YTU-YODA-KYBER/2026_teknofest-mikrodenetleyici-tasarimi/FPGA/verification/vivado_reports/code_coverage/index.html

# Code Coverage Raporları

YTU YODA KYBER · TEKNOFEST 2026 Çip Tasarım Yarışması
Vivado XSim 2025.2 · xelab --cc_type sbct (statement + branch + condition + toggle)
Üretim: 2026-08-07 23:41 · I2C güncelleme: 2026-09-06 11:04

Blok | Modül | Statement | Branch | Condition | Toggle | Rapor
AI_Accelerator | conv_accelerator | 99.32 | 98.36 | 100.00 | 68.53 | aç →
| yz_csr_wrapper | 95.24 | 85.71 | 100.00 | 33.33
| conv_buf_ram | 100.00 | 100.00 | — | 19.05
| weights_rom_p8 | 100.00 | — | — | —
| fc_weights_rom_p4 | 100.00 | — | — | —
GPIO | GPIO_AXI4_Lite | 100.00 | 92.31 | 100.00 | 60.00 | aç →
I2C | I2C_Master_AXI4_Lite_default | 96.22 | 78.08 | 92.86 | 6.99 | aç →
QSPI | QSPI_Master_AXI4_Lite | 92.86 | 80.42 | 91.67 | 27.57 | aç →
Timer | Timer_AXI4_Lite | 91.30 | 78.12 | 87.50 | 11.11 | aç →
UART_GU | UART_GU_AXI4_Lite | 96.52 | 83.64 | 100.00 | 10.63 | aç →
UART_YZ | UART_YZ_AXI4_Lite | 95.04 | 82.14 | 100.00 | 10.63 | aç →

Yüzdeler tasarım modülünün kendi skorudur; testbench, AXI protokol kontrolcüsü ve glbl dahil değildir. xcrg'nin dashboard'unda görünen toplam skor onları da saydığı için tasarımın kapsamını temsil etmez.

— işareti “kapsanmadı” değil, “ölçülecek madde yok” demektir. Ağırlık ROM'larında tek bir if/case bulunmadığı için dal ve koşul maddesi sıfırdır; anlamlı gösterge statement skorudur. Toggle'da da payda ROM dizisinin tamamıdır (weights_rom_p8 80×64 = 5120 bit, fc_weights_rom_p4 4000×32 = 128.000 bit) — bu bitler $readmemh ile bir kez yüklenip simülasyon boyunca hiç değişmediği için toggle sayacı onları asla saymaz.

Çevre birimleri blok testbench'leri ile, YZ hızlandırıcı ise sistem testi (ai_accel_test.sv — CPU, UART ve DMA yolu dahil gerçek çıkarım akışı) ile ölçülmüştür; iki ölçüm doğrudan kıyaslanmamalıdır.

## Detaya nasıl inilir

Yukarıdaki aç → bağlantısı ilgili bloğun dashboard.html sayfasını açar. Oradan Modules ya da Files sekmesine geçip modül adına tıklarsanız kaynak kodu satır satır görürsünüz: yeşil satırlar test tarafından çalıştırılmış, kırmızı satırlar çalıştırılmamıştır. Bir klasörde çok sayıda HTML olmasının sebebi budur — her modül ve her kaynak dosya için ayrı bir detay sayfası üretilir; hepsi tek bir rapordur, bölünmemelidir.

## Metin özet

README.md — klasör yapısı, sonuç tabloları ve raporların nasıl okunacağı.
