YTU-YODA-KYBER/2026_teknofest-mikrodenetleyici-tasarimi/asic/reports/synthesis/deney_arsivi/ant28_m3a015_clean_success/README.md

# `ant28_m3a015_clean` — uc fazli temiz teslim kosumu

Zorunlu `make asic_run` hedefinin temiz, bastan sona kosumudur. Faz 1 taban
katman ayariyla adim 38'e, faz 2 met3=%15 ile adim 43'e, faz 3 met3=%15 ve
anten jumper overlay'iyle signoff sonuna gitmistir. Paket kapisi 79/79 gecti;
anten 926 net / 979 pin, setup +0.9975 ns, hold +0.0711 ns ve 16 zorunlu
metrik sifirdir. Buyuk akis dizini disk alani icin silinmis, teslim gorunumleri
`results/` altinda ve karar kanitlari burada korunmustur.
