YTU-YODA-KYBER/2026_teknofest-mikrodenetleyici-tasarimi/asic/reports/synthesis/deney_arsivi/gplprobe_die3000/README.md

# `gplprobe_die3000` — 4200x3000 die, phi 1.01

Gorev belgesinde hazir bekleyen ucuz die-kucultme probudur. GPL teknik olarak
11150. iterasyonda overflow 0.0999 ile bitti, fakat HPWL 30.967.840 um oldu;
5.912.343 um tabanin 5.238 katidir ve 10 milyon kabul sinirini gecmistir.
Sonuc RED; sonraki PnR/signoff adimlari kosulmadi.
