YTU-YODA-KYBER/2026_teknofest-mikrodenetleyici-tasarimi/asic/reports/signoff/full_disconnected_pins_table.txt

┏━━━━━━━━━━━━━━━━━━━━━━━━━━━━━━━━━━━┳━━━━━━━━━━━━━━━━━━━━━━━━━━━━━━━━━━━┳━━━━━━━━━━━━━━┳━━━━━━━━━━━━━━━━━━━━━━━━━━━━━━━━━━━┳━━━━━━━━━━━━━━━━━━━━━━━━━━━━━━━━━━━┓
┃ Macro/Instance                    ┃ Power Pins                        ┃ Disconnected ┃ Signal Pins                       ┃ Disconnected                      ┃
┡━━━━━━━━━━━━━━━━━━━━━━━━━━━━━━━━━━━╇━━━━━━━━━━━━━━━━━━━━━━━━━━━━━━━━━━━╇━━━━━━━━━━━━━━╇━━━━━━━━━━━━━━━━━━━━━━━━━━━━━━━━━━━╇━━━━━━━━━━━━━━━━━━━━━━━━━━━━━━━━━━━┩
│ conv_accelerator_inst.u_conv_buf… │ conv_accelerator_inst.u_conv_buf… │              │ conv_accelerator_inst.u_conv_buf… │ conv_accelerator_inst.u_conv_buf… │
│                                   │ conv_accelerator_inst.u_conv_buf… │              │ conv_accelerator_inst.u_conv_buf… │ conv_accelerator_inst.u_conv_buf… │
│                                   │                                   │              │ conv_accelerator_inst.u_conv_buf… │ conv_accelerator_inst.u_conv_buf… │
│                                   │                                   │              │ conv_accelerator_inst.u_conv_buf… │ conv_accelerator_inst.u_conv_buf… │
│                                   │                                   │              │ conv_accelerator_inst.u_conv_buf… │ conv_accelerator_inst.u_conv_buf… │
│                                   │                                   │              │ conv_accelerator_inst.u_conv_buf… │ conv_accelerator_inst.u_conv_buf… │
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
│                                   │                                   │              │ yz_bram_ctrl_inst.yz_ram.u_mem.u… │                                   │
└───────────────────────────────────┴───────────────────────────────────┴──────────────┴───────────────────────────────────┴───────────────────────────────────┘
