YTU-YODA-KYBER/2026_teknofest-mikrodenetleyici-tasarimi/asic/reports/general/metrics.csv

Metric | Value
design__lint_error__count | 0
design__lint_timing_construct__count | 0
design__lint_warning__count | 881
design__inferred_latch__count | 0
design__instance__count | 1342890
design__instance__area | 1.4281E+7
design__instance_unmapped__count | 0
synthesis__check_error__count | 0
design__max_slew_violation__count__corner:nom_tt_025C_1v80 | 342
design__max_fanout_violation__count__corner:nom_tt_025C_1v80 | 0
design__max_cap_violation__count__corner:nom_tt_025C_1v80 | 19
power__internal__total | 0.03819098696112633
power__switching__total | 0.006617870647460222
power__leakage__total | 0.0002607748901937157
power__total | 0.045069631189107895
clock__skew__worst_hold__corner:nom_tt_025C_1v80 | -1.8995163757345652
clock__skew__worst_setup__corner:nom_tt_025C_1v80 | 1.692084742437688
timing__hold__ws__corner:nom_tt_025C_1v80 | 0.729422320967928
timing__setup__ws__corner:nom_tt_025C_1v80 | 9.301931932446479
timing__hold__tns__corner:nom_tt_025C_1v80 | 0.0
timing__setup__tns__corner:nom_tt_025C_1v80 | 0.0
timing__hold__wns__corner:nom_tt_025C_1v80 | 0
timing__setup__wns__corner:nom_tt_025C_1v80 | 0.0
timing__hold_vio__count__corner:nom_tt_025C_1v80 | 0
timing__hold_r2r__ws__corner:nom_tt_025C_1v80 | 0.729422
timing__hold_r2r_vio__count__corner:nom_tt_025C_1v80 | 0
timing__setup_vio__count__corner:nom_tt_025C_1v80 | 0
timing__setup_r2r__ws__corner:nom_tt_025C_1v80 | 9.301932
timing__setup_r2r_vio__count__corner:nom_tt_025C_1v80 | 0
design__max_slew_violation__count__corner:nom_ss_100C_1v60 | 428
design__max_fanout_violation__count__corner:nom_ss_100C_1v60 | 0
design__max_cap_violation__count__corner:nom_ss_100C_1v60 | 19
clock__skew__worst_hold__corner:nom_ss_100C_1v60 | -3.0789092147292405
clock__skew__worst_setup__corner:nom_ss_100C_1v60 | 2.775513675228004
timing__hold__ws__corner:nom_ss_100C_1v60 | 1.6801174260721896
timing__setup__ws__corner:nom_ss_100C_1v60 | 2.072312158308038
timing__hold__tns__corner:nom_ss_100C_1v60 | 0.0
timing__setup__tns__corner:nom_ss_100C_1v60 | 0.0
timing__hold__wns__corner:nom_ss_100C_1v60 | 0
timing__setup__wns__corner:nom_ss_100C_1v60 | 0.0
timing__hold_vio__count__corner:nom_ss_100C_1v60 | 0
timing__hold_r2r__ws__corner:nom_ss_100C_1v60 | 1.680117
timing__hold_r2r_vio__count__corner:nom_ss_100C_1v60 | 0
timing__setup_vio__count__corner:nom_ss_100C_1v60 | 0
timing__setup_r2r__ws__corner:nom_ss_100C_1v60 | 2.072312
timing__setup_r2r_vio__count__corner:nom_ss_100C_1v60 | 0
design__max_slew_violation__count__corner:nom_ff_n40C_1v95 | 333
design__max_fanout_violation__count__corner:nom_ff_n40C_1v95 | 0
design__max_cap_violation__count__corner:nom_ff_n40C_1v95 | 19
clock__skew__worst_hold__corner:nom_ff_n40C_1v95 | -1.3695270860563866
clock__skew__worst_setup__corner:nom_ff_n40C_1v95 | 1.2340994131471947
timing__hold__ws__corner:nom_ff_n40C_1v95 | 0.40188831178260853
timing__setup__ws__corner:nom_ff_n40C_1v95 | 11.985513365475772
timing__hold__tns__corner:nom_ff_n40C_1v95 | 0.0
timing__setup__tns__corner:nom_ff_n40C_1v95 | 0.0
timing__hold__wns__corner:nom_ff_n40C_1v95 | 0
timing__setup__wns__corner:nom_ff_n40C_1v95 | 0.0
timing__hold_vio__count__corner:nom_ff_n40C_1v95 | 0
timing__hold_r2r__ws__corner:nom_ff_n40C_1v95 | 0.401888
timing__hold_r2r_vio__count__corner:nom_ff_n40C_1v95 | 0
timing__setup_vio__count__corner:nom_ff_n40C_1v95 | 0
timing__setup_r2r__ws__corner:nom_ff_n40C_1v95 | 11.985514
timing__setup_r2r_vio__count__corner:nom_ff_n40C_1v95 | 0
design__max_slew_violation__count | 845
design__max_fanout_violation__count | 0
design__max_cap_violation__count | 22
clock__skew__worst_hold | -1.277792352539341
clock__skew__worst_setup | 1.1657856121531234
timing__hold__ws | 0.3899192190602206
timing__setup__ws | 1.9959714446189099
timing__hold__tns | 0.0
timing__setup__tns | 0.0
timing__hold__wns | 0
timing__setup__wns | 0.0
timing__hold_vio__count | 0
timing__hold_r2r__ws | 0.389919
timing__hold_r2r_vio__count | 0
timing__setup_vio__count | 0
timing__setup_r2r__ws | 1.995971
timing__setup_r2r_vio__count | 0
design__die__bbox | 0.0 0.0 4200.0 3600.0
design__core__bbox | 5.52 10.88 4194.28 3587.68
design__io | 96
design__die__area | 1.512E+7
design__core__area | 1.49824E+7
design__instance__count__stdcell | 282317
design__instance__area__stdcell | 1.66979E+6
design__instance__count__macros | 15
design__instance__area__macros | 4.17425E+6
design__instance__count__padcells | 0
design__instance__area__padcells | 0
design__instance__count__cover | 0
design__instance__area__cover | 0
design__instance__utilization | 0.390061
design__instance__utilization__stdcell | 0.154494
design__rows | 3838
design__rows:unithd | 3838
design__sites | 8077653
design__sites:unithd | 8077653
design__instance__count__class:macro | 15
design__instance__area__class:macro | 4.17425E+6
design__instance__count__class:buffer | 2
design__instance__area__class:buffer | 7.5072
design__instance__count__class:inverter | 1113
design__instance__area__class:inverter | 4395.47
design__instance__count__class:sequential_cell | 9470
design__instance__area__class:sequential_cell | 226855
design__instance__count__class:multi_input_combinational_cell | 59416
design__instance__area__class:multi_input_combinational_cell | 583506
flow__warnings__count | 1
flow__errors__count | 0
flow__warnings__count:ODB-0220 | 2
flow__warnings__type_count | 1
flow__warnings__count:ORD-0039 | 1
design__instance__count__class:fill_cell | 1060558
design__instance__area__class:fill_cell | 8.43697E+6
design__instance__count__class:tap_cell | 145253
design__instance__area__class:tap_cell | 181741
flow__warnings__count:PDN-0110 | 17
design__power_grid_violation__count__net:VPWR | 0
design__power_grid_violation__count__net:VGND | 0
design__power_grid_violation__count | 0
floorplan__design__io | 94
design__io__hpwl | 127418756
flow__warnings__count:GRT-0281 | 2
timing__drv__floating__nets | 2
timing__drv__floating__pins | 0
design__instance__displacement__total | 63245.7
design__instance__displacement__mean | 0.218
design__instance__displacement__max | 16.32
route__wirelength__estimated | 9943680
design__violations | 0
design__instance__count__class:timing_repair_buffer | 65850
design__instance__area__class:timing_repair_buffer | 657220
flow__warnings__count:RSZ-0020 | 1
flow__warnings__count:STA-1140 | 4
design__instance__count__class:clock_buffer | 930
design__instance__area__class:clock_buffer | 12426.9
design__instance__count__class:clock_inverter | 283
design__instance__area__class:clock_inverter | 3635.99
flow__warnings__count:RSZ-0065 | 1
design__instance__count__setup_buffer | 178
design__instance__count__hold_buffer | 350
global_route__vias | 981169
global_route__wirelength | 12510824
antenna__violating__nets | 979
antenna__violating__pins | 1034
route__antenna_violation__count | 979
flow__warnings__count:EST-0026 | 1001
flow__warnings__count:RSZ-0062 | 1
flow__warnings__count:RSZ-0064 | 1
antenna_diodes_count | 0
route__net | 137149
route__net__special | 2
route__drc_errors__iter:0 | 60614
route__wirelength__iter:0 | 10283866
route__drc_errors__iter:1 | 29445
route__wirelength__iter:1 | 10263769
route__drc_errors__iter:2 | 26521
route__wirelength__iter:2 | 10260211
route__drc_errors__iter:3 | 2894
route__wirelength__iter:3 | 10265166
route__drc_errors__iter:4 | 226
route__wirelength__iter:4 | 10265436
route__drc_errors__iter:5 | 55
route__wirelength__iter:5 | 10265468
route__drc_errors__iter:6 | 16
route__wirelength__iter:6 | 10265441
route__drc_errors__iter:7 | 16
route__wirelength__iter:7 | 10265442
route__drc_errors__iter:8 | 0
route__wirelength__iter:8 | 10265434
route__drc_errors | 0
route__wirelength | 10265434
route__vias | 988254
route__vias__singlecut | 988254
route__vias__multicut | 0
flow__warnings__count:DRT-0349 | 10
design__disconnected_pin__count | 480
design__critical_disconnected_pin__count | 0
route__wirelength__max | 1742.26
timing__unannotated_net__count__corner:nom_tt_025C_1v80 | 945
timing__unannotated_net_filtered__count__corner:nom_tt_025C_1v80 | 0
timing__unannotated_net__count__corner:nom_ss_100C_1v60 | 945
timing__unannotated_net_filtered__count__corner:nom_ss_100C_1v60 | 0
timing__unannotated_net__count__corner:nom_ff_n40C_1v95 | 945
timing__unannotated_net_filtered__count__corner:nom_ff_n40C_1v95 | 0
design__max_slew_violation__count__corner:min_tt_025C_1v80 | 339
design__max_fanout_violation__count__corner:min_tt_025C_1v80 | 0
design__max_cap_violation__count__corner:min_tt_025C_1v80 | 17
clock__skew__worst_hold__corner:min_tt_025C_1v80 | -1.7587988230303337
clock__skew__worst_setup__corner:min_tt_025C_1v80 | 1.5895979427122682
timing__hold__ws__corner:min_tt_025C_1v80 | 0.7546248284289044
timing__setup__ws__corner:min_tt_025C_1v80 | 9.463615936541427
timing__hold__tns__corner:min_tt_025C_1v80 | 0.0
timing__setup__tns__corner:min_tt_025C_1v80 | 0.0
timing__hold__wns__corner:min_tt_025C_1v80 | 0
timing__setup__wns__corner:min_tt_025C_1v80 | 0.0
timing__hold_vio__count__corner:min_tt_025C_1v80 | 0
timing__hold_r2r__ws__corner:min_tt_025C_1v80 | 0.754625
timing__hold_r2r_vio__count__corner:min_tt_025C_1v80 | 0
timing__setup_vio__count__corner:min_tt_025C_1v80 | 0
timing__setup_r2r__ws__corner:min_tt_025C_1v80 | 9.463616
timing__setup_r2r_vio__count__corner:min_tt_025C_1v80 | 0
timing__unannotated_net__count__corner:min_tt_025C_1v80 | 945
timing__unannotated_net_filtered__count__corner:min_tt_025C_1v80 | 0
design__max_slew_violation__count__corner:min_ss_100C_1v60 | 361
design__max_fanout_violation__count__corner:min_ss_100C_1v60 | 0
design__max_cap_violation__count__corner:min_ss_100C_1v60 | 17
clock__skew__worst_hold__corner:min_ss_100C_1v60 | -2.839491389054466
clock__skew__worst_setup__corner:min_ss_100C_1v60 | 2.5822589242227245
timing__hold__ws__corner:min_ss_100C_1v60 | 1.6857054007577716
timing__setup__ws__corner:min_ss_100C_1v60 | 2.3722748881200473
timing__hold__tns__corner:min_ss_100C_1v60 | 0.0
timing__setup__tns__corner:min_ss_100C_1v60 | 0.0
timing__hold__wns__corner:min_ss_100C_1v60 | 0
timing__setup__wns__corner:min_ss_100C_1v60 | 0.0
timing__hold_vio__count__corner:min_ss_100C_1v60 | 0
timing__hold_r2r__ws__corner:min_ss_100C_1v60 | 1.685705
timing__hold_r2r_vio__count__corner:min_ss_100C_1v60 | 0
timing__setup_vio__count__corner:min_ss_100C_1v60 | 0
timing__setup_r2r__ws__corner:min_ss_100C_1v60 | 2.372275
timing__setup_r2r_vio__count__corner:min_ss_100C_1v60 | 0
timing__unannotated_net__count__corner:min_ss_100C_1v60 | 945
timing__unannotated_net_filtered__count__corner:min_ss_100C_1v60 | 0
design__max_slew_violation__count__corner:min_ff_n40C_1v95 | 332
design__max_fanout_violation__count__corner:min_ff_n40C_1v95 | 0
design__max_cap_violation__count__corner:min_ff_n40C_1v95 | 17
clock__skew__worst_hold__corner:min_ff_n40C_1v95 | -1.277792352539341
clock__skew__worst_setup__corner:min_ff_n40C_1v95 | 1.1657856121531234
timing__hold__ws__corner:min_ff_n40C_1v95 | 0.4031228798209077
timing__setup__ws__corner:min_ff_n40C_1v95 | 12.1206088596466
timing__hold__tns__corner:min_ff_n40C_1v95 | 0.0
timing__setup__tns__corner:min_ff_n40C_1v95 | 0.0
timing__hold__wns__corner:min_ff_n40C_1v95 | 0
timing__setup__wns__corner:min_ff_n40C_1v95 | 0.0
timing__hold_vio__count__corner:min_ff_n40C_1v95 | 0
timing__hold_r2r__ws__corner:min_ff_n40C_1v95 | 0.403123
timing__hold_r2r_vio__count__corner:min_ff_n40C_1v95 | 0
timing__setup_vio__count__corner:min_ff_n40C_1v95 | 0
timing__setup_r2r__ws__corner:min_ff_n40C_1v95 | 12.120609
timing__setup_r2r_vio__count__corner:min_ff_n40C_1v95 | 0
timing__unannotated_net__count__corner:min_ff_n40C_1v95 | 945
timing__unannotated_net_filtered__count__corner:min_ff_n40C_1v95 | 0
design__max_slew_violation__count__corner:max_tt_025C_1v80 | 344
design__max_fanout_violation__count__corner:max_tt_025C_1v80 | 0
design__max_cap_violation__count__corner:max_tt_025C_1v80 | 22
clock__skew__worst_hold__corner:max_tt_025C_1v80 | -2.053867800633693
clock__skew__worst_setup__corner:max_tt_025C_1v80 | 1.822692603993761
timing__hold__ws__corner:max_tt_025C_1v80 | 0.714448964655938
timing__setup__ws__corner:max_tt_025C_1v80 | 9.232181502817912
timing__hold__tns__corner:max_tt_025C_1v80 | 0.0
timing__setup__tns__corner:max_tt_025C_1v80 | 0.0
timing__hold__wns__corner:max_tt_025C_1v80 | 0
timing__setup__wns__corner:max_tt_025C_1v80 | 0.0
timing__hold_vio__count__corner:max_tt_025C_1v80 | 0
timing__hold_r2r__ws__corner:max_tt_025C_1v80 | 0.714449
timing__hold_r2r_vio__count__corner:max_tt_025C_1v80 | 0
timing__setup_vio__count__corner:max_tt_025C_1v80 | 0
timing__setup_r2r__ws__corner:max_tt_025C_1v80 | 9.232182
timing__setup_r2r_vio__count__corner:max_tt_025C_1v80 | 0
timing__unannotated_net__count__corner:max_tt_025C_1v80 | 945
timing__unannotated_net_filtered__count__corner:max_tt_025C_1v80 | 0
design__max_slew_violation__count__corner:max_ss_100C_1v60 | 845
design__max_fanout_violation__count__corner:max_ss_100C_1v60 | 0
design__max_cap_violation__count__corner:max_ss_100C_1v60 | 22
clock__skew__worst_hold__corner:max_ss_100C_1v60 | -3.348767136154092
clock__skew__worst_setup__corner:max_ss_100C_1v60 | 3.0098528965552998
timing__hold__ws__corner:max_ss_100C_1v60 | 1.682658060513596
timing__setup__ws__corner:max_ss_100C_1v60 | 1.9959714446189099
timing__hold__tns__corner:max_ss_100C_1v60 | 0.0
timing__setup__tns__corner:max_ss_100C_1v60 | 0.0
timing__hold__wns__corner:max_ss_100C_1v60 | 0
timing__setup__wns__corner:max_ss_100C_1v60 | 0.0
timing__hold_vio__count__corner:max_ss_100C_1v60 | 0
timing__hold_r2r__ws__corner:max_ss_100C_1v60 | 1.682658
timing__hold_r2r_vio__count__corner:max_ss_100C_1v60 | 0
timing__setup_vio__count__corner:max_ss_100C_1v60 | 0
timing__setup_r2r__ws__corner:max_ss_100C_1v60 | 1.995971
timing__setup_r2r_vio__count__corner:max_ss_100C_1v60 | 0
timing__unannotated_net__count__corner:max_ss_100C_1v60 | 945
timing__unannotated_net_filtered__count__corner:max_ss_100C_1v60 | 0
design__max_slew_violation__count__corner:max_ff_n40C_1v95 | 333
design__max_fanout_violation__count__corner:max_ff_n40C_1v95 | 0
design__max_cap_violation__count__corner:max_ff_n40C_1v95 | 22
clock__skew__worst_hold__corner:max_ff_n40C_1v95 | -1.4651071881502784
clock__skew__worst_setup__corner:max_ff_n40C_1v95 | 1.3202757039119486
timing__hold__ws__corner:max_ff_n40C_1v95 | 0.3899192190602206
timing__setup__ws__corner:max_ff_n40C_1v95 | 11.903948386174214
timing__hold__tns__corner:max_ff_n40C_1v95 | 0.0
timing__setup__tns__corner:max_ff_n40C_1v95 | 0.0
timing__hold__wns__corner:max_ff_n40C_1v95 | 0
timing__setup__wns__corner:max_ff_n40C_1v95 | 0.0
timing__hold_vio__count__corner:max_ff_n40C_1v95 | 0
timing__hold_r2r__ws__corner:max_ff_n40C_1v95 | 0.389919
timing__hold_r2r_vio__count__corner:max_ff_n40C_1v95 | 0
timing__setup_vio__count__corner:max_ff_n40C_1v95 | 0
timing__setup_r2r__ws__corner:max_ff_n40C_1v95 | 11.903949
timing__setup_r2r_vio__count__corner:max_ff_n40C_1v95 | 0
timing__unannotated_net__count__corner:max_ff_n40C_1v95 | 945
timing__unannotated_net_filtered__count__corner:max_ff_n40C_1v95 | 0
timing__unannotated_net__count | 945
timing__unannotated_net_filtered__count | 0
design_powergrid__voltage__worst__net:VPWR__corner:nom_tt_025C_1v80 | 1.79947
design_powergrid__drop__average__net:VPWR__corner:nom_tt_025C_1v80 | 1.8
design_powergrid__drop__worst__net:VPWR__corner:nom_tt_025C_1v80 | 0.000530634
design_powergrid__voltage__worst__net:VGND__corner:nom_tt_025C_1v80 | 0.000532258
design_powergrid__drop__average__net:VGND__corner:nom_tt_025C_1v80 | 0.00000419697
design_powergrid__drop__worst__net:VGND__corner:nom_tt_025C_1v80 | 0.000532258
design_powergrid__voltage__worst | 0.000532258
design_powergrid__voltage__worst__net:VPWR | 1.79947
design_powergrid__drop__worst | 0.000532258
design_powergrid__drop__worst__net:VPWR | 0.000530634
design_powergrid__voltage__worst__net:VGND | 0.000532258
design_powergrid__drop__worst__net:VGND | 0.000532258
ir__voltage__worst | 1.8000000000000000444089209850062616169452667236328125
ir__drop__avg | 0.000004210000000000000349473054661597615222490276210010051727294921875
ir__drop__worst | 0.00053100000000000000498212582300538997515104711055755615234375
design__xor_difference__count | 0
magic__drc_error__count | 0
klayout__drc_error__count | 0
magic__illegal_overlap__count | 0
design__lvs_device_difference__count | 0
design__lvs_net_difference__count | 0
design__lvs_property_fail__count | 0
design__lvs_error__count | 0
design__lvs_unmatched_device__count | 0
design__lvs_unmatched_net__count | 0
design__lvs_unmatched_pin__count | 0
