YTU-YODA-KYBER/2026_teknofest-mikrodenetleyici-tasarimi/asic/reports/routing/wire_lengths.csv

net | length_um
clknet_6_16_0_clk_i_regs | 1.74226mm
I2C_SDA | 1.42175mm
clknet_leaf_1_clk_i | 1.30358mm
clknet_6_13_0_clk_i_regs | 1.26215mm
clknet_6_15_0_clk_i_regs | 1.16936mm
net30918 | 1.13246mm
clknet_leaf_8_clk_i | 1.10154mm
clknet_6_36_0_clk_i_regs | 1.06873mm
net30932 | 1.05702mm
net30916 | 1.04366mm
QSPI_IO0 | 1.0343mm
clknet_6_46_0_clk_i_regs | 1.02663mm
clknet_leaf_3_clk_i | 1.02578mm
QSPI_IO2 | 1.01334mm
QSPI_IO3 | 994.17µm
QSPI_IO1 | 975.14µm
clknet_6_3_0_clk_i_regs | 952µm
clknet_6_0_0_clk_i_regs | 916.23µm
clknet_6_1_0_clk_i_regs | 887.75µm
clknet_6_19_0_clk_i_regs | 885.49µm
clknet_4_9_0_clk_i_regs | 882.39µm
clknet_6_9_0_clk_i_regs | 875.56µm
clknet_6_12_0_clk_i_regs | 843.21µm
net34302 | 836.29µm
clknet_6_2_0_clk_i_regs | 835.1µm
clknet_4_1_0_clk_i_regs | 820.26µm
clknet_4_0_0_clk_i_regs | 816.27µm
clknet_4_10_0_clk_i_regs | 808.38µm
clknet_4_4_0_clk_i_regs | 803.25µm
clknet_6_5_0_clk_i_regs | 800.26µm
clknet_4_3_0_clk_i_regs | 790.93µm
clknet_3_1_0_clk_i_regs | 788.41µm
clknet_6_14_0_clk_i_regs | 769.35µm
net30942 | 762.37µm
clknet_6_18_0_clk_i_regs | 760.78µm
clknet_4_5_0_clk_i_regs | 759.97µm
clknet_4_8_0_clk_i_regs | 757.73µm
clknet_4_11_0_clk_i_regs | 749.23µm
clknet_3_2_0_clk_i_regs | 728.47µm
clknet_3_5_0_clk_i_regs | 725.02µm
clknet_4_2_0_clk_i_regs | 722.82µm
clknet_6_58_0_clk_i_regs | 712.42µm
clknet_0_clk_i_regs | 709.49µm
clknet_2_0_1_clk_i_regs | 706.4µm
clknet_6_30_0_clk_i_regs | 705.54µm
clknet_0_clk_i | 705µm
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
net34000 | 260.05µm
net46982 | 260.05µm
net41487 | 260.04µm
net41531 | 260.04µm
net47788 | 260.04µm
net37298 | 260.035µm
net39500 | 260.02µm
net46314 | 260.02µm
uart_gu_inst.UART_CPB\[2\] | 260.005µm
net45072 | 260µm
net45095 | 260µm
net46174 | 260µm
net48469 | 260µm
net37043 | 259.98µm
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
