YTU-YODA-KYBER/2026_teknofest-mikrodenetleyici-tasarimi/FPGA/verification/ai_accel_reports/images/accuracy_board.png

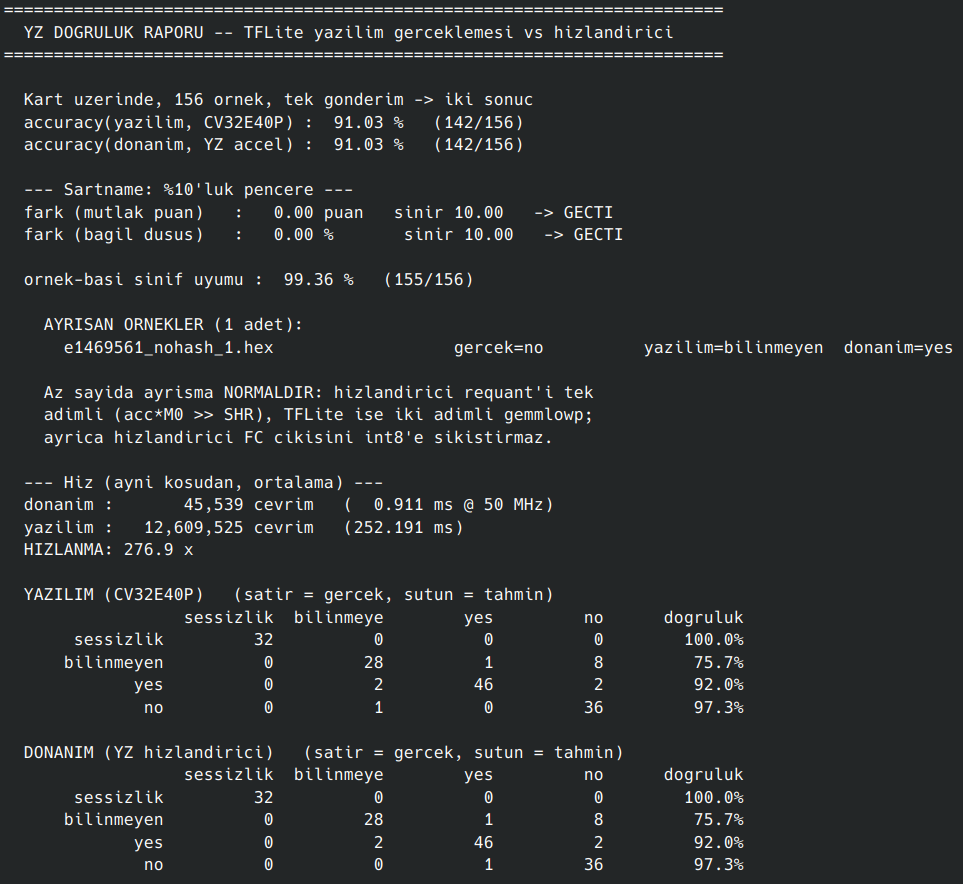
FPGA/verification/ai_accel_reports/images/accuracy_board.png
