YTU-YODA-KYBER/2026_teknofest-mikrodenetleyici-tasarimi/FPGA/verification/uvm/coverage/index-sort-f.html

LCOV - code coverage report



Current view: | top level | | | Coverage | Total | Hit
Test: | YODA KYBER -- UVM satir kapsami | | Lines: | 96.4 % | 1350 | 1301
Test Date: | 2026-09-07 22:07:37 | | Functions: | - | 0 | 0
Legend: | Rating: low: < 75 % medium: >= 75 % high: >= 90 %





Directory Sort by file name | Line Coverage Sort by line coverage
| Rate | | Total | Hit
AI_Accelerator/

100.0%
100.0 % | 53 | 53
Peripherals/GPIO/

93.2% 93.2%
93.2 % | 207 | 193
Peripherals/I2C/

97.6% 97.6%
97.6 % | 249 | 243
Peripherals/QSPI/

95.0% 95.0%
95.0 % | 399 | 379
Peripherals/Timer/

97.1% 97.1%
97.1 % | 105 | 102
Peripherals/UART_GU/

98.2% 98.2%
98.2 % | 164 | 161
Peripherals/UART_YZ/

98.3% 98.3%
98.3 % | 173 | 170
Note: 'Function Coverage' columns elided as function owner is not identified.



Generated by: LCOV version 2.0-1 (https://github.com//linux-test-project/lcov)
