YTU-YODA-KYBER/2026_teknofest-mikrodenetleyici-tasarimi/FPGA/verification/vivado_reports/testbench_&_protocol_check/index.html

# Directed Test ve AXI Protokol Kontrolü

YTU YODA KYBER · TEKNOFEST 2026 Çip Tasarım Yarışması
Vivado XSim 2025.2 · xc7a100tcsg324-1 · 50 MHz · şartname madde 5.2-2 / 5.2-3 / 5.2-4
Ölçüm: 2026-08-23

8 koşum · 0 başarısız kontrol · 0 AXI protokol ihlali

## Blok seviyesi testler

Birim | Modül | Test | Kontrol | Geçen | Kalan | İzlenen arayüz | AXI ihlali | Uyarı | Sim süresi | Rapor
Timer | Timer_AXI4_Lite | 6 | 8 | 8 | 0 | 1 | 0 | 0 | 50,14 µs | aç →
GPIO | GPIO_AXI4_Lite | 15 | 50 | 50 | 0 | 1 | 0 | 0 | 31,07 µs | aç →
I2C Master | I2C_Master_AXI4_Lite | 10 | 10 | 10 | 0 | 1 | 0 | 0 | 1,080 ms | aç →
QSPI Master | QSPI_Master_AXI4_Lite | 2 | 12 | 12 | 0 | 1 | 0 | 0 | 6,339 ms | aç →
UART_GU | UART_GU_AXI4_Lite | 4 | 10 | 10 | 0 | 1 | 0 | 0 | 1,068 ms | aç →
UART_YZ | UART_YZ_AXI4_Lite | 4 | 10 | 10 | 0 | 1 | 0 | 0 | 1,068 ms | aç →
Toplam | — | 41 | 100 | 100 | 0 | — | 0 | 0 | — | —

## Sistem seviyesi testler

Test | Ne sürüyor | Senaryo | Kontrol | Geçen | İzlenen arayüz | AXI ihlali | Uyarı | Sim süresi | Rapor
Boot zinciri | flasher → QSPI flash → boot → DMA → INSTRRAM → atlama | 2 faz | 5 | 5 | 15 | 0 | 0 | 10,908 ms | aç →
YZ hızlandırıcı | UART → DMA → YZ RAM → çıkarım → kesme → 7-segment | 3 | 12 | 12 | 15 | 0 | 0 | 513,111 ms | aç →

## YZ hızlandırıcı — üç senaryo

Senaryo | Girdi (1960 bayt) | Sınıf | GPIO_ODR | FC skorları (bit-exact) | Çevrim | Sonuç
EVET | input_data_yes.hex | 2 | 7 | -58032 · 21583 · 48674 · -4777 | 45.517 | GEÇTİ
HAYIR | input_data_no.hex | 3 | 8 | -30588 · 7509 · 7419 · 18543 | 45.517 | GEÇTİ
SESSİZLİK | input_data_sessizlik.hex | 0 | 9 | 427 · -518 · -94 · 186 | 45.517 | GEÇTİ

50 MHz'de 910,3 µs → 1098,5 çıkarım/s (şartname Tablo 3-1 "Sistem performansı"). Üç senaryoda çevrim sayısının aynı olması beklenen sonuçtur: hızlandırıcı veriye bağlı dallanma içermez.

## AXI protokol kontrolü

Protokol kontrolü ayrı bir koşum değildir. axi4lite_protocol_checker (10 kategori, 40 kural — 33 assert property + 7 prosedürel kontrol) her testbench'e bind ile bağlıdır ve testin kendi ürettiği gerçek trafiği canlı denetler. İki sistem testinde axi4lite_bind.svh ile tasarımdaki 15 AXI4-Lite arayüzünün tamamı izlenir.

======================================================================
            AXI4-LITE PROTOKOL KONTROL OZETI
======================================================================
  Izlenen AXI arayuzu sayisi : 15
  Protokol ihlali            : 0
  Uyari (stall/watchdog)     : 0
  SONUC                      : GECTI  (0 ihlal)
======================================================================

Kontrolcü trafik görmeyen arayüzü sessizce geçmez. O arayüz için *** TRAFIK YOK -- bu arayuz HIC test edilmedi *** satırını basar; böylece “0 ihlal” ile “hiç sürülmedi” karıştırılamaz. İki sistem senaryosu birleştiğinde 15 arayüzün 14'ü gerçek trafik altında denetlenir; kapsam dışında kalan tek arayüz Boot ROM'un interconnect tarafındaki ikinci okuma portudur (BOOTROM_ICN).

En yoğun koşum AI_Accelerator/'dır: CPU_INSTR_M arayüzünde 8.551.805 okuma el sıkışması denetlendi. CV32E40P'nin komut önbelleği yoktur, bu yüzden her komut getirme ayrı bir AXI okumasıdır.

## Metin özet

README.md — klasör yapısı, izlenen 15 arayüzün listesi, 40 kuralın kategorileri, koşumların nasıl tekrar üretileceği ve okuma notları. Her birim klasöründe o koşumun kendi README.md'si (hangi test neyi doğruluyor) ve xsim_console.log (ham konsol çıktısının tamamı) vardır.
