YTU-YODA-KYBER/2026_teknofest-mikrodenetleyici-tasarimi/FPGA/verification/uvm/coverage/Peripherals/I2C/I2C_Master_AXI4_Lite.sv.gcov.html

LCOV - code coverage report



Current view: | top level - Peripherals/I2C - I2C_Master_AXI4_Lite.sv | | | Coverage | Total | Hit
Test: | YODA KYBER -- UVM satir kapsami | | Lines: | 97.6 % | 249 | 243
Test Date: | 2026-09-07 22:07:37 | | Functions: | - | 0 | 0
Legend: | Lines: hit not hit





Line data Source code

1 : // =========================================================
2 : // I2C_Master_AXI4_Lite
3 : // ---------------------------------------------------------
4 :
5 : module I2C_Master_AXI4_Lite#(
6 :
7 : parameter CLK_FREQ_HZ = 50_000_000,
8 : parameter I2C_FREQ_HZ = 400_000
9 : )
10 : (
11 : // clock ve reset sinyalleri
12 147615 : input logic clk_i,
13 42 : input logic rst_n,
14 :
15 1137 : output logic I2C_SCL,
16 417 : inout logic I2C_SDA,
17 :
18 : // AW Portları
19 108 : input logic [31:0] awaddr,
20 545 : input logic awvalid,
21 590 : output logic awready,
22 :
23 : // WD Portları
24 125 : input logic [31:0] wdata,
25 545 : input logic wvalid,
26 590 : output logic wready,
27 :
28 : // B Portları
29 0 : output logic [ 1:0] bresp,
30 554 : output logic bvalid,
31 545 : input logic bready,
32 :
33 : // AR Portları
34 103 : input logic [31:0] araddr,
35 2021 : input logic arvalid,
36 2066 : output logic arready,
37 :
38 : // R Portları
39 2021 : input logic rready,
40 76 : output logic [31:0] rdata,
41 0 : output logic [ 1:0] rresp,
42 2030 : output logic rvalid
43 : );
44 :
45 0 : wire I2C_SDA_out; // I2C_SDA'ya sürülecek değer (her zaman 0; open-drain)
46 330 : wire I2C_SDA_oe; // 1 = sür (low), 0 = serbest bırak (high-Z)
47 417 : wire I2C_SDA_in; // pinden okunan değer
48 :
49 : // =====================================================
50 : // Bidirectional I/O Buffer (Xilinx primitive)
51 : // =====================================================
52 : IOBUF iobuf_i2c_sda (
53 : .I (I2C_SDA_out), // sürülecek değer
54 : .T (~I2C_SDA_oe), // tristate enable (active LOW: 0=sür, 1=bırak)
55 : .O (I2C_SDA_in), // okunan değer
56 : .IO(I2C_SDA) // fiziksel pin
57 : );
58 :
59 24 : logic [31: 0] I2C_NBY;
60 27 : logic [31: 0] I2C_ADR;
61 6 : logic [31: 0] I2C_RDR;
62 28 : logic [31: 0] I2C_TDR;
63 24 : logic [31: 0] I2C_CFG;
64 :
65 68964 : logic [ 6: 0] freq_div_cnt;
66 39 : logic freq_div_en;
67 : // CLK_FREQ_HZ / (2*I2C_FREQ_HZ) tam sayi degilse taban ve taban+1
68 : // sistem-cevrimli yari-periyotlari kalan akumulatoru ile dagitilir.
69 : // Boylece uzun donem SCL ortalamasi parametrede istenen frekansta kalir.
70 : localparam integer HALF_DEN = 2 * I2C_FREQ_HZ;
71 : localparam integer HALF_BASE = CLK_FREQ_HZ / HALF_DEN;
72 : localparam integer HALF_REM = CLK_FREQ_HZ % HALF_DEN;
73 : localparam integer HALF_FRAC_INIT =
74 : (HALF_REM == 0) ? 0 : (HALF_DEN - HALF_REM);
75 1137 : logic [31:0] half_frac_acc;
76 1104 : logic [ 6:0] half_cycles_q;
77 198 : logic [ 3: 0] current_state;
78 231 : logic [ 7: 0] shift_byte; // gönderilen/alınan bayt
79 480 : logic [ 2: 0] shift_cnt; // 8 bit sayacı
80 12 : logic [ 2: 0] data_cnt; // yazmada kaçıncı veri baytında olduğumuz (0..NBY-1)
81 12 : logic [ 2: 0] rx_idx; // okumada kaçıncı baytı aldığımız (0..NBY-1)
82 21 : logic [ 1: 0] phase; // gönderilen bayt türü (aşağıda)
83 12 : logic r_w; // 0 = iletiyoruz (TX), 1 = alıyoruz (RX)
84 6 : logic is_read_op; // transfer tipi: 1 = okuma, 0 = yazma
85 327 : logic sda_out_val; // SDA hedef değeri (0=low sür, 1=serbest bırak)
86 :
87 : // ---- gönderilen bayt türü (phase) ----
88 : localparam logic [1:0] PH_ADDRW = 2'd0; // adres + WRITE biti (her transferin başı)
89 : localparam logic [1:0] PH_WDATA = 2'd1; // yazma veri baytı
90 : localparam logic [1:0] PH_ADDRR = 2'd2; // adres + READ biti (okumada repeated-start sonrası)
91 :
92 : // ---- FSM state'leri ----
93 : localparam logic [3:0]
94 : S_IDLE = 4'd0,
95 : S_TXBYTE = 4'd1, // shift_byte'ı 8 bit dışarı kaydır (adres ya da yazma verisi)
96 : S_TXREL = 4'd2, // ACK için SDA'yı serbest bırak (ara durum, off-by-one'ı önler)
97 : S_TXACK = 4'd3, // gönderilen bayttan sonra ACK örnekle ve yönlendir
98 : S_REPSTA1 = 4'd4, // repeated-start: SCL low iken SDA'yı bırak
99 : S_REPSTA2 = 4'd5, // repeated-start: SCL high iken SDA'yı düşür (START koşulu)
100 : S_RXBYTE = 4'd6, // 8 bit içeri kaydır (slave'den veri al)
101 : S_RXACK = 4'd7, // alınan bayttan sonra ACK/NACK sür
102 : S_STOP1 = 4'd8, // STOP: SCL low iken SDA low
103 : S_STOP2 = 4'd9, // STOP: SCL high iken SDA high (STOP koşulu) + bitir
104 : S_ABORT = 4'd10; // NACK: transferi temiz iptal et (DONE set etme)
105 :
106 : // SDA sürme: open-drain -> sadece 0 sürülür, 1 için bırakılır
107 : assign I2C_SDA_out = 1'b0;
108 : assign I2C_SDA_oe = ~sda_out_val; // sda_out_val=0 -> oe=1 (low sür); =1 -> oe=0 (bırak)
109 :
110 : // ---------------------------------------------------------
111 : // SCL DIVIDER (400 kHz)
112 : // ---------------------------------------------------------
113 147621 : always @(posedge clk_i or negedge rst_n) begin
114 147399 : if(!rst_n)begin
115 222 : I2C_SCL <= 1;
116 222 : freq_div_cnt <= 0;
117 222 : half_frac_acc <= HALF_FRAC_INIT;
118 222 : half_cycles_q <= HALF_BASE;
119 : end
120 147399 : else begin
121 138990 : if (freq_div_en) begin
122 136785 : if (freq_div_cnt == (half_cycles_q - 1)) begin
123 2205 : freq_div_cnt <= 0;
124 2205 : I2C_SCL <= ~I2C_SCL;
125 1104 : if ((half_frac_acc + HALF_REM) >= HALF_DEN) begin
126 1104 : half_frac_acc <= half_frac_acc + HALF_REM - HALF_DEN;
127 1104 : half_cycles_q <= HALF_BASE + 1;
128 1101 : end else begin
129 1101 : half_frac_acc <= half_frac_acc + HALF_REM;
130 1101 : half_cycles_q <= HALF_BASE;
131 : end
132 : end
133 136785 : else freq_div_cnt <= freq_div_cnt + 1;
134 : end
135 8409 : else begin
136 8409 : freq_div_cnt <= 0;
137 8409 : I2C_SCL <= 1;
138 8409 : half_frac_acc <= HALF_FRAC_INIT;
139 8409 : half_cycles_q <= HALF_BASE;
140 : end
141 : end
142 : end
143 :
144 : // ---------------------------------------------------------
145 : // ANA KONTROL (AXI + I2C çekirdek)
146 : // ---------------------------------------------------------
147 147621 : always @(posedge clk_i or negedge rst_n) begin
148 :
149 147399 : if(!rst_n)begin
150 222 : I2C_NBY <= 0;
151 222 : I2C_ADR <= 0;
152 222 : I2C_RDR <= 0;
153 222 : I2C_TDR <= 0;
154 222 : I2C_CFG <= 0;
155 :
156 222 : shift_byte <= 0;
157 222 : shift_cnt <= 0;
158 222 : data_cnt <= 0;
159 222 : rx_idx <= 0;
160 222 : phase <= PH_ADDRW;
161 222 : r_w <= 0;
162 222 : is_read_op <= 0;
163 222 : freq_div_en <= 0;
164 222 : bresp <= 0;
165 222 : bvalid <= 0;
166 222 : rdata <= 0;
167 222 : rresp <= 0;
168 222 : rvalid <= 0;
169 222 : awready <= 1;
170 222 : wready <= 1;
171 222 : arready <= 1;
172 222 : sda_out_val <= 1;
173 222 : current_state <= S_IDLE;
174 : end
175 147399 : else begin
176 :
177 : // ---------------------------------------------------------
178 : // AXI YAZMA
179 : // ---------------------------------------------------------
180 554 : if (awvalid && wvalid && awready && wready) begin
181 554 : awready <= 1'b0;
182 554 : wready <= 1'b0;
183 554 : bvalid <= 1'b1;
184 554 : bresp <= 2'b00;
185 :
186 554 : case (awaddr[7:0])
187 91 : 8'h00:if (wdata > 4) I2C_NBY <= 4;
188 48 : else if (!wdata) I2C_NBY <= 1;
189 48 : else I2C_NBY <= wdata;
190 168 : 8'h04: I2C_ADR <= wdata;
191 158 : 8'h0C: I2C_TDR <= wdata;
192 36 : 8'h10: I2C_CFG <= wdata;
193 86 : 8'h14: begin
194 72 : if (wdata[0]) I2C_CFG[1] <= 1'b0; // WR_DONE temizle
195 68 : if (wdata[1]) I2C_CFG[3] <= 1'b0; // RD_DONE temizle
196 : end
197 : endcase
198 : end
199 146291 : else if (bvalid && bready) begin
200 554 : bvalid <= 1'b0;
201 554 : awready <= 1'b1;
202 554 : wready <= 1'b1;
203 : end
204 :
205 : // ---------------------------------------------------------
206 : // AXI OKUMA
207 : // ---------------------------------------------------------
208 2030 : if (arvalid && arready) begin
209 2030 : arready <= 0;
210 2030 : rvalid <= 1;
211 2030 : rresp <= 2'b00;
212 :
213 2030 : case (araddr[7:0])
214 78 : 8'h00: rdata <= I2C_NBY;
215 161 : 8'h04: rdata <= I2C_ADR;
216 85 : 8'h08: rdata <= I2C_RDR;
217 159 : 8'h0C: rdata <= I2C_TDR;
218 1473 : 8'h10: rdata <= I2C_CFG;
219 74 : default: rdata <= 32'h0;
220 : endcase
221 : end
222 143339 : else if (rvalid && rready) begin
223 2030 : rvalid <= 0;
224 2030 : arready <= 1;
225 : end
226 :
227 : // ---------------------------------------------------------
228 : // I2C ÇEKİRDEĞİ
229 : // ---------------------------------------------------------
230 139029 : if (I2C_CFG[0] || I2C_CFG[2]) begin
231 :
232 : // ---- TRANSFER BAŞLATMA + START koşulu ----
233 39 : if (!freq_div_en) begin
234 39 : freq_div_en <= 1'b1;
235 39 : sda_out_val <= 1'b0; // SCL idle high iken SDA low -> START
236 39 : shift_byte <= {I2C_ADR[6:0], 1'b0}; // her transfer adres+W ile başlar
237 39 : shift_cnt <= 3'd7;
238 39 : phase <= PH_ADDRW;
239 39 : is_read_op <= (I2C_CFG[2] && !I2C_CFG[0]); // hem yazma hem okuma set ise: yazma önceliği
240 39 : r_w <= 1'b0;
241 39 : data_cnt <= 0;
242 39 : rx_idx <= 0;
243 39 : awready <= 1'b0;
244 39 : wready <= 1'b0;
245 39 : current_state <= S_TXBYTE;
246 : end
247 :
248 136749 : else if (freq_div_cnt == ((half_cycles_q - 1) / 2)) begin
249 2241 : case (current_state)
250 :
251 : // ---------- BAYT GÖNDER (adres ya da yazma verisi) ----------
252 1344 : S_TXBYTE: begin
253 696 : if (!I2C_SCL) begin
254 696 : sda_out_val <= shift_byte[7];
255 696 : shift_byte <= {shift_byte[6:0], 1'b0};
256 609 : if (shift_cnt == 0) begin
257 87 : shift_cnt <= 3'd7;
258 87 : current_state <= S_TXREL; // 8 bit bitti -> ACK fazına geç
259 : end
260 609 : else shift_cnt <= shift_cnt - 1;
261 : end
262 : end
263 :
264 : // ---------- ACK için SDA'yı bırak (ara durum) ----------
265 : // Son veri bitinin sunulduğu SCL-high'ı atlatır, sonra low'da bırakır.
266 174 : S_TXREL: begin
267 87 : if (!I2C_SCL) begin
268 87 : sda_out_val <= 1'b1; // (2) ACK öncesi SDA serbest
269 87 : current_state <= S_TXACK;
270 : end
271 : end
272 :
273 : // ---------- GÖNDERİLEN BAYTIN ACK'INI ÖRNEKLE ----------
274 87 : S_TXACK: begin
275 87 : if (I2C_SCL) begin
276 81 : if (!I2C_SDA_in) begin // ACK alındı
277 81 : case (phase)
278 : // -- adres+W ACK'landı --
279 33 : PH_ADDRW: begin
280 21 : if (is_read_op) begin
281 12 : current_state <= S_REPSTA1; // okuma: repeated-start'a git
282 : end
283 21 : else begin // yazma: ilk veri baytını yükle
284 21 : shift_byte <= I2C_TDR[7:0];
285 21 : shift_cnt <= 3'd7;
286 21 : data_cnt <= 0;
287 21 : phase <= PH_WDATA;
288 21 : current_state <= S_TXBYTE;
289 : end
290 : end
291 : // -- yazma veri baytı ACK'landı --
292 36 : PH_WDATA: begin
293 18 : if (data_cnt == I2C_NBY[2:0] - 1) begin
294 18 : current_state <= S_STOP1; // son bayt -> STOP
295 : end
296 18 : else begin
297 18 : data_cnt <= data_cnt + 1;
298 18 : shift_cnt <= 3'd7;
299 18 : case (data_cnt + 1) // bir sonraki TDR baytı
300 9 : 1: shift_byte <= I2C_TDR[15: 8];
301 6 : 2: shift_byte <= I2C_TDR[23:16];
302 3 : 3: shift_byte <= I2C_TDR[31:24];
303 0 : default: shift_byte <= I2C_TDR[7:0];
304 : endcase
305 18 : current_state <= S_TXBYTE;
306 : end
307 : end
308 : // -- adres+R ACK'landı -> alıma geç --
309 12 : PH_ADDRR: begin
310 12 : r_w <= 1'b1;
311 12 : shift_cnt <= 3'd7;
312 12 : rx_idx <= 0;
313 12 : current_state <= S_RXBYTE;
314 : end
315 0 : default: current_state <= S_ABORT;
316 : endcase
317 : end
318 6 : else begin // NACK -> iptal
319 6 : current_state <= S_ABORT;
320 : end
321 : end
322 : end
323 :
324 : // ---------- REPEATED-START (faz 1: SCL low'da SDA bırak) ----------
325 12 : S_REPSTA1: begin
326 12 : if (!I2C_SCL) begin
327 12 : sda_out_val <= 1'b1; // SDA high
328 12 : current_state <= S_REPSTA2;
329 : end
330 : end
331 :
332 : // ---------- REPEATED-START (faz 2: SCL high'da SDA düşür) ----------
333 12 : S_REPSTA2: begin
334 12 : if (I2C_SCL) begin
335 12 : sda_out_val <= 1'b0; // SCL high iken SDA düşer = (re)START
336 12 : shift_byte <= {I2C_ADR[6:0], 1'b1}; // adres + READ biti
337 12 : shift_cnt <= 3'd7;
338 12 : phase <= PH_ADDRR;
339 12 : current_state <= S_TXBYTE;
340 : end
341 : end
342 :
343 : // ---------- SLAVE'DEN BAYT AL ----------
344 480 : S_RXBYTE: begin
345 240 : if (!I2C_SCL) begin
346 240 : sda_out_val <= 1'b1;
347 : end
348 240 : else begin
349 240 : shift_byte <= {shift_byte[6:0], I2C_SDA_in};
350 210 : if (shift_cnt == 0) begin
351 30 : shift_cnt <= 3'd7;
352 : // tamamlanan baytı doğru konuma yaz (ilk bayt -> RDR[7:0])
353 30 : case (rx_idx)
354 12 : 0: I2C_RDR[ 7: 0] <= {shift_byte[6:0], I2C_SDA_in};
355 9 : 1: I2C_RDR[15: 8] <= {shift_byte[6:0], I2C_SDA_in};
356 6 : 2: I2C_RDR[23:16] <= {shift_byte[6:0], I2C_SDA_in};
357 3 : 3: I2C_RDR[31:24] <= {shift_byte[6:0], I2C_SDA_in};
358 : endcase
359 30 : current_state <= S_RXACK;
360 : end
361 210 : else shift_cnt <= shift_cnt - 1;
362 : end
363 : end
364 :
365 : // ---------- ALINAN BAYT İÇİN ACK/NACK SÜR ----------
366 60 : S_RXACK: begin
367 30 : if (!I2C_SCL) begin
368 : // son bayt -> NACK (SDA high/bırak), değilse ACK (SDA low)
369 18 : if (rx_idx == I2C_NBY[2:0] - 1) sda_out_val <= 1'b1;
370 18 : else sda_out_val <= 1'b0;
371 : end
372 30 : else begin // ACK/NACK biti sunuldu -> yönlendir
373 18 : if (rx_idx == I2C_NBY[2:0] - 1) begin
374 12 : current_state <= S_STOP1; // son bayt -> STOP
375 : end
376 18 : else begin
377 18 : rx_idx <= rx_idx + 1;
378 18 : shift_cnt <= 3'd7;
379 18 : current_state <= S_RXBYTE;
380 : end
381 : end
382 : end
383 :
384 : // ---------- STOP (faz 1: SCL low'da SDA low) ----------
385 30 : S_STOP1: begin
386 30 : if (!I2C_SCL) begin
387 30 : sda_out_val <= 1'b0;
388 30 : current_state <= S_STOP2;
389 : end
390 : end
391 :
392 : // ---------- STOP (faz 2: SCL high'da SDA high) + bitir ----------
393 30 : S_STOP2: begin
394 30 : if (I2C_SCL) begin
395 30 : sda_out_val <= 1'b1;
396 30 : freq_div_en <= 1'b0;
397 30 : awready <= 1'b1;
398 30 : wready <= 1'b1;
399 30 : current_state <= S_IDLE;
400 18 : if (is_read_op) begin
401 12 : I2C_CFG[2] <= 1'b0; // RD_START temizle
402 12 : I2C_CFG[3] <= 1'b1; // RD_DONE set
403 : end
404 18 : else begin
405 18 : I2C_CFG[0] <= 1'b0; // WR_START temizle
406 18 : I2C_CFG[1] <= 1'b1; // WR_DONE set
407 : end
408 : end
409 : end
410 :
411 : // ---------- NACK / İPTAL ----------
412 12 : S_ABORT: begin
413 6 : if (!I2C_SCL) begin
414 6 : sda_out_val <= 1'b0;
415 : end
416 6 : else begin
417 6 : sda_out_val <= 1'b1; // temiz STOP
418 6 : freq_div_en <= 1'b0;
419 6 : awready <= 1'b1;
420 6 : wready <= 1'b1;
421 6 : I2C_CFG[0] <= 1'b0;
422 6 : I2C_CFG[2] <= 1'b0;
423 6 : current_state <= S_IDLE;
424 : end
425 : end
426 :
427 0 : default: current_state <= S_IDLE;
428 : endcase
429 : end
430 : end
431 : end
432 : end
433 : endmodule



Generated by: LCOV version 2.0-1 (https://github.com//linux-test-project/lcov)
