YTU-YODA-KYBER/2026_teknofest-mikrodenetleyici-tasarimi/FPGA/verification/uvm/coverage/Peripherals/UART_GU/UART_GU_AXI4-Lite.sv.gcov.html

LCOV - code coverage report



Current view: | top level - Peripherals/UART_GU - UART_GU_AXI4-Lite.sv | | | Coverage | Total | Hit
Test: | YODA KYBER -- UVM satir kapsami | | Lines: | 98.2 % | 164 | 161
Test Date: | 2026-09-07 22:07:37 | | Functions: | - | 0 | 0
Legend: | Lines: hit not hit





Line data Source code

1 : module UART_GU_AXI4_Lite (
2 : // clock ve reset sinyalleri
3 71262 : input logic clk,
4 42 : input logic rst_n,
5 :
6 : // AW Portları
7 89 : input logic [31:0] awaddr,
8 644 : input logic awvalid,
9 689 : output logic awready,
10 :
11 : // WD Portları
12 119 : input logic [31:0] wdata,
13 644 : input logic wvalid,
14 689 : output logic wready,
15 :
16 : // B Portları
17 0 : output logic [ 1:0] bresp,
18 653 : output logic bvalid,
19 644 : input logic bready,
20 :
21 : // AR Portları
22 107 : input logic [31:0] araddr,
23 824 : input logic arvalid,
24 869 : output logic arready,
25 :
26 : // R Portları
27 824 : input logic rready,
28 95 : output logic [31:0] rdata,
29 0 : output logic [ 1:0] rresp,
30 833 : output logic rvalid,
31 :
32 84 : input logic rx,
33 180 : output logic tx
34 : );
35 :
36 : localparam [1:0] IDLE = 0;
37 : localparam [1:0] WAIT = 1;
38 : localparam [1:0] DATA = 2;
39 : localparam [1:0] STOP = 3;
40 : localparam [1:0] REPORT = 3;
41 :
42 54 : logic [ 2:0] UART_CFG;
43 40 : logic [ 7:0] UART_TDR;
44 9 : logic [ 7:0] UART_RDR;
45 42 : logic [31:0] UART_CPB;
46 25 : logic [ 1:0] UART_STP;
47 :
48 :
49 51 : logic [1:0] tx_state; // TX FSM'sinin durumu
50 36 : logic [1:0] rx_state; // RX FSM'sinin durumu
51 :
52 204 : logic [ 3:0] tx_shift_cnt; // Gönderilen bit sayısını saymak için kullanılır
53 60 : logic [ 3:0] rx_shift_cnt; // Alınan bit sayısını saymak için kullanılır
54 :
55 35517 : logic [15:0] tx_tick_cnt; // Baud rate'i belirlemek için kullanılan sayaç
56 3834 : logic [31:0] rx_tick_cnt; // Baud rate'i belirlemek için kullanılan sayaç
57 0 : logic [15:0] tx_tick_cnt_limit; // Baud rate'i belirlemek için kullanılan sayaç limiti
58 :
59 9 : logic [ 1:0] stop_bit; // Stop bit sayısını takip etmek için kullanılır
60 :
61 774 : logic tx_middle_alert; // TX işlemi sırasında orta noktaya gelindiğinde uyarı vermek için kullanılır
62 144 : logic rx_middle_alert; // RX işlemi sırasında orta noktaya gelindiğinde uyarı vermek için kullanılır
63 729 : logic tx_zero_alert; // TX işlemi sırasında bit sayısı sıfırlandığında uyarı vermek için kullanılır
64 84 : logic rx_meta, rx_sync;
65 :
66 : // ---------------------------------------------------------
67 : // TX BAUDRATE GENERATOR
68 : // ---------------------------------------------------------
69 71268 : always @(posedge clk or negedge rst_n) begin
70 71046 : if(!rst_n) begin
71 222 : tx_tick_cnt <= 0;
72 222 : tx_zero_alert <= 0;
73 222 : tx_middle_alert <= 0;
74 : end
75 71046 : else begin
76 70296 : if (tx_tick_cnt >= UART_CPB - 1) begin
77 750 : tx_tick_cnt <= 0;
78 750 : tx_zero_alert <= 1'b1; // bit sınırı: her TAM UART_CPB clock'ta bir (1 cycle pulse)
79 750 : tx_middle_alert <= 1'b0;
80 : end
81 70296 : else begin
82 70296 : tx_tick_cnt <= tx_tick_cnt + 1;
83 70296 : tx_zero_alert <= 1'b0;
84 70296 : tx_middle_alert <= (tx_tick_cnt == (UART_CPB >> 1)); // bit ortası (sadece STP>0 için lazım)
85 : end
86 : end
87 : end
88 :
89 : // ---------------------------------------------------------
90 : // RX BAUDRATE GENERATOR
91 : // ---------------------------------------------------------
92 71268 : always @(posedge clk or negedge rst_n) begin
93 71046 : if(!rst_n) begin
94 222 : rx_tick_cnt <= 0;
95 222 : rx_middle_alert <= 0;
96 : end
97 71046 : else begin
98 71046 : rx_middle_alert <= 0;
99 71046 : case (rx_state)
100 63153 : IDLE: rx_tick_cnt <= 0;
101 1368 : WAIT: begin
102 1350 : if (UART_CPB != 0 && rx_tick_cnt >= UART_CPB + (UART_CPB >> 1) - 1) begin
103 18 : rx_tick_cnt <= 0;
104 18 : rx_middle_alert <= 1;
105 1350 : end else begin
106 1350 : rx_tick_cnt <= rx_tick_cnt + 1;
107 : end
108 : end
109 6300 : DATA: begin
110 6174 : if (UART_CPB != 0 && rx_tick_cnt >= UART_CPB - 1) begin
111 126 : rx_tick_cnt <= 0;
112 126 : rx_middle_alert <= 1;
113 6174 : end else begin
114 6174 : rx_tick_cnt <= rx_tick_cnt + 1;
115 : end
116 : end
117 225 : default: rx_tick_cnt <= 0;
118 : endcase
119 : end
120 : end
121 :
122 71268 : always @(posedge clk or negedge rst_n) begin
123 71046 : if(!rst_n) begin
124 222 : rx_meta <= 1'b1; // idle-high ile başla
125 222 : rx_sync <= 1'b1;
126 71046 : end else begin
127 71046 : rx_meta <= rx; // 1. kademe (metastable olabilir)
128 71046 : rx_sync <= rx_meta; // 2. kademe (kararlı)
129 : end
130 : end
131 :
132 : // ---------------------------------------------------------
133 : // AXI YAZMA/OKUMA IŞLEMLERİ
134 : // ---------------------------------------------------------
135 71268 : always @(posedge clk or negedge rst_n) begin
136 71046 : if(!rst_n) begin
137 222 : UART_CFG <= 0;
138 222 : UART_TDR <= 0;
139 222 : UART_RDR <= 0;
140 222 : UART_CPB <= 0;
141 222 : UART_STP <= 0;
142 :
143 222 : stop_bit <= 0;
144 :
145 222 : tx_shift_cnt <= 0;
146 222 : rx_shift_cnt <= 0;
147 :
148 222 : tx_state <= IDLE;
149 222 : rx_state <= IDLE;
150 :
151 222 : bresp <= 0;
152 222 : bvalid <= 0;
153 222 : rresp <= 0;
154 222 : rvalid <= 0;
155 222 : rdata <= 0;
156 :
157 222 : awready <= 1;
158 222 : wready <= 1;
159 222 : arready <= 1;
160 :
161 222 : tx <= 1;
162 :
163 71046 : end else begin
164 :
165 : // --- AXI YAZMA İŞLEMİ ---
166 653 : if (awvalid && wvalid && awready && wready) begin
167 653 : bvalid <= 1'b1;
168 653 : awready <= 1'b0;
169 653 : wready <= 1'b0;
170 :
171 653 : case (awaddr[7:0])
172 177 : 8'h00: UART_CPB <= wdata;
173 152 : 8'h04: UART_STP <= wdata[1:0];
174 198 : 8'h0C: UART_TDR <= wdata;
175 120 : 8'h10: UART_CFG <= wdata;
176 : endcase
177 : end
178 69740 : else if (bvalid && bready) begin
179 653 : bvalid <= 1'b0;
180 653 : awready <= 1'b1;
181 653 : wready <= 1'b1;
182 : end
183 :
184 :
185 : // --- AXI OKUMA İŞLEMİ ---
186 833 : if (arvalid && arready) begin
187 833 : rvalid <= 1'b1;
188 833 : arready <= 1'b0;
189 :
190 833 : case (araddr[7:0])
191 190 : 8'h00: rdata <= UART_CPB;
192 168 : 8'h04: rdata <= {29'h0, UART_STP};
193 108 : 8'h08: rdata <= UART_RDR;
194 178 : 8'h0C: rdata <= UART_TDR;
195 186 : 8'h10: rdata <= UART_CFG;
196 :
197 : endcase
198 : end
199 69380 : else if (rvalid && rready) begin
200 833 : rvalid <= 1'b0;
201 833 : arready <= 1'b1;
202 : end
203 :
204 :
205 :
206 : // ---------------------------------------------------------
207 : // TX BLOĞU
208 : // ---------------------------------------------------------
209 70692 : if(!stop_bit) begin
210 69945 : if(tx_zero_alert)begin
211 747 : case (tx_state)
212 288 : IDLE: begin
213 237 : if (UART_CFG[0]) begin
214 51 : tx <= 0;
215 51 : tx_state <= DATA;
216 51 : tx_shift_cnt <= 0;
217 : end
218 : end
219 408 : DATA: begin
220 357 : if (tx_shift_cnt == 7) tx_state <= STOP;
221 :
222 408 : tx <= UART_TDR[tx_shift_cnt];
223 408 : tx_shift_cnt <= tx_shift_cnt + 1;
224 : end
225 51 : STOP: begin
226 51 : tx <= 1;
227 51 : UART_CFG[2] <= 1;
228 51 : UART_CFG[0] <= 0;
229 51 : tx_state <= IDLE;
230 48 : if(UART_STP == 3) stop_bit <= 2;
231 48 : else stop_bit <= UART_STP;
232 : end
233 : endcase
234 : end
235 : end
236 354 : else begin
237 342 : if(tx_middle_alert || tx_zero_alert) stop_bit <= stop_bit - 1;
238 : end
239 :
240 :
241 : // ---------------------------------------------------------
242 : // RX BLOĞU
243 : // ---------------------------------------------------------
244 71046 : case (rx_state)
245 63153 : IDLE : begin
246 63135 : if(rx_sync == 0) rx_state <= WAIT;
247 : end
248 :
249 1368 : WAIT : begin
250 1350 : if(rx_middle_alert) begin
251 18 : UART_RDR[0] <= rx_sync;
252 18 : rx_state <= DATA;
253 18 : rx_shift_cnt <= 1;
254 : end
255 : end
256 :
257 6300 : DATA: begin
258 6174 : if(rx_middle_alert) begin
259 126 : UART_RDR[rx_shift_cnt] <= rx_sync;
260 108 : if(rx_shift_cnt == 7) rx_state <= REPORT;
261 108 : else rx_shift_cnt <= rx_shift_cnt + 1;
262 : end
263 : end
264 :
265 225 : REPORT: begin
266 207 : if(rx_sync)begin
267 18 : rx_state <= IDLE;
268 18 : UART_CFG[1] <= 1;
269 : end
270 : end
271 : endcase
272 :
273 : end
274 : end
275 : endmodule



Generated by: LCOV version 2.0-1 (https://github.com//linux-test-project/lcov)
