YTU-YODA-KYBER/2026_teknofest-mikrodenetleyici-tasarimi/FPGA/verification/uvm/coverage/Peripherals/UART_YZ/UART_YZ_AXI4-Lite.sv.gcov.html

LCOV - code coverage report



Current view: | top level - Peripherals/UART_YZ - UART_YZ_AXI4-Lite.sv | | | Coverage | Total | Hit
Test: | YODA KYBER -- UVM satir kapsami | | Lines: | 98.3 % | 173 | 170
Test Date: | 2026-09-07 22:07:37 | | Functions: | - | 0 | 0
Legend: | Lines: hit not hit





Line data Source code

1 : module UART_YZ_AXI4_Lite (
2 : // clock ve reset sinyalleri
3 80910 : input logic clk,
4 45 : input logic rst_n,
5 :
6 : // AW Portları
7 89 : input logic [31:0] awaddr,
8 659 : input logic awvalid,
9 707 : output logic awready,
10 :
11 : // WD Portları
12 119 : input logic [31:0] wdata,
13 659 : input logic wvalid,
14 707 : output logic wready,
15 :
16 : // B Portları
17 0 : output logic [ 1:0] bresp,
18 668 : output logic bvalid,
19 659 : input logic bready,
20 :
21 : // AR Portları
22 113 : input logic [31:0] araddr,
23 842 : input logic arvalid,
24 890 : output logic arready,
25 :
26 : // R Portları
27 842 : input logic rready,
28 104 : output logic [31:0] rdata,
29 0 : output logic [ 1:0] rresp,
30 851 : output logic rvalid,
31 :
32 138 : input logic rx,
33 183 : output logic tx,
34 :
35 3 : input logic dma_enable_i,
36 6 : output logic [ 7:0] dma_data_o,
37 12 : output logic dma_valid_o
38 : );
39 :
40 : localparam [1:0] IDLE = 0;
41 : localparam [1:0] WAIT = 1;
42 : localparam [1:0] DATA = 2;
43 : localparam [1:0] STOP = 3;
44 : localparam [1:0] REPORT = 3;
45 :
46 54 : logic [ 2:0] UART_CFG;
47 40 : logic [ 7:0] UART_TDR;
48 15 : logic [ 7:0] UART_RDR;
49 45 : logic [31:0] UART_CPB;
50 25 : logic [ 1:0] UART_STP;
51 :
52 :
53 51 : logic [1:0] tx_state; // TX FSM'sinin durumu
54 66 : logic [1:0] rx_state; // RX FSM'sinin durumu
55 :
56 204 : logic [ 3:0] tx_shift_cnt; // Gönderilen bit sayısını saymak için kullanılır
57 108 : logic [ 3:0] rx_shift_cnt; // Alınan bit sayısını saymak için kullanılır
58 :
59 40335 : logic [15:0] tx_tick_cnt; // Baud rate'i belirlemek için kullanılan sayaç
60 7029 : logic [31:0] rx_tick_cnt; // Baud rate'i belirlemek için kullanılan sayaç
61 0 : logic [15:0] tx_tick_cnt_limit; // Baud rate'i belirlemek için kullanılan sayaç limiti
62 :
63 9 : logic [ 1:0] stop_bit; // Stop bit sayısını takip etmek için kullanılır
64 :
65 969 : logic tx_middle_alert; // TX işlemi sırasında orta noktaya gelindiğinde uyarı vermek için kullanılır
66 264 : logic rx_middle_alert; // RX işlemi sırasında orta noktaya gelindiğinde uyarı vermek için kullanılır
67 921 : logic tx_zero_alert; // TX işlemi sırasında bit sayısı sıfırlandığında uyarı vermek için kullanılır
68 138 : logic rx_meta, rx_sync;
69 :
70 : // ---------------------------------------------------------
71 : // TX BAUDRATE GENERATOR
72 : // ---------------------------------------------------------
73 80916 : always @(posedge clk or negedge rst_n) begin
74 80679 : if(!rst_n) begin
75 237 : tx_tick_cnt <= 0;
76 237 : tx_zero_alert <= 0;
77 237 : tx_middle_alert <= 0;
78 : end
79 80679 : else begin
80 79737 : if (tx_tick_cnt >= UART_CPB - 1) begin
81 942 : tx_tick_cnt <= 0;
82 942 : tx_zero_alert <= 1'b1; // bit sınırı: her TAM UART_CPB clock'ta bir (1 cycle pulse)
83 942 : tx_middle_alert <= 1'b0;
84 : end
85 79737 : else begin
86 79737 : tx_tick_cnt <= tx_tick_cnt + 1;
87 79737 : tx_zero_alert <= 1'b0;
88 79737 : tx_middle_alert <= (tx_tick_cnt == (UART_CPB >> 1)); // bit ortası (sadece STP>0 için lazım)
89 : end
90 : end
91 : end
92 :
93 : // ---------------------------------------------------------
94 : // RX BAUDRATE GENERATOR
95 : // ---------------------------------------------------------
96 80916 : always @(posedge clk or negedge rst_n) begin
97 80679 : if(!rst_n) begin
98 237 : rx_tick_cnt <= 0;
99 237 : rx_middle_alert <= 0;
100 : end
101 80679 : else begin
102 80679 : rx_middle_alert <= 0;
103 80679 : case (rx_state)
104 66174 : IDLE: rx_tick_cnt <= 0;
105 2508 : WAIT: begin
106 2475 : if (UART_CPB != 0 && rx_tick_cnt >= UART_CPB + (UART_CPB >> 1) - 1) begin
107 33 : rx_tick_cnt <= 0;
108 33 : rx_middle_alert <= 1;
109 2475 : end else begin
110 2475 : rx_tick_cnt <= rx_tick_cnt + 1;
111 : end
112 : end
113 11550 : DATA: begin
114 11319 : if (UART_CPB != 0 && rx_tick_cnt >= UART_CPB - 1) begin
115 231 : rx_tick_cnt <= 0;
116 231 : rx_middle_alert <= 1;
117 11319 : end else begin
118 11319 : rx_tick_cnt <= rx_tick_cnt + 1;
119 : end
120 : end
121 447 : default: rx_tick_cnt <= 0;
122 : endcase
123 : end
124 : end
125 :
126 :
127 80916 : always @(posedge clk or negedge rst_n) begin
128 80679 : if(!rst_n) begin
129 237 : rx_meta <= 1'b1; // idle-high ile başla
130 237 : rx_sync <= 1'b1;
131 80679 : end else begin
132 80679 : rx_meta <= rx; // 1. kademe (metastable olabilir)
133 80679 : rx_sync <= rx_meta; // 2. kademe (kararlı)
134 : end
135 : end
136 :
137 : // ---------------------------------------------------------
138 : // AXI YAZMA/OKUMA IŞLEMLERİ
139 : // ---------------------------------------------------------
140 80916 : always @(posedge clk or negedge rst_n) begin
141 80679 : if(!rst_n) begin
142 237 : UART_CFG <= 0;
143 237 : UART_TDR <= 0;
144 237 : UART_RDR <= 0;
145 237 : UART_CPB <= 0;
146 237 : UART_STP <= 0;
147 :
148 237 : stop_bit <= 0;
149 :
150 237 : tx_shift_cnt <= 0;
151 237 : rx_shift_cnt <= 0;
152 :
153 237 : tx_state <= IDLE;
154 237 : rx_state <= IDLE;
155 :
156 237 : bresp <= 0;
157 237 : bvalid <= 0;
158 237 : rresp <= 0;
159 237 : rvalid <= 0;
160 237 : rdata <= 0;
161 :
162 237 : awready <= 1;
163 237 : wready <= 1;
164 237 : arready <= 1;
165 :
166 237 : tx <= 1;
167 237 : dma_data_o <= 0;
168 237 : dma_valid_o <= 0;
169 :
170 80679 : end else begin
171 :
172 : // --- AXI YAZMA İŞLEMİ ---
173 668 : if (awvalid && wvalid && awready && wready) begin
174 668 : bvalid <= 1'b1;
175 668 : awready <= 1'b0;
176 668 : wready <= 1'b0;
177 :
178 668 : case (awaddr[7:0])
179 180 : 8'h00: UART_CPB <= wdata;
180 152 : 8'h04: UART_STP <= wdata[1:0];
181 198 : 8'h0C: UART_TDR <= wdata;
182 132 : 8'h10: UART_CFG <= wdata;
183 : endcase
184 : end
185 79343 : else if (bvalid && bready) begin
186 668 : bvalid <= 1'b0;
187 668 : awready <= 1'b1;
188 668 : wready <= 1'b1;
189 : end
190 :
191 :
192 : // --- AXI OKUMA İŞLEMİ ---
193 851 : if (arvalid && arready) begin
194 851 : rvalid <= 1'b1;
195 851 : arready <= 1'b0;
196 :
197 851 : case (araddr[7:0])
198 190 : 8'h00: rdata <= UART_CPB;
199 168 : 8'h04: rdata <= {29'h0, UART_STP};
200 123 : 8'h08: rdata <= UART_RDR;
201 178 : 8'h0C: rdata <= UART_TDR;
202 189 : 8'h10: rdata <= UART_CFG;
203 :
204 : endcase
205 : end
206 78977 : else if (rvalid && rready) begin
207 851 : rvalid <= 1'b0;
208 851 : arready <= 1'b1;
209 : end
210 :
211 :
212 :
213 : // ---------------------------------------------------------
214 : // TX BLOĞU
215 : // ---------------------------------------------------------
216 80325 : if(!stop_bit) begin
217 79386 : if(tx_zero_alert)begin
218 939 : case (tx_state)
219 480 : IDLE: begin
220 429 : if (UART_CFG[0]) begin
221 51 : tx <= 0;
222 51 : tx_state <= DATA;
223 51 : tx_shift_cnt <= 0;
224 : end
225 : end
226 408 : DATA: begin
227 357 : if (tx_shift_cnt == 7) tx_state <= STOP;
228 :
229 408 : tx <= UART_TDR[tx_shift_cnt];
230 408 : tx_shift_cnt <= tx_shift_cnt + 1;
231 : end
232 51 : STOP: begin
233 51 : tx <= 1;
234 51 : UART_CFG[2] <= 1;
235 51 : UART_CFG[0] <= 0;
236 51 : tx_state <= IDLE;
237 48 : if(UART_STP == 3) stop_bit <= 2;
238 48 : else stop_bit <= UART_STP;
239 : end
240 : endcase
241 : end
242 : end
243 354 : else begin
244 342 : if(tx_middle_alert || tx_zero_alert) stop_bit <= stop_bit - 1;
245 : end
246 :
247 :
248 : // ---------------------------------------------------------
249 : // RX BLOĞU
250 : // ---------------------------------------------------------
251 80679 : case (rx_state)
252 66174 : IDLE : begin
253 66141 : if(rx_sync == 0) rx_state <= WAIT;
254 66174 : dma_valid_o <= 0;
255 : end
256 :
257 2508 : WAIT : begin
258 2475 : if(rx_middle_alert) begin
259 33 : UART_RDR[0] <= rx_sync;
260 33 : rx_state <= DATA;
261 33 : rx_shift_cnt <= 1;
262 : end
263 : end
264 :
265 11550 : DATA: begin
266 11319 : if(rx_middle_alert) begin
267 231 : UART_RDR[rx_shift_cnt] <= rx_sync;
268 198 : if(rx_shift_cnt == 7) rx_state <= REPORT;
269 198 : else rx_shift_cnt <= rx_shift_cnt + 1;
270 : end
271 : end
272 :
273 447 : REPORT: begin
274 414 : if(rx_sync)begin
275 33 : rx_state <= IDLE;
276 33 : UART_CFG[1] <= 1;
277 21 : if(dma_enable_i) begin
278 12 : dma_data_o <= UART_RDR;
279 12 : dma_valid_o <= 1;
280 : end
281 : end
282 : end
283 : endcase
284 :
285 : end
286 : end
287 : endmodule



Generated by: LCOV version 2.0-1 (https://github.com//linux-test-project/lcov)
