YTU-YODA-KYBER/2026_teknofest-mikrodenetleyici-tasarimi/FPGA/verification/uvm/regression_results.csv

blok | test | tohum | sonuc | gecti | beklenen_basarisiz | ihlal | uyari | hata | yazma | okuma | kontrol | uyusmazlik | sure
gpio | gpio_bitwalk_test | 1 | GECTI | True | False | 0 | 0 | 0 | 34 | 33 | 33 | 0 | 0.6
gpio | gpio_bitwalk_test | 2 | GECTI | True | False | 0 | 0 | 0 | 34 | 33 | 33 | 0 | 0.6
gpio | gpio_bitwalk_test | 3 | GECTI | True | False | 0 | 0 | 0 | 34 | 33 | 33 | 0 | 0.6
gpio | gpio_display_test | 1 | GECTI | True | False | 0 | 0 | 0 | 13 | 0 | 0 | 0 | 2.9
gpio | gpio_display_test | 2 | GECTI | True | False | 0 | 0 | 0 | 13 | 0 | 0 | 0 | 2.9
gpio | gpio_display_test | 3 | GECTI | True | False | 0 | 0 | 0 | 13 | 0 | 0 | 0 | 2.9
gpio | gpio_pad_test | 1 | GECTI | True | False | 0 | 0 | 0 | 3 | 5 | 5 | 0 | 0.6
gpio | gpio_pad_test | 2 | GECTI | True | False | 0 | 0 | 0 | 3 | 5 | 5 | 0 | 0.6
gpio | gpio_pad_test | 3 | GECTI | True | False | 0 | 0 | 0 | 3 | 5 | 5 | 0 | 0.6
gpio | gpio_random_test | 1 | GECTI | True | False | 0 | 0 | 0 | 37 | 101 | 101 | 0 | 3.0
gpio | gpio_random_test | 2 | GECTI | True | False | 0 | 0 | 0 | 18 | 78 | 78 | 0 | 2.3
gpio | gpio_random_test | 3 | GECTI | True | False | 0 | 0 | 0 | 32 | 90 | 90 | 0 | 2.8
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
