YTU-YODA-KYBER/2026_teknofest-mikrodenetleyici-tasarimi/FPGA/verification/uvm/coverage/AI_Accelerator/yz_csr_wrapper.sv.gcov.html

LCOV - code coverage report



Current view: | top level - AI_Accelerator - yz_csr_wrapper.sv | | | Coverage | Total | Hit
Test: | YODA KYBER -- UVM satir kapsami | | Lines: | 100.0 % | 53 | 53
Test Date: | 2026-09-07 22:07:37 | | Functions: | - | 0 | 0
Legend: | Lines: hit not hit





Line data Source code

1 : module yz_csr_wrapper (
2 4113 : input logic clk, rst_n,
3 :
4 : // --- AXI4-Lite slave (senin interconnect portuna) ---
5 194 : input logic [31:0] YZ_awaddr, input logic YZ_awvalid, output logic YZ_awready,
6 194 : input logic [31:0] YZ_wdata, input logic YZ_wvalid, output logic YZ_wready,
7 173 : output logic [1:0] YZ_bresp, output logic YZ_bvalid, input logic YZ_bready,
8 485 : input logic [31:0] YZ_araddr, input logic YZ_arvalid, output logic YZ_arready,
9 464 : output logic [31:0] YZ_rdata, output logic [1:0] YZ_rresp, output logic YZ_rvalid, input logic YZ_rready,
10 :
11 : // --- hızlandırıcıya/bellek kontrolcüsüne giden basit sinyaller ---
12 58 : output logic acc_start, // Hızlandırıcının çıkarımı başlat pulse sinyali
13 3 : input logic acc_busy, // Çıkarım işleminin devam ettiğini gösterir
14 6 : input logic acc_done, // Çıkarım bittiğinde pulse olur
15 27 : input logic acc_out_wen, // "Çıkarım sonucu geçerli" mesajı için pulse olur. Bu 1 olduğu zaman satır 40 yapılır
16 9 : input logic [7:0] acc_out_wdata, // Güncel çıkarım sonucunu tutar
17 9 : input logic [127:0] acc_fc_scores, // FC katmanının 4 ham 32-bit akümülatörü
18 3 : input logic load_done_irq, // YZ bellleğine yazma işleminin bittiğini CPU'ya bildirmek için kullanılan interrupt sinyali
19 54 : output logic load_clear, // "cpu_clear_i"ye bağlı, işlemci "load_done_irq" sinyalini gördükten sonra bu sinyal aracılığı ile irq sinyalini temizler
20 6 : output logic infer_irq // -> irq_i[17]
21 : );
22 9 : logic [1:0] result_reg; // "acc_out_wen" olduğu zaman "acc_out_wdata"daki çıkarım sonucunuu tutar.
23 9 : logic [127:0] score_reg; // Aynı anda yakalanan 4 ham FC skoru (0x10..0x1C'den okunur)
24 6 : logic infer_pending; // infer_irq sinyalinin 1 olması için ve CPU tarafından gördükten sonra 0'a çekilmesi olayı için kullanılır
25 :
26 : assign YZ_bresp = 2'b00;
27 : assign YZ_rresp = 2'b00;
28 : assign infer_irq = infer_pending;
29 :
30 4119 : always_ff @(posedge clk or negedge rst_n) begin
31 3972 : if (!rst_n) begin
32 147 : YZ_awready <= 1; YZ_wready <= 1; YZ_bvalid <= 0;
33 147 : YZ_arready <= 1; YZ_rvalid <= 0; YZ_rdata <= 0;
34 147 : acc_start <= 0; load_clear <= 0;
35 147 : result_reg <= 0; score_reg <= 0; infer_pending <= 0;
36 3972 : end else begin
37 : // (1) start ve clear'lar HER cycle 0'a düşer -> otomatik 1-cycle pulse
38 3972 : acc_start <= 0;
39 3972 : load_clear <= 0;
40 :
41 : // (2) sonucu yakala: hızlandırıcı yazdığı an. Sınıf ile ham skorlar
42 : // aynı cycle'da alınır, böylece ikisi hep aynı çıkarıma aittir.
43 3945 : if (acc_out_wen) begin
44 27 : result_reg <= acc_out_wdata[1:0];
45 27 : score_reg <= acc_fc_scores;
46 : end
47 :
48 : // (3) done pulse'unu latch'le -> seviye interrupt
49 3966 : if (acc_done) infer_pending <= 1;
50 :
51 : // --- AXI YAZMA (senin şablonun) ---
52 173 : if (YZ_awvalid && YZ_wvalid && YZ_awready && YZ_wready) begin
53 173 : YZ_bvalid <= 1;
54 173 : YZ_awready <= 0; YZ_wready <= 0;
55 173 : case (YZ_awaddr[7:0])
56 116 : 8'h00: begin
57 : // CTRL: her bit bir OLAY -> pulse üret, saklama
58 58 : if (YZ_wdata[0]) acc_start <= 1;
59 62 : if (YZ_wdata[1]) load_clear <= 1;
60 58 : if (YZ_wdata[2]) infer_pending <= 0; // INFER_CLEAR
61 : end
62 : // 0x04 STATUS, 0x08 RESULT read-only -> yazma yok
63 : endcase
64 3626 : end else if (YZ_bvalid && YZ_bready) begin
65 173 : YZ_bvalid <= 0; YZ_awready <= 1; YZ_wready <= 1;
66 : end
67 :
68 : // --- AXI OKUMA (senin şablonun) ---
69 465 : if (YZ_arvalid && YZ_arready) begin
70 465 : YZ_rvalid <= 1; YZ_arready <= 0;
71 465 : case (YZ_araddr[7:0])
72 86 : 8'h04: YZ_rdata <= {29'h0, infer_pending, load_done_irq, acc_busy};
73 81 : 8'h08: YZ_rdata <= {30'h0, result_reg};
74 : // SCORE0..SCORE3: sınıf sırasına göre ham FC akümülatörleri
75 60 : 8'h10: YZ_rdata <= score_reg[ 31: 0];
76 60 : 8'h14: YZ_rdata <= score_reg[ 63: 32];
77 61 : 8'h18: YZ_rdata <= score_reg[ 95: 64];
78 57 : 8'h1C: YZ_rdata <= score_reg[127: 96];
79 60 : default: YZ_rdata <= 32'h0;
80 : endcase
81 3043 : end else if (YZ_rvalid && YZ_rready) begin
82 464 : YZ_rvalid <= 0; YZ_arready <= 1;
83 : end
84 : end
85 : end
86 : endmodule



Generated by: LCOV version 2.0-1 (https://github.com//linux-test-project/lcov)
