YTU-YODA-KYBER/2026_teknofest-mikrodenetleyici-tasarimi/FPGA/verification/uvm/coverage/Peripherals/GPIO/GPIO_AXI4_Lite.sv.gcov.html

LCOV - code coverage report



Current view: | top level - Peripherals/GPIO - GPIO_AXI4_Lite.sv | | | Coverage | Total | Hit
Test: | YODA KYBER -- UVM satir kapsami | | Lines: | 93.2 % | 207 | 193
Test Date: | 2026-09-07 22:07:37 | | Functions: | - | 0 | 0
Legend: | Lines: hit not hit





Line data Source code

1 : module GPIO_AXI4_Lite(
2 :
3 : // clock ve reset sinyalleri
4 654195 : input logic clk_i,
5 33 : input logic rst_n,
6 :
7 : // GPIO I/O portları
8 12 : input logic [31:0] GPIO_IDR,
9 63 : output logic [31:0] GPIO_ODR,
10 :
11 : // AW Portları
12 27 : input logic [31:0] awaddr,
13 274 : input logic awvalid,
14 307 : output logic awready,
15 :
16 : // WD Portları
17 75 : input logic [31:0] wdata,
18 274 : input logic wvalid,
19 307 : output logic wready,
20 :
21 : // B Portları
22 0 : output logic [ 1:0] bresp,
23 280 : output logic bvalid,
24 274 : input logic bready,
25 :
26 : // AR Portları
27 102 : input logic [31:0] araddr,
28 457 : input logic arvalid,
29 490 : output logic arready,
30 :
31 : // R Portları
32 457 : input logic rready,
33 68 : output logic [31:0] rdata,
34 0 : output logic [ 1:0] rresp,
35 463 : output logic rvalid,
36 :
37 105 : output logic [ 7:0] catode,
38 76 : output logic [ 7:0] anode
39 : );
40 :
41 192 : logic [ 2:0] anode_select;
42 327005 : logic [31:0] clk_div;
43 33 : logic [ 3:0] anim_select;
44 192 : logic mode_select;
45 :
46 :
47 654201 : always @(posedge clk_i or negedge rst_n) begin
48 :
49 : // ---------------------------------------------------------
50 : // RESET İŞLEMLERİ
51 : // ---------------------------------------------------------
52 654024 : if(!rst_n)begin
53 177 : GPIO_ODR <= 0;
54 :
55 177 : bresp <= 0;
56 177 : bvalid <= 0;
57 177 : rdata <= 0;
58 177 : rresp <= 0;
59 177 : rvalid <= 0;
60 177 : awready <= 1;
61 177 : wready <= 1;
62 177 : arready <= 1;
63 : end
64 654024 : else begin
65 :
66 : // ---------------------------------------------------------
67 : // AXI YAZMA İŞLEMİ
68 : // ---------------------------------------------------------
69 :
70 280 : if (awvalid && wvalid && awready && wready) begin
71 280 : awready <= 0;
72 280 : wready <= 0;
73 280 : bvalid <= 1;
74 :
75 259 : if (awaddr[3:0] == 4'h4)begin
76 259 : GPIO_ODR <= {16'h0000,wdata[15:0]};
77 : end
78 : end
79 653464 : else if (bvalid && bready) begin
80 280 : awready <= 1;
81 280 : wready <= 1;
82 280 : bvalid <= 0;
83 : end
84 :
85 :
86 : // ---------------------------------------------------------
87 : // AXI OKUMA İŞLEMİ
88 : // ---------------------------------------------------------
89 463 : if (arvalid && arready) begin
90 463 : arready <= 0;
91 463 : rvalid <= 1;
92 :
93 463 : case (araddr[3:0])
94 174 : 4'h0: rdata[31:0] <= GPIO_IDR;
95 286 : 4'h4: rdata[31:0] <= GPIO_ODR;
96 : endcase
97 : end
98 653098 : else if (rvalid && rready) begin
99 463 : arready <= 1;
100 463 : rvalid <= 0;
101 : end
102 :
103 : end
104 : end
105 :
106 :
107 27 : always@(*) begin
108 27 : anode = 8'b1111_1111;
109 27 : anode[anode_select] = 1'b0;
110 : end
111 :
112 654201 : always @(posedge clk_i or negedge rst_n) begin
113 :
114 654024 : if(!rst_n) begin
115 177 : clk_div <= 0;
116 177 : catode <= 8'b1111_1111;
117 177 : anode_select <= 0;
118 177 : anim_select <= 0;
119 177 : mode_select <= 0;
120 : end
121 654024 : else begin
122 :
123 653672 : if(clk_div[10:0] == 0) begin
124 352 : mode_select <= ~mode_select;
125 :
126 313 : if(anode_select == 7) anode_select <= 0;
127 313 : else anode_select <= anode_select +1;
128 : end
129 :
130 653991 : if (clk_div == 0) begin
131 33 : clk_div <= 32'd5_000_000;
132 33 : if(anim_select == 7) anim_select <= 0;
133 33 : else anim_select <= anim_select +1;
134 : end
135 653991 : else clk_div <= clk_div -1;
136 :
137 599628 : if((GPIO_IDR == 1 && GPIO_ODR[2:0]) || GPIO_IDR == 2)begin
138 599628 : case(anode_select)
139 73728 : 0: begin
140 73728 : case(anim_select)
141 0 : 0: catode <= 8'b0111_0001;
142 73728 : 1: catode <= 8'b0111_0011;
143 0 : 2: catode <= 8'b0111_0111;
144 0 : 5: catode <= 8'b1111_1110;
145 0 : 6: catode <= 8'b1111_1100;
146 0 : 7: catode <= 8'b1111_1000;
147 0 : default: catode <= 8'b1111_1111;
148 : endcase
149 : end
150 :
151 76509 : 1: begin
152 76509 : case(anim_select)
153 76509 : 1: catode <= 8'b0111_0111;
154 0 : 2: catode <= 8'b0110_0111;
155 0 : 3: catode <= 8'b0100_0111;
156 0 : 4: catode <= 8'b1100_1110;
157 0 : 5: catode <= 8'b1101_1110;
158 0 : 6: catode <= 8'b1111_1110;
159 0 : default: catode <= 8'b1111_1111;
160 : endcase
161 : end
162 : endcase
163 :
164 599628 : case(GPIO_IDR[1:0])
165 249990 : 1: begin
166 249990 : case(GPIO_ODR)
167 50178 : 1: begin
168 50178 : case(anode_select) //ERASE
169 6144 : 2: catode <= 8'b1111_1111;
170 6144 : 3: catode <= 8'b1000_0110;
171 6144 : 4: catode <= 8'b1001_0010;
172 6144 : 5: catode <= 8'b1000_1000;
173 6144 : 6: catode <= 8'b1100_1110;
174 6144 : 7: catode <= 8'b1000_0110;
175 : endcase
176 : end
177 :
178 49944 : 2: begin
179 49944 : case(anode_select) //SNDING
180 6144 : 2: catode <= 8'b1001_0000;
181 6144 : 3: catode <= 8'b1100_1000;
182 6144 : 4: catode <= 8'b1111_1001;
183 6144 : 5: catode <= 8'b1010_0001;
184 6144 : 6: catode <= 8'b1100_1000;
185 6144 : 7: catode <= 8'b1001_0010;
186 : endcase
187 : end
188 :
189 49944 : 3: begin
190 49944 : case(anode_select) //FINISH
191 6144 : 2: catode <= 8'b1000_1001;
192 6144 : 3: catode <= 8'b1001_0010;
193 6144 : 4: catode <= 8'b1111_1001;
194 6144 : 5: catode <= 8'b1100_1000;
195 6144 : 6: catode <= 8'b1111_1001;
196 6144 : 7: catode <= 8'b1000_1110;
197 : endcase
198 : end
199 :
200 49944 : 4: begin
201 49944 : case(anode_select) //ERROR
202 6825 : 2: catode <= 8'b1111_1111;
203 6144 : 3: catode <= 8'b1100_1110;
204 6144 : 4: catode <= 8'b1100_0000;
205 6144 : 5: catode <= 8'b1100_1110;
206 6144 : 6: catode <= 8'b1100_1110;
207 6144 : 7: catode <= 8'b1000_0110;
208 : endcase
209 : end
210 49980 : default: begin
211 49980 : case(anode_select) //BOOT
212 6942 : 2: catode <= 8'b1111_1111;
213 6144 : 3: catode <= 8'b1111_1111;
214 6144 : 4: catode <= 8'b1000_0111;
215 6144 : 5: catode <= 8'b1100_0000;
216 6144 : 6: catode <= 8'b1100_0000;
217 6144 : 7: catode <= 8'b1000_0011;
218 : endcase
219 : end
220 : endcase
221 : end
222 349638 : 2: begin
223 :
224 349638 : case(GPIO_ODR)
225 49938 : 5: begin
226 49938 : case(anode_select) //SNDING
227 6930 : 2: catode <= 8'b1001_0000;
228 6144 : 3: catode <= 8'b1100_1000;
229 6144 : 4: catode <= 8'b1111_1001;
230 6144 : 5: catode <= 8'b1010_0001;
231 6144 : 6: catode <= 8'b1100_1000;
232 6144 : 7: catode <= 8'b1001_0010;
233 : endcase
234 : end
235 :
236 49944 : 6: begin
237 49944 : case(anode_select) //INFRNC
238 6936 : 2: catode <= 8'b1100_0110;
239 6144 : 3: catode <= 8'b1100_1000;
240 6144 : 4: catode <= 8'b1100_1110;
241 6144 : 5: catode <= 8'b1000_1110;
242 6144 : 6: catode <= 8'b1100_1000;
243 6144 : 7: catode <= 8'b1111_1001;
244 : endcase
245 : end
246 :
247 49944 : 7: begin
248 49944 : case(anode_select) //EVET
249 6144 : 0: catode <= 8'b1111_1111;
250 6144 : 1: catode <= 8'b1111_1111;
251 6936 : 2: catode <= 8'b1111_1111;
252 6144 : 3: catode <= 8'b1111_1111;
253 6144 : 4: catode <= 8'b1000_0111;
254 6144 : 5: catode <= 8'b1000_0110;
255 6144 : 6: catode <= 8'b1100_0001;
256 6144 : 7: catode <= 8'b1000_0110;
257 : endcase
258 : end
259 :
260 49944 : 8: begin
261 49944 : case(anode_select) //HAYIR
262 6144 : 0: catode <= 8'b1111_1111;
263 6144 : 1: catode <= 8'b1111_1111;
264 6936 : 2: catode <= 8'b1111_1111;
265 6144 : 3: catode <= 8'b1100_1110;
266 6144 : 4: catode <= 8'b1111_1001;
267 6144 : 5: catode <= 8'b1001_0001;
268 6144 : 6: catode <= 8'b1000_1000;
269 6144 : 7: catode <= 8'b1000_1001;
270 : endcase
271 : end
272 49944 : 9: begin
273 49944 : case(anode_select) //SESSIZLK
274 6144 : 0: catode <= 8'b1000_1010;
275 6144 : 1: catode <= 8'b1100_0111;
276 6936 : 2: catode <= 8'b1010_0100;
277 6144 : 3: catode <= 8'b1111_1001;
278 6144 : 4: catode <= 8'b1001_0010;
279 6144 : 5: catode <= 8'b1001_0010;
280 6144 : 6: catode <= 8'b1000_0110;
281 6144 : 7: catode <= 8'b1001_0010;
282 : endcase
283 : end
284 49944 : 10: begin
285 49944 : case(anode_select) //BILINMYN
286 6144 : 0: catode <= 8'b1100_1000;
287 6144 : 1: catode <= 8'b1001_0001;
288 6855 : 2: catode <= 8'b1110_1010;
289 6225 : 3: catode <= 8'b1100_1000;
290 6144 : 4: catode <= 8'b1111_1001;
291 6144 : 5: catode <= 8'b1100_0111;
292 6144 : 6: catode <= 8'b1111_1001;
293 6144 : 7: catode <= 8'b1000_0011;
294 : endcase
295 : end
296 49980 : default: begin
297 49980 : case(anode_select) //YZUART
298 6144 : 2: catode <= 8'b1000_0111;
299 6942 : 3: catode <= 8'b1100_1110;
300 6144 : 4: catode <= 8'b1000_1000;
301 6144 : 5: catode <= 8'b1100_0001;
302 6144 : 6: catode <= 8'b1010_0100;
303 6144 : 7: catode <= 8'b1001_0001;
304 : endcase
305 : end
306 : endcase
307 :
308 : end
309 : endcase
310 54396 : end else catode <= 8'b1111_1111;
311 : end
312 : end
313 :
314 : endmodule



Generated by: LCOV version 2.0-1 (https://github.com//linux-test-project/lcov)
