YTU-YODA-KYBER/2026_teknofest-mikrodenetleyici-tasarimi/FPGA/verification/uvm/coverage/Peripherals/QSPI/index.html

LCOV - code coverage report



Current view: | top level - Peripherals/QSPI | | | Coverage | Total | Hit
Test: | YODA KYBER -- UVM satir kapsami | | Lines: | 95.0 % | 399 | 379
Test Date: | 2026-09-07 22:07:37 | | Functions: | - | 0 | 0
Legend: | Rating: low: < 75 % medium: >= 75 % high: >= 90 %





File Sort by file name | Line Coverage Sort by line coverage
| Rate | | Total | Hit
QSPI_Master_AXI4_Lite.sv

95.0% 95.0%
95.0 % | 399 | 379
Note: 'Function Coverage' columns elided as function owner is not identified.



Generated by: LCOV version 2.0-1 (https://github.com//linux-test-project/lcov)
