YTU-YODA-KYBER/2026_teknofest-mikrodenetleyici-tasarimi/FPGA/verification/uvm/coverage/Peripherals/QSPI/QSPI_Master_AXI4_Lite.sv.gcov.html

LCOV - code coverage report



Current view: | top level - Peripherals/QSPI - QSPI_Master_AXI4_Lite.sv | | | Coverage | Total | Hit
Test: | YODA KYBER -- UVM satir kapsami | | Lines: | 95.0 % | 399 | 379
Test Date: | 2026-09-07 22:07:37 | | Functions: | - | 0 | 0
Legend: | Lines: hit not hit





Line data Source code

1 :
2 : //==========================================================================
3 : // AXI4-Lite arayüzü üzerinden kontrol edilebilen QSPI Master modülü.
4 : //==========================================================================
5 : //
6 : // Bu QSPI modülünün desteklediği bazı komutlar ve açıklamaları:
7 : // -------------|------------------|-----------------------------------------------
8 : // Komut Adı | Komut Kodu (Hex) | Komut Açıklaması
9 : // -------------|------------------|-----------------------------------------------
10 : // WREN = 0x06 = 00000110 // Yazma İzni Ver (Write Enable)
11 : // WRDI = 0x04 = 00000100 // Yazma İznini Kaldır (Write Disable)
12 : // READ = 0x03 = 00000011 // Standart Okuma (x1 Modu)
13 : // DOR = 0x3B = 00111011 // Dual Output Fast Read (x2 Modu)
14 : // QOR = 0x6B = 01101011 // Quad Output Fast Read (x4 Modu)
15 : // PP = 0x02 = 00000010 // Sayfa Programlama (Page Program - x1)
16 : // QPP = 0x32 = 00110010 // Dörtlü Sayfa Programlama (Quad Page Program - x4)
17 : // SE(4KB) = 0x20 = 00100000 // Subsektör Silme (Sector Erase - 4KB)
18 : // SE(64KB) = 0xD8 = 11011000 // Sektör silme (Subsector Erase - 64KB)
19 : // RDID = 0x9F = 10011111 // JEDEC Tanımlama Bilgisini Oku
20 : // READ_ID = 0x9E = 10011110 // Cihaz Kimliğini Oku (Read ID)
21 : // RES = 0xAB = 10101011 // Elektronik İmzayı Oku (Read Electronic Signature)
22 : // RDSR1 = 0x05 = 00000101 // Durum Yazmacı-1'i Oku (Read Status logicister)
23 : // RDSR2 = 0x70 = 01110000 // Flag Durum Yazmacını Oku (Read Flag Status logicister)
24 : // RDCR = 0xB5 = 10110101 // Konfigürasyon Yazmacını Oku (Read Nonvolatile Configuration)
25 : // WRR = 0x01 = 00000001 // Yazmaçları Güncelle (Write Status logicister)
26 : // CLSR = 0x50 = 01010000 // Flag Durum Yazmacını Temizle (Clear Flag Status logicister)
27 : // RESET_en = 0x66 = 01100110 // Reset Enable
28 : // RESET_mem = 0x99 = 10011001 // Reset Memory
29 :
30 : module QSPI_Master_AXI4_Lite(
31 :
32 : // clock ve reset sinyalleri
33 22038 : input logic clk_i,
34 39 : input logic rst_n,
35 :
36 : // WRITE ADDRESS kanalları
37 74 : input logic [31:0] awaddr,
38 572 : input logic awvalid,
39 614 : output logic awready,
40 :
41 : // WRITE DATA kanalları
42 212 : input logic [31:0] wdata,
43 572 : input logic wvalid,
44 614 : output logic wready,
45 :
46 : // WRITE RESPONSE kanalları
47 0 : output logic [ 1:0] bresp,
48 581 : output logic bvalid,
49 572 : input logic bready,
50 :
51 : // READ ADDRESS kanalları
52 107 : input logic [31:0] araddr,
53 788 : input logic arvalid,
54 830 : output logic arready,
55 :
56 : // READ DATA kanalları
57 788 : input logic rready,
58 110 : output logic [31:0] rdata,
59 0 : output logic [ 1:0] rresp,
60 797 : output logic rvalid,
61 :
62 :
63 1728 : output logic QSPI_SCLK,
64 63 : output logic QSPI_CS,
65 :
66 171 : inout logic QSPI_IO0,
67 159 : inout logic QSPI_IO1,
68 39 : inout logic QSPI_IO2,
69 48 : inout logic QSPI_IO3,
70 :
71 3 : output logic [31:0] dma_data,
72 9 : output logic dma_valid
73 :
74 : );
75 :
76 : // I/O Portları
77 108 : wire QSPI_IO0_out;
78 30 : wire QSPI_IO0_oe;
79 171 : wire QSPI_IO0_in;
80 :
81 3 : wire QSPI_IO1_out;
82 3 : wire QSPI_IO1_oe;
83 159 : wire QSPI_IO1_in;
84 :
85 3 : wire QSPI_IO2_out;
86 3 : wire QSPI_IO2_oe;
87 39 : wire QSPI_IO2_in;
88 :
89 3 : wire QSPI_IO3_out;
90 3 : wire QSPI_IO3_oe;
91 48 : wire QSPI_IO3_in;
92 :
93 : IOBUF IOBUF_QSPI_IO0 (.I(QSPI_IO0_out), .T(~QSPI_IO0_oe), .O(QSPI_IO0_in), .IO(QSPI_IO0));
94 : IOBUF IOBUF_QSPI_IO1 (.I(QSPI_IO1_out), .T(~QSPI_IO1_oe), .O(QSPI_IO1_in), .IO(QSPI_IO1));
95 : IOBUF IOBUF_QSPI_IO2 (.I(QSPI_IO2_out), .T(~QSPI_IO2_oe), .O(QSPI_IO2_in), .IO(QSPI_IO2));
96 : IOBUF IOBUF_QSPI_IO3 (.I(QSPI_IO3_out), .T(~QSPI_IO3_oe), .O(QSPI_IO3_in), .IO(QSPI_IO3));
97 :
98 :
99 39 : logic [31:0] QSPI_CCR;
100 35 : logic [31:0] QSPI_ADR;
101 102 : logic [31:0] QSPI_DR;
102 104 : logic [31:0] QSPI_STA;
103 57 : logic [31:0] QSPI_FCR;
104 :
105 : // LUTRAM kullanıyoruz
106 : (* ram_style = "distributed" *) logic [31:0] FIFO_TX [0:63];
107 : (* ram_style = "distributed" *) logic [31:0] FIFO_RX [0:63];
108 :
109 12 : logic [31:0] fifo_tx_rdata; // TX FIFO'dan okunan veriyi tutar.
110 102 : logic [ 6:0] fifo_tx_cnt; // TX FIFO'nun güncel doluluk sayısını tutar.
111 102 : logic [ 5:0] tx_wr_ptr; // TX FIFO'ya yazacağı yeri gösterir.
112 6 : logic [ 5:0] tx_rd_ptr; // TX FIFO'ya yazılacak yeri gösterir.
113 :
114 21 : logic [31:0] fifo_rx_rdata; // RX FIFO'dan okunan veriyi tutar.
115 12 : logic [31:0] fifo_rx_wdata; // RX FIFO'ya yazılacak veriyi tutar.
116 352 : logic [ 6:0] fifo_rx_cnt; // RX FIFO'nun güncel doluluk sayısını tutar.
117 24 : logic [ 5:0] rx_wr_ptr; // RX FIFO'ya yazacağı yeri gösterir.
118 343 : logic [ 5:0] rx_rd_ptr; // RX FIFO'ya yazılacak yeri gösterir.
119 :
120 :
121 : localparam IDLE = 1;
122 : localparam SEND = 2;
123 : localparam LOAD = 3;
124 :
125 : localparam x1 = 1;
126 : localparam x2 = 2;
127 : localparam x4 = 4;
128 :
129 : localparam read = 0;
130 : localparam write = 1;
131 :
132 30 : logic start; // QSPI_CCR'ye yazma yapıldığını ve çekirdeğin ayağa kalkması gerektiğini gösterir.
133 30 : logic finish; // Yazma veya okuma işleminin bittiğini gösterir ve QSPI_STA[0] bitini 1 yapmaya yarar.
134 6 : logic set_finish; // finish sinyalini qspi_falling_edge'den 1 clk önce 1 yapar, böylece finish sinyali tam olarak qspi_falling_edge'de 1 olur.
135 123 : logic [ 2:0] fifo_status; // QSPI ile FIFO I/O işleminin hangi FSM'de olduğunu gösterir.
136 6888 : logic [ 5:0] prscl_cnt; // Clk divider için kullanılan sayacın verisini tutar.
137 30 : logic busy; // Modül flaş bellek ile ilgilenirken değeri 1 olur.
138 30 : logic [ 3:0] to_do_list; // 0. instruction, 1. adres, 2. dummy, 3. bit ise FIFO ile ilgili bir işlemin varlığını gösterir.
139 18 : logic fifo_rx_load_data; // Değeri 1 olduğunda RX FIFO'su yeni verisini "fifo_rx_rdata"ya yükler.
140 6 : logic fifo_tx_load_data;
141 45 : logic [ 2:0] data_mode; // Verinin hangi modda (x1, x2 ya da x4) modunda işleme alınacağının bilgisini tutar.
142 759 : logic [ 5:0] shift_cnt; // FIFO'da veri kaydırma işlemlerinde veri uzunluğu hesaplanırken kullanılır.
143 171 : logic [31:0] shift_byte; // FIFO'da veri kaydırma işlemlerinde kaydırılan veriyi tutar.
144 63 : logic r_w; // Yapılan işlemin yazma mı yoksa okuma mı olduğu bilgisini tutar.
145 27 : logic [ 8:0] data_byte_size; // Flaşa yazılacak/okunacak kaç bayt verinin kaldığının bilgisini tutar.
146 36 : logic [ 4:0] dummy_cycle; // Güncel yapılacak dummy cycle sayısını tutar
147 198 : logic fifo_tx_push_data; // AXI TX FIFO'ya yazma isteği gönderdiği zaman gelen veriyi yazmak için FIFO'ya istek gönderir.
148 27 : logic fifo_rx_push_data;
149 1704 : logic qspi_falling_edge; // QSPI modülünün çalışması için ayarlanan frekanstaki falling edge durumundan 1 clk önce 1 olur.
150 1728 : logic qspi_rising_edge; // QSPI modülünün çalışması için ayarlanan frekanstaki rising edge durumundan 1 clk önce 1 olur.
151 3 : logic [ 3:0] fifo_error; // QSPI_STA register'ının değerini güncellemek için kullanılır.
152 :
153 108 : logic io0_val;
154 3 : logic io1_val;
155 3 : logic io2_val;
156 3 : logic io3_val;
157 30 : logic io0_oe;
158 3 : logic io1_oe;
159 3 : logic io2_oe;
160 3 : logic io3_oe;
161 :
162 16 : logic dma_start;
163 9 : logic dma_rd_data;
164 :
165 : // ---------------------------------------------------------
166 : // CLK DIVIDER
167 : // ---------------------------------------------------------
168 22044 : always @(posedge clk_i or negedge rst_n) begin
169 :
170 207 : if(!rst_n)begin
171 207 : prscl_cnt <= 0;
172 207 : QSPI_SCLK <= 0;
173 207 : qspi_falling_edge <= 0;
174 207 : qspi_rising_edge <= 0;
175 : end
176 13752 : else if(!QSPI_CS)begin
177 0 : if(QSPI_CCR[30:25] == 1 && !QSPI_SCLK) qspi_falling_edge <= 1;
178 12048 : else if(prscl_cnt + 2 == QSPI_CCR[30:25] && QSPI_SCLK) qspi_falling_edge <= 1;
179 12048 : else qspi_falling_edge <= 0;
180 :
181 0 : if(QSPI_CCR[30:25] == 1 && QSPI_SCLK) qspi_rising_edge <= 1;
182 12024 : else if(prscl_cnt + 2 == QSPI_CCR[30:25] && !QSPI_SCLK) qspi_rising_edge <= 1;
183 12024 : else qspi_rising_edge <= 0;
184 :
185 10320 : if(prscl_cnt == QSPI_CCR[30:25]-1)begin
186 3432 : prscl_cnt <= 0;
187 3432 : QSPI_SCLK <= ~QSPI_SCLK;
188 : end
189 10320 : else prscl_cnt <= prscl_cnt +1;
190 : end
191 8085 : else begin
192 8085 : prscl_cnt <= 0;
193 8085 : QSPI_SCLK <= 0;
194 8085 : qspi_falling_edge <= 0;
195 8085 : qspi_rising_edge <= 0;
196 : end
197 : end
198 :
199 : // ---------------------------------------------------------
200 : // FIFO'LAR
201 : // ---------------------------------------------------------
202 22038 : always @(posedge clk_i) begin
203 :
204 : // TX FIFO'ya data yazma isteği
205 21840 : if(fifo_tx_push_data && !QSPI_STA[6]) begin
206 198 : FIFO_TX[tx_wr_ptr] <= QSPI_DR;
207 : end
208 : end
209 : // TX READ
210 : assign fifo_tx_rdata = FIFO_TX[tx_rd_ptr];
211 :
212 :
213 :
214 22038 : always @(posedge clk_i) begin
215 : // RX FIFO'ya data yazma isteği
216 22011 : if(fifo_rx_push_data && !QSPI_STA[4]) begin
217 27 : FIFO_RX[rx_wr_ptr] <= fifo_rx_wdata;
218 : end
219 : end
220 : // RX READ
221 : assign fifo_rx_rdata = FIFO_RX[rx_rd_ptr];
222 :
223 :
224 :
225 :
226 :
227 : assign QSPI_IO0_out = io0_val;
228 : assign QSPI_IO1_out = io1_val;
229 : assign QSPI_IO2_out = io2_val;
230 : assign QSPI_IO3_out = io3_val;
231 : assign QSPI_IO0_oe = io0_oe;
232 : assign QSPI_IO1_oe = io1_oe;
233 : assign QSPI_IO2_oe = io2_oe;
234 : assign QSPI_IO3_oe = io3_oe;
235 :
236 :
237 22044 : always@(posedge clk_i or negedge rst_n)begin
238 207 : if(!rst_n)begin
239 207 : QSPI_STA <= 0;
240 : end
241 21798 : else if(QSPI_CCR[31]) QSPI_STA <= 0;
242 21798 : else begin
243 21798 : QSPI_STA[0] <= finish;
244 21798 : QSPI_STA[1] <= busy;
245 21798 : QSPI_STA[4] <= fifo_rx_cnt == 64; // RX FIFO full.
246 21798 : QSPI_STA[5] <= fifo_rx_cnt ? 0 : 1; // RX FIFO empty. ////////////////////////
247 21798 : QSPI_STA[6] <= fifo_tx_cnt == 64; // TX FIFO full.
248 21798 : QSPI_STA[7] <= fifo_tx_cnt ? 0 : 1; // TX FIFO empty.
249 21798 : QSPI_STA[11:8] <= fifo_error; // '0000' Hata yok.
250 : // '0001' RX FIFO boşken okunmaya çalışıldı.
251 : // '0010' TX FIFO doluyken yazılmaya çalışıldı.
252 : end
253 : end
254 :
255 :
256 : // ---------------------------------------------------------
257 : // QSPI ÇEKİRDEĞİ
258 : // ---------------------------------------------------------
259 22044 : always @(posedge clk_i or negedge rst_n) begin
260 :
261 21837 : if(!rst_n)begin
262 207 : fifo_tx_load_data <= 0;
263 207 : fifo_rx_push_data <= 0;
264 207 : fifo_rx_cnt <= 0;
265 207 : fifo_tx_cnt <= 0;
266 207 : rx_wr_ptr <= 0;
267 207 : rx_rd_ptr <= 0;
268 207 : tx_wr_ptr <= 0;
269 207 : tx_rd_ptr <= 0;
270 :
271 207 : finish <= 0;
272 207 : set_finish <= 0;
273 207 : busy <= 0;
274 207 : r_w <= 0;
275 207 : dummy_cycle <= 0;
276 207 : data_byte_size <= 0;
277 207 : shift_byte <= 0;
278 207 : shift_cnt <= 0;
279 207 : to_do_list <= 0;
280 207 : data_mode <= 1;
281 207 : QSPI_CS <= 1;
282 207 : fifo_status <= IDLE;
283 :
284 207 : io0_val <= 0;
285 207 : io1_val <= 0;
286 207 : io2_val <= 0;
287 207 : io3_val <= 0;
288 207 : io0_oe <= 0;
289 207 : io1_oe <= 0;
290 207 : io2_oe <= 0;
291 207 : io3_oe <= 0;
292 :
293 207 : dma_data <= 32'b0;
294 207 : dma_rd_data <= 1'b0;
295 207 : dma_valid <= 1'b0;
296 : end
297 21837 : else begin
298 :
299 21821 : if(dma_start) dma_rd_data <= 1;
300 21184 : if(!dma_rd_data) dma_valid <= 0;
301 :
302 21831 : if(fifo_tx_load_data) fifo_tx_load_data <= 0;
303 :
304 21831 : if((qspi_falling_edge && set_finish))begin
305 6 : finish <= 1;
306 6 : set_finish <= 0;
307 : end
308 :
309 21798 : if(QSPI_CCR[31]) begin
310 39 : finish <= 0;
311 : end
312 :
313 :
314 21780 : if(QSPI_FCR[0])begin
315 57 : fifo_rx_cnt <= 0;
316 57 : rx_wr_ptr <= 0;
317 57 : rx_rd_ptr <= 0;
318 : end
319 21784 : if(QSPI_FCR[1])begin
320 53 : fifo_tx_cnt <= 0;
321 53 : tx_wr_ptr <= 0;
322 53 : tx_rd_ptr <= 0;
323 : end
324 :
325 21810 : if(fifo_rx_push_data) begin
326 27 : rx_wr_ptr <= rx_wr_ptr +1;
327 27 : fifo_rx_cnt <= fifo_rx_cnt +1;
328 27 : if(rx_wr_ptr == 63) rx_wr_ptr <= 0;
329 : end
330 :
331 : // RX FIFO'dan data okuma isteği
332 21166 : if((fifo_rx_load_data || dma_rd_data)) begin
333 671 : rx_rd_ptr <= rx_rd_ptr +1;
334 671 : fifo_rx_cnt <= fifo_rx_cnt -1;
335 661 : if(rx_rd_ptr == 63) rx_rd_ptr <= 0;
336 :
337 653 : if(dma_rd_data)begin
338 653 : dma_valid <= 1;
339 653 : dma_data <= fifo_rx_rdata;
340 645 : if(fifo_rx_cnt == 1) begin
341 8 : dma_rd_data <= 0;
342 : end
343 : end
344 :
345 : end
346 :
347 21639 : if(fifo_tx_push_data) begin
348 198 : tx_wr_ptr <= tx_wr_ptr +1;
349 198 : fifo_tx_cnt <= fifo_tx_cnt +1;
350 195 : if(tx_wr_ptr == 63) tx_wr_ptr <= 0;
351 : end
352 :
353 21831 : if(fifo_tx_load_data)begin
354 6 : tx_rd_ptr <= tx_rd_ptr +1;
355 6 : if(tx_rd_ptr == 63) tx_rd_ptr <= 0;
356 6 : fifo_tx_cnt <= fifo_tx_cnt -1;
357 : end
358 :
359 21810 : if(fifo_rx_push_data) fifo_rx_push_data <= 0;
360 :
361 21837 : case(fifo_status)
362 :
363 8127 : IDLE: begin
364 : // QSPI_CCR'ye yazma yapıldıysa çekirdeği ayağa kaldır.
365 8097 : if(start && !busy)begin
366 30 : shift_byte[31:25] <= QSPI_CCR[6:0];
367 30 : busy <= 1;
368 30 : to_do_list[0] <= 1;
369 30 : to_do_list[1] <= |QSPI_CCR[24];
370 30 : to_do_list[2] <= |QSPI_CCR[9:8] && !QSPI_CCR[10];
371 30 : to_do_list[3] <= |QSPI_CCR[9:8];
372 30 : data_byte_size <= QSPI_CCR[23:16] + 1;
373 30 : QSPI_CS <= 0;
374 :
375 30 : io0_val <= QSPI_CCR[7];
376 30 : io0_oe <= 1;
377 30 : fifo_status <= SEND;
378 :
379 30 : shift_cnt <= 7;
380 :
381 30 : dummy_cycle <= QSPI_CCR[15:11];
382 : end
383 8097 : else begin
384 8061 : if(qspi_falling_edge || QSPI_CS) begin
385 8061 : r_w <= write;
386 8061 : QSPI_CS <= 1;
387 8061 : busy <= 0;
388 8061 : data_mode <= 1;
389 :
390 8061 : io0_oe <= 0;
391 8061 : io1_oe <= 0;
392 8061 : io2_oe <= 0;
393 8061 : io3_oe <= 0;
394 : end
395 :
396 : end
397 : end
398 :
399 12876 : SEND: begin
400 12876 : case(r_w)
401 :
402 5085 : read: begin
403 :
404 4437 : if(qspi_rising_edge) begin
405 648 : case(data_mode)
406 552 : x1: begin
407 552 : shift_byte <= {shift_byte[30:0], QSPI_IO1_in};
408 : end
409 48 : x2: begin
410 48 : shift_byte <= {shift_byte[29:0], QSPI_IO1_in, QSPI_IO0_in};
411 : end
412 48 : x4: begin
413 48 : shift_byte <= {shift_byte[27:0], QSPI_IO3_in, QSPI_IO2_in, QSPI_IO1_in, QSPI_IO0_in};
414 : end
415 : endcase
416 : end
417 : end
418 :
419 7791 : write: begin
420 6813 : if(qspi_falling_edge)begin
421 978 : case(data_mode)
422 954 : x1: begin
423 954 : io0_val <= shift_byte[31];
424 954 : io0_oe <= 1;
425 954 : shift_byte <= shift_byte << 1;
426 : end
427 :
428 0 : x2: begin
429 0 : io0_val <= shift_byte[30];
430 0 : io1_val <= shift_byte[31];
431 0 : io0_oe <= 1;
432 0 : io1_oe <= 1;
433 0 : shift_byte <= shift_byte << 2;
434 :
435 : end
436 :
437 24 : x4: begin
438 24 : io0_val <= shift_byte[28];
439 24 : io1_val <= shift_byte[29];
440 24 : io2_val <= shift_byte[30];
441 24 : io3_val <= shift_byte[31];
442 24 : io0_oe <= 1;
443 24 : io1_oe <= 1;
444 24 : io2_oe <= 1;
445 24 : io3_oe <= 1;
446 24 : shift_byte <= shift_byte << 4;
447 : end
448 : endcase
449 : end
450 : end
451 : endcase
452 11250 : if(r_w && qspi_falling_edge || (!r_w && qspi_rising_edge))begin
453 1536 : if (shift_cnt == data_mode)begin
454 :
455 30 : if(to_do_list[0]) to_do_list[0] <= 0;
456 27 : else if(to_do_list[1]) begin
457 27 : to_do_list[1] <= 0;
458 18 : if(QSPI_CCR[9:8] == 3) data_mode <= 4;
459 18 : else data_mode <= QSPI_CCR[9:8];
460 27 : r_w <= QSPI_CCR[10];
461 : end
462 30 : else if(to_do_list[2]) to_do_list[2] <= 0;
463 30 : else to_do_list <= 0;
464 :
465 90 : fifo_status <= LOAD;
466 :
467 :
468 : end
469 1536 : else shift_cnt <= shift_cnt - data_mode;
470 : end
471 : end
472 :
473 834 : LOAD:begin
474 27 : if (to_do_list[1])begin
475 27 : if(QSPI_FCR[2] == 1) begin
476 0 : shift_byte <= QSPI_ADR;
477 0 : shift_cnt <= 32;
478 27 : end else begin
479 27 : shift_byte[31:8] <= QSPI_ADR[23:0];
480 27 : shift_cnt <= 24;
481 : end
482 27 : fifo_status <= SEND;
483 : end
484 :
485 768 : else if (to_do_list[2])begin
486 :
487 672 : if(qspi_falling_edge) begin
488 :
489 96 : io0_oe <= 0;
490 96 : io1_oe <= 0;
491 96 : io2_oe <= 0;
492 96 : io3_oe <= 0;
493 :
494 72 : if (dummy_cycle)begin
495 72 : dummy_cycle <= dummy_cycle -1;
496 : end
497 24 : else begin
498 21 : if(data_byte_size > 4) begin
499 3 : shift_cnt <= 32;
500 3 : data_byte_size <= data_byte_size -4;
501 3 : to_do_list[2] <= 1;
502 : end
503 21 : else begin
504 21 : case (data_byte_size)
505 0 : 1: shift_cnt <= 8;
506 0 : 2: shift_cnt <= 16;
507 3 : 3: shift_cnt <= 24;
508 18 : 4: shift_cnt <= 32;
509 : endcase
510 21 : data_byte_size <= 0;
511 21 : to_do_list[2] <= 0;
512 : end
513 18 : if(QSPI_CCR[9:8] == 3) data_mode <= 4;
514 18 : else data_mode <= QSPI_CCR[9:8];
515 24 : r_w <= QSPI_CCR[10];
516 24 : fifo_status <= SEND;
517 : end
518 : end
519 : end
520 :
521 30 : else if (to_do_list[3])begin
522 :
523 9 : if(data_byte_size > 4) begin
524 0 : shift_cnt <= 32;
525 0 : data_byte_size <= data_byte_size -4;
526 0 : to_do_list[2] <= 1;
527 : end
528 9 : else begin
529 9 : case (data_byte_size)
530 0 : 1: shift_cnt <= 8;
531 0 : 2: shift_cnt <= 16;
532 0 : 3: shift_cnt <= 24;
533 9 : 4: shift_cnt <= 32;
534 : endcase
535 9 : data_byte_size <= 0;
536 : end
537 6 : if (r_w) begin
538 6 : if(fifo_tx_cnt) begin
539 6 : shift_byte <= {fifo_tx_rdata};
540 6 : fifo_tx_load_data <= 1;
541 : end
542 : end
543 3 : else begin
544 3 : if(fifo_rx_cnt <= 64) begin
545 3 : fifo_rx_push_data <= 1;
546 3 : fifo_rx_wdata <= shift_byte;
547 : end
548 : end
549 :
550 9 : fifo_status <= SEND;
551 : end
552 :
553 30 : else begin
554 24 : if(!r_w) begin
555 24 : QSPI_CS <= 1;
556 24 : if(fifo_rx_cnt <= 64) begin
557 24 : fifo_rx_push_data <= 1;
558 24 : fifo_rx_wdata <= shift_byte;
559 : end
560 : end
561 24 : if(r_w) set_finish <= 1;
562 24 : else finish <= 1;
563 30 : fifo_status <= IDLE;
564 : end
565 : end
566 : endcase
567 : end
568 : end
569 :
570 :
571 :
572 :
573 22044 : always @(posedge clk_i or negedge rst_n) begin
574 :
575 : // ---------------------------------------------------------
576 : // RESET İŞLEMLERİ
577 : // ---------------------------------------------------------
578 21837 : if(!rst_n)begin
579 207 : QSPI_CCR <= 0;
580 207 : QSPI_ADR <= 0;
581 207 : QSPI_DR <= 0;
582 207 : QSPI_FCR <= 0;
583 :
584 207 : bresp <= 2'b00;
585 207 : bvalid <= 1'b0;
586 207 : rdata <= 32'h0000;
587 207 : rresp <= 2'b00;
588 207 : rvalid <= 1'b0;
589 207 : awready <= 1;
590 207 : wready <= 1;
591 207 : arready <= 1;
592 :
593 207 : fifo_tx_push_data <= 0;
594 207 : fifo_rx_load_data <= 0;
595 207 : fifo_error <= 0;
596 207 : start <= 0;
597 207 : dma_start <= 0;
598 : end
599 21837 : else begin
600 :
601 21798 : if(QSPI_CCR[31]) begin
602 39 : fifo_error <= 0;
603 39 : QSPI_CCR[31] <= 0;
604 : end
605 :
606 21821 : if(dma_start) dma_start <= 0;
607 :
608 21819 : if(fifo_rx_load_data) fifo_rx_load_data <= 0;
609 21639 : if(fifo_tx_push_data) fifo_tx_push_data <= 0;
610 :
611 21807 : if(start) start <= 0;
612 21760 : if(QSPI_FCR) QSPI_FCR <= 0;
613 : // ---------------------------------------------------------
614 : // AXI YAZMA İŞLEMİ
615 : // ---------------------------------------------------------
616 :
617 581 : if (awvalid && wvalid && awready && wready) begin
618 581 : awready <= 1'b0;
619 581 : wready <= 1'b0;
620 581 : bvalid <= 1'b1;
621 :
622 581 : case (awaddr[7:0])
623 69 : 8'h00: begin
624 69 : QSPI_CCR <= wdata;
625 39 : if(wdata[31] == 0)start <= 1;
626 : end
627 193 : 8'h04: QSPI_ADR <= wdata;
628 201 : 8'h08: begin
629 198 : if(QSPI_STA[6]) begin
630 3 : fifo_error[1] <= 1;
631 : end
632 198 : else begin
633 198 : QSPI_DR <= wdata;
634 198 : fifo_tx_push_data <= 1;
635 : end
636 : end
637 77 : 8'h10: QSPI_FCR <= wdata;
638 26 : 8'h14: dma_start <= wdata[0];
639 : endcase
640 : end
641 :
642 20675 : else if (bvalid && bready) begin
643 581 : bvalid <= 1'b0;
644 581 : awready <= 1'b1;
645 581 : wready <= 1'b1;
646 : end
647 :
648 :
649 : // ---------------------------------------------------------
650 : // AXI OKUMA İŞLEMİ
651 : // ---------------------------------------------------------
652 797 : if (arvalid && arready) begin
653 797 : arready <= 0;
654 797 : rvalid <= 1'b1;
655 :
656 797 : case (araddr[7:0])
657 3 : 8'h00: rdata <= QSPI_CCR;
658 209 : 8'h04: rdata <= QSPI_ADR;
659 21 : 8'h08: begin
660 18 : if(QSPI_STA[5]) begin
661 3 : rdata <= 0;
662 3 : fifo_error[0] <= 1;
663 : end
664 18 : else begin
665 18 : rdata <= fifo_rx_rdata;
666 18 : fifo_rx_load_data <= 1;
667 : end
668 : end
669 410 : 8'h0C: rdata <= QSPI_STA;
670 79 : 8'h10: rdata <= QSPI_FCR;
671 54 : 8'h14: rdata <= {31'b0, dma_valid};
672 :
673 21 : default: rdata <= 32'h00000000;
674 : endcase
675 : end
676 20243 : else if (rvalid && rready) begin
677 797 : arready <= 1;
678 797 : rvalid <= 1'b0;
679 : end
680 :
681 : end
682 : end
683 :
684 : endmodule



Generated by: LCOV version 2.0-1 (https://github.com//linux-test-project/lcov)
