YTU-YODA-KYBER/2026_teknofest-mikrodenetleyici-tasarimi/FPGA/verification/uvm/coverage/Peripherals/Timer/Timer_AXI4_Lite.sv.gcov.html

LCOV - code coverage report



Current view: | top level - Peripherals/Timer - Timer_AXI4_Lite.sv | | | Coverage | Total | Hit
Test: | YODA KYBER -- UVM satir kapsami | | Lines: | 97.1 % | 105 | 102
Test Date: | 2026-09-07 22:07:37 | | Functions: | - | 0 | 0
Legend: | Lines: hit not hit





Line data Source code

1 : module Timer_AXI4_Lite
2 : (
3 : // clock ve reset sinyalleri
4 9262 : input logic clk_i,
5 33 : input logic rst_n,
6 :
7 : // AW Portları
8 83 : input logic [31:0] awaddr,
9 665 : input logic awvalid,
10 701 : output logic awready,
11 :
12 : // WD Portları
13 85 : input logic [31:0] wdata,
14 665 : input logic wvalid,
15 701 : output logic wready,
16 :
17 : // B Portları
18 0 : output logic [ 1:0] bresp,
19 674 : output logic bvalid,
20 665 : input logic bready,
21 :
22 : // AR Portları
23 115 : input logic [31:0] araddr,
24 810 : input logic arvalid,
25 846 : output logic arready,
26 :
27 : // R Portları
28 810 : input logic rready,
29 85 : output logic [31:0] rdata,
30 0 : output logic [ 1:0] rresp,
31 819 : output logic rvalid
32 : );
33 :
34 : // REGISTER TANIMLARI
35 1121 : reg [31:0] TIM_PRE;
36 29 : reg [31:0] TIM_PRE_m;
37 21 : reg [31:0] TIM_ARE;
38 18 : reg [31:0] TIM_CLR;
39 35 : reg [31:0] TIM_ENA;
40 19 : reg [31:0] TIM_MOD;
41 766 : reg [31:0] TIM_CNT;
42 155 : reg [31:0] TIM_EVN;
43 12 : reg [31:0] TIM_EVC;
44 :
45 :
46 :
47 9268 : always @(posedge clk_i or negedge rst_n) begin
48 :
49 : // ---------------------------------------------------------
50 : // RESET İŞLEMLERİ
51 : // ---------------------------------------------------------
52 9091 : if (!rst_n) begin
53 177 : TIM_PRE <= 0;
54 177 : TIM_PRE_m <= 0;
55 177 : TIM_ARE <= 0;
56 177 : TIM_CLR <= 0;
57 177 : TIM_ENA <= 0;
58 177 : TIM_MOD <= 0;
59 177 : TIM_CNT <= 0;
60 177 : TIM_EVN <= 0;
61 177 : TIM_EVC <= 0;
62 :
63 177 : bresp <= 0;
64 177 : bvalid <= 0;
65 177 : rdata <= 0;
66 177 : rresp <= 0;
67 177 : rvalid <= 0;
68 177 : awready <= 1;
69 177 : wready <= 1;
70 177 : arready <= 1;
71 : end
72 9091 : else begin
73 :
74 : // --------------------------------------------------
75 : // AXI YAZMA İŞLEMİ
76 : // --------------------------------------------------
77 :
78 674 : if (awvalid && wvalid && awready && wready) begin
79 674 : bvalid <= 1'b1;
80 674 : wready <= 1'b0;
81 674 : awready <= 1'b0;
82 :
83 674 : case (awaddr[7:0])
84 156 : 8'h00: TIM_PRE_m <= wdata;
85 136 : 8'h04: TIM_ARE <= wdata;
86 21 : 8'h08: TIM_CLR <= wdata;
87 188 : 8'h0C: TIM_ENA <= wdata;
88 134 : 8'h10: TIM_MOD <= wdata;
89 15 : 8'h1C: TIM_EVC <= wdata;
90 24 : default: ;
91 : endcase
92 : end
93 :
94 7743 : else if (bvalid && bready) begin
95 674 : bvalid <= 1'b0;
96 674 : awready <= 1'b1;
97 674 : wready <= 1'b1;
98 : end
99 :
100 : // --------------------------------------------------
101 : // AXI OKUMA İŞLEMİ
102 : // --------------------------------------------------
103 819 : if (arvalid && arready) begin
104 819 : rvalid <= 1'b1;
105 819 : arready <= 0;
106 :
107 819 : case (araddr[7:0])
108 139 : 8'h00: rdata <= TIM_PRE_m;
109 142 : 8'h04: rdata <= TIM_ARE;
110 45 : 8'h08: rdata <= TIM_CLR;
111 141 : 8'h0C: rdata <= TIM_ENA;
112 152 : 8'h10: rdata <= TIM_MOD;
113 74 : 8'h14: rdata <= TIM_CNT;
114 62 : 8'h18: rdata <= TIM_EVN;
115 40 : 8'h1C: rdata <= TIM_EVC;
116 24 : default: rdata <= 0;
117 : endcase
118 : end
119 7453 : else if (rvalid && rready) begin
120 819 : rvalid <= 1'b0;
121 819 : arready <= 1;
122 : end
123 :
124 : // ----------------------------------------------------
125 : // TIMER ÇEKİRDEĞİ
126 : // ----------------------------------------------------
127 18 : if (TIM_CLR[0]) begin
128 18 : TIM_CNT <= 0;
129 18 : TIM_PRE <= TIM_PRE_m;
130 18 : TIM_CLR <= 0;
131 : end
132 12 : else if (TIM_EVC[0]) begin
133 12 : TIM_EVN <= 0;
134 12 : TIM_EVC <= 0;
135 : end
136 5238 : else if (TIM_ENA[0]) begin
137 :
138 : // Sayma İşlemleri
139 2162 : if (TIM_PRE == 0) begin
140 1661 : TIM_PRE <= TIM_PRE_m;
141 :
142 1661 : case (TIM_MOD[0])
143 1331 : 1: begin // Yukarı Sayıcı
144 1129 : if (TIM_CNT >= TIM_ARE) begin
145 202 : TIM_EVN <= TIM_EVN + 1;
146 202 : TIM_CNT <= 0;
147 1129 : end else begin
148 1129 : TIM_CNT <= TIM_CNT + 1;
149 : end
150 : end
151 330 : 0: begin // Aşağı Sayıcı
152 236 : if (TIM_CNT == 0) begin
153 94 : TIM_CNT <= TIM_ARE;
154 94 : TIM_EVN <= TIM_EVN + 1;
155 236 : end else begin
156 236 : TIM_CNT <= TIM_CNT - 1;
157 : end
158 : end
159 0 : default: ;
160 : endcase
161 2162 : end else begin
162 2162 : TIM_PRE <= TIM_PRE - 1;
163 : end
164 : end
165 :
166 : end//else
167 : end//always bloğu
168 :
169 : endmodule



Generated by: LCOV version 2.0-1 (https://github.com//linux-test-project/lcov)
