YTU-YODA-KYBER/2026_teknofest-mikrodenetleyici-tasarimi/FPGA/scripts/yz_accuracy/results_board.csv

dosya | etiket | hw | sw | hw_cevrim | sw_cevrim
dataset/.hex_cache/bilinmeyen/bed_0ea0e2f4_nohash_1.wav.hex | 1 | 1 | 1 | 45539 | 12610073
dataset/.hex_cache/bilinmeyen/bird_2c6d3924_nohash_0.wav.hex | 1 | 1 | 1 | 45539 | 12605792
dataset/.hex_cache/bilinmeyen/cat_8fe67225_nohash_0.wav.hex | 1 | 1 | 1 | 45539 | 12607586
dataset/.hex_cache/bilinmeyen/dog_85d2ac4b_nohash_2.wav.hex | 1 | 3 | 3 | 45539 | 12609857
dataset/.hex_cache/bilinmeyen/eight_67961766_nohash_0.wav.hex | 1 | 1 | 1 | 45539 | 12605321
dataset/.hex_cache/bilinmeyen/eight_82b99576_nohash_0.wav.hex | 1 | 1 | 1 | 45539 | 12609275
dataset/.hex_cache/bilinmeyen/eight_f9643d42_nohash_2.wav.hex | 1 | 1 | 1 | 45539 | 12610070
dataset/.hex_cache/bilinmeyen/five_7dc95912_nohash_1.wav.hex | 1 | 1 | 1 | 45539 | 12610829
dataset/.hex_cache/bilinmeyen/five_c7dc7278_nohash_0.wav.hex | 1 | 1 | 1 | 45539 | 12607895
dataset/.hex_cache/bilinmeyen/follow_b7e9f841_nohash_2.wav.hex | 1 | 1 | 1 | 45539 | 12608780
dataset/.hex_cache/bilinmeyen/forward_c7dc7278_nohash_2.wav.hex | 1 | 1 | 1 | 45539 | 12607805
dataset/.hex_cache/bilinmeyen/four_5170b77f_nohash_2.wav.hex | 1 | 3 | 3 | 45539 | 12608063
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
