YTU-YODA-KYBER/2026_teknofest-mikrodenetleyici-tasarimi/FPGA/demo/demo_program_tr/results/YTU_YODA_KYBER_20260910_220151/samples.csv

index | name | golden_ref | predicted | matches_golden | truth_info | matches_truth_info | golden_scores | scores | score_error_pct | latency_ms | tx_ms | timeout | retries | raw
0 | go_f19279c4_nohash_0 | no | no | 1 | unknown | 0 | -128;-107;-121;100 | -128;-107;-121;100 | 0.0000 | 8.400 | 21.012 | 0 | 0 | YZ:3 S=-128;-107;-121;100
1 | no_256c0a05_nohash_0 | no | no | 1 | no | 1 | -128;-127;-128;126 | -128;-127;-128;126 | 0.0000 | 8.357 | 20.952 | 0 | 0 | YZ:3 S=-128;-127;-128;126
2 | no_9be15e93_nohash_0 | no | no | 1 | no | 1 | -128;-127;-128;127 | -128;-127;-128;127 | 0.0000 | 8.394 | 21.243 | 0 | 0 | YZ:3 S=-128;-127;-128;127
3 | yes_ffb86d3c_nohash_0 | yes | yes | 1 | yes | 1 | -128;-127;127;-128 | -128;-127;127;-128 | 0.0000 | 8.364 | 20.986 | 0 | 0 | YZ:2 S=-128;-127;127;-128
4 | go_0c40e715_nohash_1 | no | no | 1 | unknown | 0 | -128;-124;-128;124 | -128;-124;-128;124 | 0.0000 | 8.155 | 21.269 | 0 | 0 | YZ:3 S=-128;-124;-128;124
5 | yes_7be9f58a_nohash_0 | yes | yes | 1 | yes | 1 | -128;-120;98;-105 | -128;-120;98;-105 | 0.0000 | 9.428 | 20.217 | 0 | 0 | YZ:2 S=-128;-120;98;-105
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
