YTU-YODA-KYBER/2026_teknofest-mikrodenetleyici-tasarimi/asic/results/images/top_module.png

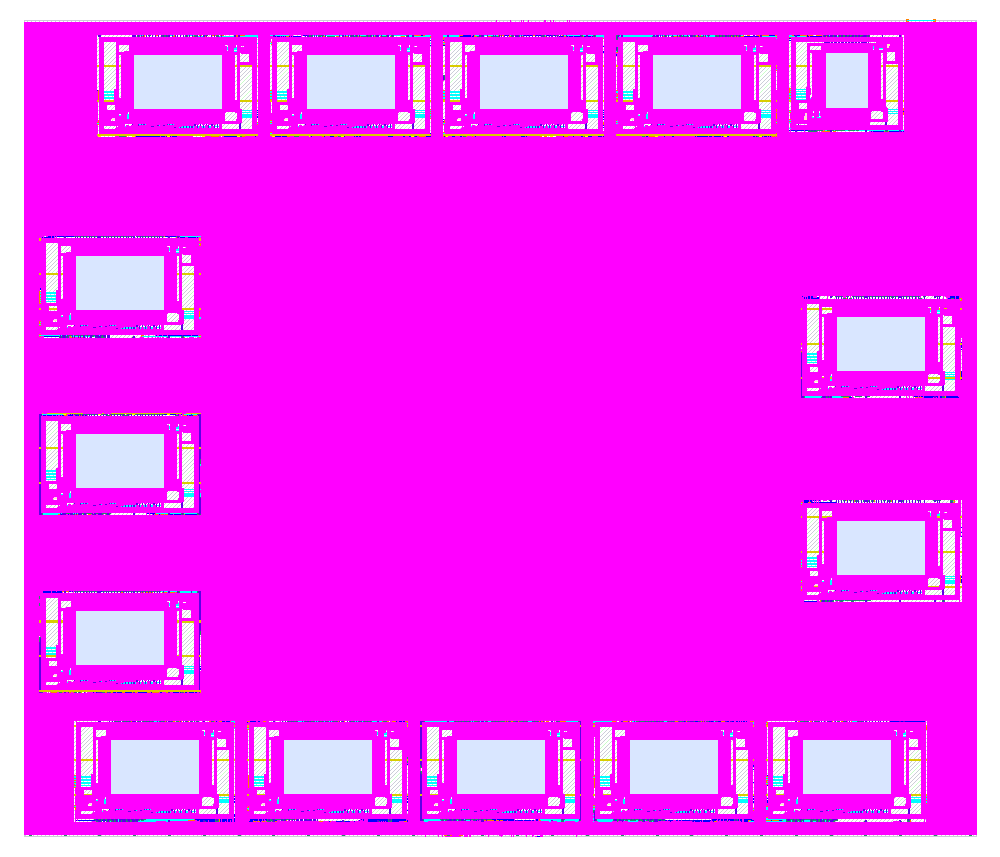
asic/results/images/top_module.png
