YTU-YODA-KYBER/2026_teknofest-mikrodenetleyici-tasarimi/FPGA/main_codes/rtl/desgin_sources/Top_Module/Top_module.sv

module top_module #(
    parameter DATA_WIDTH_boot  = 32,
    parameter ADDR_WIDTH_boot  = 8,                 // 2^8 = 256 kelime, yani 1KB boot ROM
    parameter INIT_FILE_boot   = "boot.hex",
    parameter DATA_WIDTH_instr = 32,
    parameter ADDR_WIDTH_instr = 11,                // 2^11 = 2048 kelime, yani 8KB instruction RAM
    parameter DATA_WIDTH_data  = 32,
    parameter ADDR_WIDTH_data  = 11,                // 2^11 = 2048 kelime, yani 8KB data RAM
    // NOT: Bu degerler sartnamenin bellek sinirlarina gore secilmistir ve
    // ANA PROJEDE degistirilmez. YZ bench senaryosu (yazilim gerceklemesini
    // CPU'da kosturma) 32KB'a ihtiyac duyar; orada bu parametreler
    // yz_bench_test.tcl / yz_bench_test.sv tarafindan DISARIDAN ezilir,
    // RTL'e dokunulmaz. Adres bolgeleri interconnect'te zaten 64KB genis
    // oldugu icin adres cozucude degisiklik gerekmez.
    parameter DATA_WIDTH_yz    = 8,
    // Sartname YZ hizlandiricisinin TOPLAM bellegini 30 KB (30.720 bayt) ile
    // sinirlar. Hizlandiricinin kendi bellekleri 20.816 bayt tuttugu icin
    // (fc_weights_rom_p4 16.000 + conv_buf_ram 4.000 + weights_rom_p8 640 +
    // bias/skor register dizileri 176) girdi RAM'ine kalan pay 9.904 bayttir.
    // Butce tablosu: verification/ai_accel_reports/README.md
    // Model girdisi 1960 bayt oldugu icin fiilen ilk 1960 adres kullanilir.
    parameter ADDR_WIDTH_yz    = 14,                // 9.904'u adresleyen en kucuk genislik
    parameter DEPTH_yz         = 9904,              // girdi RAM derinligi [bayt]


    parameter logic [31:0] boot_addr         = 32'h0000_0000,   //BASLANGIC ADRESI
    parameter logic [31:0] mtvec_addr        = 32'h1F00_0000,   //INTERRUPT GELDIGINDE ISLEMCININ ATLAYACAGI ADRES
    parameter logic [31:0] dm_halt_addr      = 32'h2F00_0000,   //JTAG KULLANILMAK ISTENDIGINDE ISLEMCISNIN ATLAYACAGI ADRES
    parameter logic [31:0] hart_id           = 32'h0000_0000,   //CEKIRDEGIN NUMARASI(TEK CEKIRDEK OLDUGU ICIN DIREKT 0 YAZDIK)
    parameter logic [31:0] dm_exception_addr = 32'h3F00_0000    //JTAG KULLANILIRKEN HATA OLUSULURSA ISLEMCININ ATLAYACAGI ADRES
)(

    input logic clk_i,
    input logic rst_ni,

    input  logic [31:0] GPIO_IDR,
    output logic [31:0] GPIO_ODR,
    output logic [ 7:0] anode,
    output logic [ 7:0] catode,

    // Genel kullanim UART'i: CPU kesme servisinin cikarim sonucunu bastigi
    // arayuz (sartname Bolum 4.2.2 madde 5).
    output logic UART_GU_TX,
    input  logic UART_GU_RX,

    // YZ veri akisi UART'i: host'un 1960 baytlik ses oznitelik vektorunu
    // gonderdigi arayuz. Baytlar DMA ile dogrudan YZ RAM'e yazilir.
    output logic UART_YZ_TX,
    input  logic UART_YZ_RX,

    output logic I2C_SCL,
    inout  logic I2C_SDA,

    output logic QSPI_SCLK,
    output logic QSPI_CS,
    inout  logic QSPI_IO0,
    inout  logic QSPI_IO1,
    inout  logic QSPI_IO2,
    inout  logic QSPI_IO3


);

    //  INSTRUCTION AR PORTLARI
    logic [31:0] cpu_instr_araddr;
    logic        cpu_instr_arvalid;
    logic        cpu_instr_arready;
    //  INSTRUCTION R PORTLARI
    logic        cpu_instr_rready;
    logic [31:0] cpu_instr_rdata;
    logic [ 1:0] cpu_instr_rresp;
    logic        cpu_instr_rvalid;
    //  INSTRUCTION AW PORTLARI
    logic [31:0] cpu_instr_awaddr;
    logic        cpu_instr_awvalid;
    logic        cpu_instr_awready;
    //  INSTRUCTION W PORTLARI
    logic [31:0] cpu_instr_wdata;
    logic        cpu_instr_wvalid;
    logic        cpu_instr_wready;
    //  INSTRUCTION B PORTLARI
    logic        cpu_instr_bready;
    logic [ 1:0] cpu_instr_bresp;
    logic        cpu_instr_bvalid;


    //  DATA AR PORTLARI
    logic [31:0] cpu_data_araddr;
    logic        cpu_data_arvalid;
    logic        cpu_data_arready;
    //  DATA R PORTLARI
    logic        cpu_data_rready;
    logic [31:0] cpu_data_rdata;
    logic [ 1:0] cpu_data_rresp;
    logic        cpu_data_rvalid;
    //  DATA AW PORTLARI
    logic [31:0] cpu_data_awaddr;
    logic        cpu_data_awvalid;
    logic        cpu_data_awready;
    //  DATA W PORTLARI
    logic [31:0] cpu_data_wdata;
    logic [ 3:0] cpu_data_wstrb;
    logic        cpu_data_wvalid;
    logic        cpu_data_wready;
    //  DATA B PORTLARI
    logic        cpu_data_bready;
    logic [ 1:0] cpu_data_bresp;
    logic        cpu_data_bvalid;

    // AW Portları
    logic [31:0] YZ_awaddr;
    logic        YZ_awvalid;
    logic        YZ_awready;
    // W Portları
    logic [31:0] YZ_wdata;
    logic        YZ_wvalid;
    logic        YZ_wready;
    // B Portları
    logic [ 1:0] YZ_bresp;
    logic        YZ_bvalid;
    logic        YZ_bready;
    // AR Portları
    logic [31:0] YZ_araddr;
    logic        YZ_arvalid;
    logic        YZ_arready;
    // R Portları
    logic        YZ_rready;
    logic [31:0] YZ_rdata;
    logic [ 1:0] YZ_rresp;
    logic        YZ_rvalid;

    // AW Portları
    logic [31:0] TIMER_awaddr;
    logic        TIMER_awvalid;
    logic        TIMER_awready;
    // W Portları
    logic [31:0] TIMER_wdata;
    logic        TIMER_wvalid;
    logic        TIMER_wready;
    // B Portları
    logic [ 1:0] TIMER_bresp;
    logic        TIMER_bvalid;
    logic        TIMER_bready;
    // AR Portları
    logic [31:0] TIMER_araddr;
    logic        TIMER_arvalid;
    logic        TIMER_arready;
    // R Portları
    logic        TIMER_rready;
    logic [31:0] TIMER_rdata;
    logic [ 1:0] TIMER_rresp;
    logic        TIMER_rvalid;


    // AW Portları
    logic [31:0] UART_GU_awaddr;
    logic        UART_GU_awvalid;
    logic        UART_GU_awready;
    // W Portları
    logic [31:0] UART_GU_wdata;
    logic        UART_GU_wvalid;
    logic        UART_GU_wready;
    // B Portları
    logic [ 1:0] UART_GU_bresp;
    logic        UART_GU_bvalid;
    logic        UART_GU_bready;
    // AR Portları
    logic [31:0] UART_GU_araddr;
    logic        UART_GU_arvalid;
    logic        UART_GU_arready;
    // R Portları
    logic        UART_GU_rready;
    logic [31:0] UART_GU_rdata;
    logic [ 1:0] UART_GU_rresp;
    logic        UART_GU_rvalid;


    // AW Portları
    logic [31:0] UART_YZ_awaddr;
    logic        UART_YZ_awvalid;
    logic        UART_YZ_awready;
    // W Portları
    logic [31:0] UART_YZ_wdata;
    logic        UART_YZ_wvalid;
    logic        UART_YZ_wready;
    // B Portları
    logic [ 1:0] UART_YZ_bresp;
    logic        UART_YZ_bvalid;
    logic        UART_YZ_bready;
    // AR Portları
    logic [31:0] UART_YZ_araddr;
    logic        UART_YZ_arvalid;
    logic        UART_YZ_arready;
    // R Portları
    logic        UART_YZ_rready;
    logic [31:0] UART_YZ_rdata;
    logic [ 1:0] UART_YZ_rresp;
    logic        UART_YZ_rvalid;


    // WRITE ADDRESS kanalları
    logic [31:0] QSPI_awaddr;
    logic        QSPI_awvalid;
    logic        QSPI_awready;
    // WRITE DATA kanalları
    logic [31:0] QSPI_wdata;
    logic        QSPI_wvalid;
    logic        QSPI_wready;
    // WRITE RESPONSE kanalları
    logic [ 1:0] QSPI_bresp;
    logic        QSPI_bvalid;
    logic        QSPI_bready;
    // READ ADDRESS kanalları
    logic [31:0] QSPI_araddr;
    logic        QSPI_arvalid;
    logic        QSPI_arready;
    // READ DATA kanalları
    logic        QSPI_rready;
    logic [31:0] QSPI_rdata;
    logic [ 1:0] QSPI_rresp;
    logic        QSPI_rvalid;

    // AW Portları
    logic [31:0] I2C_awaddr;
    logic        I2C_awvalid;
    logic        I2C_awready;
    // W Portları
    logic [31:0] I2C_wdata;
    logic        I2C_wvalid;
    logic        I2C_wready;
    // B Portları
    logic [ 1:0] I2C_bresp;
    logic        I2C_bvalid;
    logic        I2C_bready;
    // AR Portları
    logic [31:0] I2C_araddr;
    logic        I2C_arvalid;
    logic        I2C_arready;
    // R Portları
    logic        I2C_rready;
    logic [31:0] I2C_rdata;
    logic [ 1:0] I2C_rresp;
    logic        I2C_rvalid;

    // AW Portları
    logic [31:0] GPIO_awaddr;
    logic        GPIO_awvalid;
    logic        GPIO_awready;
    // W Portları
    logic [31:0] GPIO_wdata;
    logic        GPIO_wvalid;
    logic        GPIO_wready;
    // B Portları
    logic [ 1:0] GPIO_bresp;
    logic        GPIO_bvalid;
    logic        GPIO_bready;
    // AR Portları
    logic [31:0] GPIO_araddr;
    logic        GPIO_arvalid;
    logic        GPIO_arready;
    // R Portları
    logic        GPIO_rready;
    logic [31:0] GPIO_rdata;
    logic [ 1:0] GPIO_rresp;
    logic        GPIO_rvalid;


    logic [31:0] axi_boot_rom_araddr;
    logic        axi_boot_rom_arvalid;
    logic        axi_boot_rom_arready;
    logic [31:0] axi_boot_rom_rdata;
    logic [ 1:0] axi_boot_rom_rresp;
    logic        axi_boot_rom_rvalid;
    logic        axi_boot_rom_rready;

    logic [31:0] axi_boot_rom_interconnect_araddr;
    logic        axi_boot_rom_interconnect_arvalid;
    logic        axi_boot_rom_interconnect_arready;
    logic [31:0] axi_boot_rom_interconnect_rdata;
    logic [ 1:0] axi_boot_rom_interconnect_rresp;
    logic        axi_boot_rom_interconnect_rvalid;
    logic        axi_boot_rom_interconnect_rready;

    logic [31:0] axi_instr_bram_araddr;
    logic        axi_instr_bram_arvalid;
    logic        axi_instr_bram_arready;
    logic [31:0] axi_instr_bram_rdata;
    logic [ 1:0] axi_instr_bram_rresp;
    logic        axi_instr_bram_rvalid;
    logic        axi_instr_bram_rready;

    // CPU data portunun IMEM read kanali (interconnect M8).
    logic [31:0] axi_instr_data_araddr;
    logic        axi_instr_data_arvalid;
    logic        axi_instr_data_arready;
    logic [31:0] axi_instr_data_rdata;
    logic [ 1:0] axi_instr_data_rresp;
    logic        axi_instr_data_rvalid;
    logic        axi_instr_data_rready;

    // Iki read masterindan Instruction RAM denetleyicisine giden kanal.
    logic [31:0] axi_instr_mem_araddr;
    logic        axi_instr_mem_arvalid;
    logic        axi_instr_mem_arready;
    logic [31:0] axi_instr_mem_rdata;
    logic [ 1:0] axi_instr_mem_rresp;
    logic        axi_instr_mem_rvalid;
    logic        axi_instr_mem_rready;

    logic [31:0] axi_instr_bram_awaddr;
    logic        axi_instr_bram_awvalid;
    logic        axi_instr_bram_awready;
    logic [31:0] axi_instr_bram_wdata;
    logic [ 3:0] axi_instr_bram_wstrb;
    logic        axi_instr_bram_wvalid;
    logic        axi_instr_bram_wready;
    logic [ 1:0] axi_instr_bram_bresp;
    logic        axi_instr_bram_bvalid;
    logic        axi_instr_bram_bready;

    logic        boot_dma_valid;
    logic [31:0] boot_dma_data;

    logic        yz_dma_valid;
    logic [ 7:0] yz_dma_data;

    // YZ UART'i kendine ait fiziksel porttur; o hattan gelen her bayt tanim
    // geregi cikarim verisidir, bu yuzden DMA daima aciktir.
    logic        yz_dma_enable;
    assign       yz_dma_enable = 1'b1;

    logic [31:0] axi_data_bram_awaddr;
    logic        axi_data_bram_awvalid;
    logic        axi_data_bram_awready;
    logic [31:0] axi_data_bram_wdata;
    logic [ 3:0] axi_data_bram_wstrb;
    logic        axi_data_bram_wvalid;
    logic        axi_data_bram_wready;
    logic [ 1:0] axi_data_bram_bresp;
    logic        axi_data_bram_bvalid;
    logic        axi_data_bram_bready;
    logic [31:0] axi_data_bram_araddr;
    logic        axi_data_bram_arvalid;
    logic        axi_data_bram_arready;
    logic [31:0] axi_data_bram_rdata;
    logic [ 1:0] axi_data_bram_rresp;
    logic        axi_data_bram_rvalid;
    logic        axi_data_bram_rready;

    logic [ADDR_WIDTH_yz-1:0] yz_bram_raddr;
    logic [ 7:0] yz_bram_rdata;
    logic       acc_start;       // Hızlandırıcının çıkarımı başlat pulse sinyali
    logic       acc_busy;        // Çıkarım işleminin devam ettiğini gösterir
    logic       acc_done;        // Çıkarım bittiğinde pulse olur
    logic       acc_out_wen;     // "Çıkarım sonucu geçerli" mesajı için pulse olur. Bu 1 olduğu zaman satır 40 yapılır
    logic [7:0] acc_out_wdata;   // Güncel çıkarım sonucunu tutar
    logic [127:0] acc_fc_scores; // FC katmanının 4 ham 32-bit akümülatörü
    logic       load_done_irq;   // YZ bellleğine yazma işleminin bittiğini CPU'ya bildirmek için kullanılan interrupt sinyali
    logic       load_clear;      // "cpu_clear_i"ye bağlı, işlemci "load_done_irq" sinyalini gördükten sonra bu sinyal aracılığı ile irq sinyalini temizler
    logic       infer_irq;       // -> irq_i[17]

    logic [31:0] interrupt_i;

    assign interrupt_i = { 14'b0, infer_irq, load_done_irq, 16'b0 };
    //                      [31:18]  [17]        [16]         [15:0]
    
    assign cpu_instr_awready = 1'b0;
    assign cpu_instr_wready  = 1'b0;
    assign cpu_instr_bvalid  = 1'b0;
    assign cpu_instr_bresp   = 2'b00;

conv_accelerator #(
    .RAM_ADDR_W(ADDR_WIDTH_yz)
) conv_accelerator_inst (
    .clk(clk_i),
    .rst_n(rst_ni),
    .start(acc_start),
    .done (acc_done),
    .busy (acc_busy),
    .ram_addr (yz_bram_raddr),
    .ram_rdata(yz_bram_rdata),
    .out_ram_wen  (acc_out_wen),
    .out_ram_wdata(acc_out_wdata),
    .fc_scores_o  (acc_fc_scores)
);

yz_csr_wrapper yz_csr_wrapper_inst (
    .clk(clk_i),
    .rst_n(rst_ni),

    .YZ_awaddr(YZ_awaddr),
    .YZ_awvalid(YZ_awvalid),
    .YZ_awready(YZ_awready),
    .YZ_wdata(YZ_wdata),
    .YZ_wvalid(YZ_wvalid),
    .YZ_wready(YZ_wready),
    .YZ_bresp(YZ_bresp),
    .YZ_bvalid(YZ_bvalid),
    .YZ_bready(YZ_bready),
    .YZ_araddr(YZ_araddr),
    .YZ_arvalid(YZ_arvalid),
    .YZ_arready(YZ_arready),
    .YZ_rready(YZ_rready),
    .YZ_rdata(YZ_rdata),
    .YZ_rresp(YZ_rresp),
    .YZ_rvalid(YZ_rvalid),

    .acc_start(acc_start),
    .acc_busy(acc_busy),
    .acc_done(acc_done),
    .acc_out_wen(acc_out_wen),
    .acc_out_wdata(acc_out_wdata),
    .acc_fc_scores(acc_fc_scores),
    .load_done_irq(load_done_irq),
    .load_clear(load_clear),
    .infer_irq(infer_irq)
);

boot_rom_axi_ctrl #(
    .DATA_WIDTH(DATA_WIDTH_boot),
    .ADDR_WIDTH(ADDR_WIDTH_boot),
    .INIT_FILE(INIT_FILE_boot)
) boot_rom_ctrl_inst(
    .clk_i(clk_i),
    .rst_n(rst_ni),

    .axi_boot_rom_araddr (axi_boot_rom_araddr),
    .axi_boot_rom_arvalid(axi_boot_rom_arvalid),
    .axi_boot_rom_arready(axi_boot_rom_arready),

    .axi_boot_rom_rdata (axi_boot_rom_rdata),
    .axi_boot_rom_rresp (axi_boot_rom_rresp),
    .axi_boot_rom_rvalid(axi_boot_rom_rvalid),
    .axi_boot_rom_rready(axi_boot_rom_rready),

    .axi_boot_rom_interconnect_araddr (axi_boot_rom_interconnect_araddr),
    .axi_boot_rom_interconnect_arvalid(axi_boot_rom_interconnect_arvalid),
    .axi_boot_rom_interconnect_arready(axi_boot_rom_interconnect_arready),
    .axi_boot_rom_interconnect_rdata  (axi_boot_rom_interconnect_rdata),
    .axi_boot_rom_interconnect_rresp  (axi_boot_rom_interconnect_rresp),
    .axi_boot_rom_interconnect_rvalid (axi_boot_rom_interconnect_rvalid),
    .axi_boot_rom_interconnect_rready (axi_boot_rom_interconnect_rready)
);

// Instruction fetch ve data load tek IMEM AXI read portunu paylasir.
axi_read_arbiter2 instr_read_arbiter_inst (
    .clk_i(clk_i), .rst_ni(rst_ni),
    .m0_araddr(axi_instr_bram_araddr),
    .m0_arvalid(axi_instr_bram_arvalid),
    .m0_arready(axi_instr_bram_arready),
    .m0_rdata(axi_instr_bram_rdata),
    .m0_rresp(axi_instr_bram_rresp),
    .m0_rvalid(axi_instr_bram_rvalid),
    .m0_rready(axi_instr_bram_rready),
    .m1_araddr(axi_instr_data_araddr),
    .m1_arvalid(axi_instr_data_arvalid),
    .m1_arready(axi_instr_data_arready),
    .m1_rdata(axi_instr_data_rdata),
    .m1_rresp(axi_instr_data_rresp),
    .m1_rvalid(axi_instr_data_rvalid),
    .m1_rready(axi_instr_data_rready),
    .s_araddr(axi_instr_mem_araddr),
    .s_arvalid(axi_instr_mem_arvalid),
    .s_arready(axi_instr_mem_arready),
    .s_rdata(axi_instr_mem_rdata),
    .s_rresp(axi_instr_mem_rresp),
    .s_rvalid(axi_instr_mem_rvalid),
    .s_rready(axi_instr_mem_rready)
);

instr_bram_axi_ctrl #(
    .DATA_WIDTH(DATA_WIDTH_instr),
    .ADDR_WIDTH(ADDR_WIDTH_instr)
) instr_bram_ctrl_inst(
    .clk_i(clk_i),
    .rst_n(rst_ni),

    .axi_instr_bram_araddr (axi_instr_mem_araddr),
    .axi_instr_bram_arvalid(axi_instr_mem_arvalid),
    .axi_instr_bram_arready(axi_instr_mem_arready),

    .axi_instr_bram_rdata  (axi_instr_mem_rdata),
    .axi_instr_bram_rresp  (axi_instr_mem_rresp),
    .axi_instr_bram_rvalid (axi_instr_mem_rvalid),
    .axi_instr_bram_rready (axi_instr_mem_rready),

    .axi_instr_bram_awaddr (axi_instr_bram_awaddr),
    .axi_instr_bram_awvalid(axi_instr_bram_awvalid),
    .axi_instr_bram_awready(axi_instr_bram_awready),

    .axi_instr_bram_wdata  (axi_instr_bram_wdata),
    .axi_instr_bram_wstrb  (axi_instr_bram_wstrb),
    .axi_instr_bram_wvalid (axi_instr_bram_wvalid),
    .axi_instr_bram_wready (axi_instr_bram_wready),

    .axi_instr_bram_bresp  (axi_instr_bram_bresp),
    .axi_instr_bram_bvalid (axi_instr_bram_bvalid),
    .axi_instr_bram_bready (axi_instr_bram_bready),

    .dma_valid_i(boot_dma_valid),
    .dma_data_i (boot_dma_data)
);

yz_acclrtr_bram_axi_ctrl #(
    .DATA_WIDTH(DATA_WIDTH_yz),
    .ADDR_WIDTH(ADDR_WIDTH_yz),
    .DEPTH     (DEPTH_yz)
) yz_bram_ctrl_inst(
    .clk_i(clk_i),
    .rst_n(rst_ni),

    .yz_bram_raddr(yz_bram_raddr),
    .yz_bram_rdata(yz_bram_rdata),

    .dma_valid_i(yz_dma_valid),
    .dma_data_i (yz_dma_data),

    .cpu_clear_i  (load_clear),
    .load_done_irq(load_done_irq)
);

data_bram_axi_ctrl #(
    .DATA_WIDTH(DATA_WIDTH_data),
    .ADDR_WIDTH(ADDR_WIDTH_data)
) data_bram_ctrl_inst(
    .clk_i (clk_i),
    .rst_n(rst_ni),

    .axi_data_bram_araddr (axi_data_bram_araddr),
    .axi_data_bram_arvalid(axi_data_bram_arvalid),
    .axi_data_bram_arready(axi_data_bram_arready),

    .axi_data_bram_rdata  (axi_data_bram_rdata),
    .axi_data_bram_rresp  (axi_data_bram_rresp),
    .axi_data_bram_rvalid (axi_data_bram_rvalid),
    .axi_data_bram_rready (axi_data_bram_rready),

    .axi_data_bram_awaddr (axi_data_bram_awaddr),
    .axi_data_bram_awvalid(axi_data_bram_awvalid),
    .axi_data_bram_awready(axi_data_bram_awready),

    .axi_data_bram_wdata  (axi_data_bram_wdata),
    .axi_data_bram_wstrb  (axi_data_bram_wstrb),
    .axi_data_bram_wvalid (axi_data_bram_wvalid),
    .axi_data_bram_wready (axi_data_bram_wready),

    .axi_data_bram_bresp  (axi_data_bram_bresp),
    .axi_data_bram_bvalid (axi_data_bram_bvalid),
    .axi_data_bram_bready (axi_data_bram_bready)
);

cv32e40p_obi_to_axi_wrapper #(
    .boot_addr        (boot_addr),
    .mtvec_addr       (mtvec_addr),
    .dm_halt_addr     (dm_halt_addr),
    .hart_id          (hart_id),
    .dm_exception_addr(dm_exception_addr)

)cpu_inst(

    .clk_i (clk_i),
    .rst_ni(rst_ni),

    // INTERRUPT PORTLARI
    .interrupt_i  (interrupt_i),
    .interrupt_ack(),
    .interrupt_id (),

    //  INSTRUCTION AW PORTLARI
    .axi_instr_awaddr (cpu_instr_awaddr),
    .axi_instr_awvalid(cpu_instr_awvalid),
    .axi_instr_awready(cpu_instr_awready),
    //  INSTRUCTION W PORTLARI
    .axi_instr_wdata  (cpu_instr_wdata),
    .axi_instr_wvalid (cpu_instr_wvalid),
    .axi_instr_wready (cpu_instr_wready),
    //  INSTRUCTION B PORTLARI
    .axi_instr_bresp  (cpu_instr_bresp),
    .axi_instr_bvalid (cpu_instr_bvalid),
    .axi_instr_bready (cpu_instr_bready),
    //  INSTRUCTION AR PORTLARI
    .axi_instr_araddr (cpu_instr_araddr),
    .axi_instr_arvalid(cpu_instr_arvalid),
    .axi_instr_arready(cpu_instr_arready),
    //  INSTRUCTION R PORTLARI
    .axi_instr_rready (cpu_instr_rready),
    .axi_instr_rdata  (cpu_instr_rdata),
    .axi_instr_rresp  (cpu_instr_rresp),
    .axi_instr_rvalid (cpu_instr_rvalid),

    //  DATA AW PORTLARI
    .axi_data_awaddr  (cpu_data_awaddr),
    .axi_data_awvalid (cpu_data_awvalid),
    .axi_data_awready (cpu_data_awready),
    //  DATA W PORTLARI
    .axi_data_wdata   (cpu_data_wdata),
    .axi_data_wstrb   (cpu_data_wstrb),
    .axi_data_wvalid  (cpu_data_wvalid),
    .axi_data_wready  (cpu_data_wready),
    //  DATA B PORTLARI
    .axi_data_bresp   (cpu_data_bresp),
    .axi_data_bvalid  (cpu_data_bvalid),
    .axi_data_bready  (cpu_data_bready),
    //  DATA AR PORTLARI
    .axi_data_araddr  (cpu_data_araddr),
    .axi_data_arvalid (cpu_data_arvalid),
    .axi_data_arready (cpu_data_arready),
    //  DATA R PORTLARI
    .axi_data_rready  (cpu_data_rready),
    .axi_data_rdata   (cpu_data_rdata),
    .axi_data_rresp   (cpu_data_rresp),
    .axi_data_rvalid  (cpu_data_rvalid)

);
AXI4_Interconnect interconnect_inst(

    .clk_i(clk_i),
    .rst_ni(rst_ni),

    // ==============================================================
    // SLAVE 0: CPU DATA PORTLARI (AXI4)
    // ==============================================================
    .axi_s0_awaddr (cpu_data_awaddr),
    .axi_s0_awvalid(cpu_data_awvalid),
    .axi_s0_awready(cpu_data_awready),
    .axi_s0_wdata  (cpu_data_wdata),
    .axi_s0_wstrb  (cpu_data_wstrb),
    .axi_s0_wvalid (cpu_data_wvalid),
    .axi_s0_wready (cpu_data_wready),
    .axi_s0_bresp  (cpu_data_bresp),
    .axi_s0_bvalid (cpu_data_bvalid),
    .axi_s0_bready (cpu_data_bready),
    .axi_s0_araddr (cpu_data_araddr),
    .axi_s0_arvalid(cpu_data_arvalid),
    .axi_s0_arready(cpu_data_arready),
    .axi_s0_rdata  (cpu_data_rdata),
    .axi_s0_rresp  (cpu_data_rresp),
    .axi_s0_rvalid (cpu_data_rvalid),
    .axi_s0_rready (cpu_data_rready),

    // ==============================================================
    // MASTER 0: TIMER PORTLARI (AXI4-Lite) - Base: 0x4000_0000
    // ==============================================================
    .axi_m0_awaddr (TIMER_awaddr),
    .axi_m0_awvalid(TIMER_awvalid),
    .axi_m0_awready(TIMER_awready),
    .axi_m0_wdata  (TIMER_wdata),
    .axi_m0_wvalid (TIMER_wvalid),
    .axi_m0_wready (TIMER_wready),
    .axi_m0_bresp  (TIMER_bresp),
    .axi_m0_bvalid (TIMER_bvalid),
    .axi_m0_bready (TIMER_bready),
    .axi_m0_araddr (TIMER_araddr),
    .axi_m0_arvalid(TIMER_arvalid),
    .axi_m0_arready(TIMER_arready),
    .axi_m0_rdata  (TIMER_rdata),
    .axi_m0_rresp  (TIMER_rresp),
    .axi_m0_rvalid (TIMER_rvalid),
    .axi_m0_rready (TIMER_rready),

    // ==============================================================
    // MASTER 1: GPIO PORTLARI (AXI4-Lite) - Base: 0x4001_0000
    // ==============================================================
    .axi_m1_awaddr (GPIO_awaddr),
    .axi_m1_awvalid(GPIO_awvalid),
    .axi_m1_awready(GPIO_awready),
    .axi_m1_wdata  (GPIO_wdata),
    .axi_m1_wvalid (GPIO_wvalid),
    .axi_m1_wready (GPIO_wready),
    .axi_m1_bresp  (GPIO_bresp),
    .axi_m1_bvalid (GPIO_bvalid),
    .axi_m1_bready (GPIO_bready),
    .axi_m1_araddr (GPIO_araddr),
    .axi_m1_arvalid(GPIO_arvalid),
    .axi_m1_arready(GPIO_arready),
    .axi_m1_rdata  (GPIO_rdata),
    .axi_m1_rresp  (GPIO_rresp),
    .axi_m1_rvalid (GPIO_rvalid),
    .axi_m1_rready (GPIO_rready),

    // ==============================================================
    // MASTER 2: I2C PORTLARI (AXI4-Lite) - Base: 0x4002_0000
    // ==============================================================
    .axi_m2_awaddr (I2C_awaddr),
    .axi_m2_awvalid(I2C_awvalid),
    .axi_m2_awready(I2C_awready),
    .axi_m2_wdata  (I2C_wdata),
    .axi_m2_wvalid (I2C_wvalid),
    .axi_m2_wready (I2C_wready),
    .axi_m2_bresp  (I2C_bresp),
    .axi_m2_bvalid (I2C_bvalid),
    .axi_m2_bready (I2C_bready),
    .axi_m2_araddr (I2C_araddr),
    .axi_m2_arvalid(I2C_arvalid),
    .axi_m2_arready(I2C_arready),
    .axi_m2_rdata  (I2C_rdata),
    .axi_m2_rresp  (I2C_rresp),
    .axi_m2_rvalid (I2C_rvalid),
    .axi_m2_rready (I2C_rready),

    // ==============================================================
    // MASTER 3: QSPI PORTLARI (AXI4-Lite) - Base: 0x4003_0000
    // ==============================================================
    .axi_m3_awaddr (QSPI_awaddr),
    .axi_m3_awvalid(QSPI_awvalid),
    .axi_m3_awready(QSPI_awready),
    .axi_m3_wdata  (QSPI_wdata),
    .axi_m3_wvalid (QSPI_wvalid),
    .axi_m3_wready (QSPI_wready),
    .axi_m3_bresp  (QSPI_bresp),
    .axi_m3_bvalid (QSPI_bvalid),
    .axi_m3_bready (QSPI_bready),
    .axi_m3_araddr (QSPI_araddr),
    .axi_m3_arvalid(QSPI_arvalid),
    .axi_m3_arready(QSPI_arready),
    .axi_m3_rdata  (QSPI_rdata),
    .axi_m3_rresp  (QSPI_rresp),
    .axi_m3_rvalid (QSPI_rvalid),
    .axi_m3_rready (QSPI_rready),

    // ==============================================================
    // MASTER 4: UART PORTLARI (AXI4-Lite) - Base: 0x4004_0000
    // ==============================================================
    .axi_m4_awaddr (UART_GU_awaddr),
    .axi_m4_awvalid(UART_GU_awvalid),
    .axi_m4_awready(UART_GU_awready),
    .axi_m4_wdata  (UART_GU_wdata),
    .axi_m4_wvalid (UART_GU_wvalid),
    .axi_m4_wready (UART_GU_wready),
    .axi_m4_bresp  (UART_GU_bresp),
    .axi_m4_bvalid (UART_GU_bvalid),
    .axi_m4_bready (UART_GU_bready),
    .axi_m4_araddr (UART_GU_araddr),
    .axi_m4_arvalid(UART_GU_arvalid),
    .axi_m4_arready(UART_GU_arready),
    .axi_m4_rdata  (UART_GU_rdata),
    .axi_m4_rresp  (UART_GU_rresp),
    .axi_m4_rvalid (UART_GU_rvalid),
    .axi_m4_rready (UART_GU_rready),

    // ==============================================================================
    // MASTER 5: UART (YZ HIZLANDIRICI) PORTLARI (AXI4-Lite) - Base: 0x4005_0000
    // ==============================================================================
    .axi_m5_awaddr (UART_YZ_awaddr),
    .axi_m5_awvalid(UART_YZ_awvalid),
    .axi_m5_awready(UART_YZ_awready),
    .axi_m5_wdata  (UART_YZ_wdata),
    .axi_m5_wvalid (UART_YZ_wvalid),
    .axi_m5_wready (UART_YZ_wready),
    .axi_m5_bresp  (UART_YZ_bresp),
    .axi_m5_bvalid (UART_YZ_bvalid),
    .axi_m5_bready (UART_YZ_bready),
    .axi_m5_araddr (UART_YZ_araddr),
    .axi_m5_arvalid(UART_YZ_arvalid),
    .axi_m5_arready(UART_YZ_arready),
    .axi_m5_rdata  (UART_YZ_rdata),
    .axi_m5_rresp  (UART_YZ_rresp),
    .axi_m5_rvalid (UART_YZ_rvalid),
    .axi_m5_rready (UART_YZ_rready),

    // ======================================================================
    // MASTER 6: YZ HIZLANDIRICI PORTLARI (AXI4-Lite) - Base: 0x4006_0000
    // ======================================================================
    .axi_m6_awaddr (YZ_awaddr),
    .axi_m6_awvalid(YZ_awvalid),
    .axi_m6_awready(YZ_awready),
    .axi_m6_wdata  (YZ_wdata),
    .axi_m6_wvalid (YZ_wvalid),
    .axi_m6_wready (YZ_wready),
    .axi_m6_bresp  (YZ_bresp),
    .axi_m6_bvalid (YZ_bvalid),
    .axi_m6_bready (YZ_bready),
    .axi_m6_araddr (YZ_araddr),
    .axi_m6_arvalid(YZ_arvalid),
    .axi_m6_arready(YZ_arready),
    .axi_m6_rdata  (YZ_rdata),
    .axi_m6_rresp  (YZ_rresp),
    .axi_m6_rvalid (YZ_rvalid),
    .axi_m6_rready (YZ_rready),

    // ==============================================================
    // MASTER 7: DATA RAM PORTLARI (AXI4-Lite) - Base: 0x2000_0000
    // ==============================================================
    .axi_m7_awaddr (axi_data_bram_awaddr),
    .axi_m7_awvalid(axi_data_bram_awvalid),
    .axi_m7_awready(axi_data_bram_awready),
    .axi_m7_wdata  (axi_data_bram_wdata),
    .axi_m7_wstrb  (axi_data_bram_wstrb),
    .axi_m7_wvalid (axi_data_bram_wvalid),
    .axi_m7_wready (axi_data_bram_wready),
    .axi_m7_bresp  (axi_data_bram_bresp),
    .axi_m7_bvalid (axi_data_bram_bvalid),
    .axi_m7_bready (axi_data_bram_bready),
    .axi_m7_araddr (axi_data_bram_araddr),
    .axi_m7_arvalid(axi_data_bram_arvalid),
    .axi_m7_arready(axi_data_bram_arready),
    .axi_m7_rdata  (axi_data_bram_rdata),
    .axi_m7_rresp  (axi_data_bram_rresp),
    .axi_m7_rvalid (axi_data_bram_rvalid),
    .axi_m7_rready (axi_data_bram_rready),

    // ==============================================================
    // MASTER 8: INSTRUCTION RAM PORTLARI (AXI4-Lite) - Base: 0x0000_0000
    // ==============================================================
    .axi_m8_awaddr (axi_instr_bram_awaddr),
    .axi_m8_awvalid(axi_instr_bram_awvalid),
    .axi_m8_awready(axi_instr_bram_awready),
    .axi_m8_wdata  (axi_instr_bram_wdata),
    .axi_m8_wstrb  (axi_instr_bram_wstrb),
    .axi_m8_wvalid (axi_instr_bram_wvalid),
    .axi_m8_wready (axi_instr_bram_wready),
    .axi_m8_bresp  (axi_instr_bram_bresp),
    .axi_m8_bvalid (axi_instr_bram_bvalid),
    .axi_m8_bready (axi_instr_bram_bready),
    .axi_m8_araddr (axi_instr_data_araddr),
    .axi_m8_arvalid(axi_instr_data_arvalid),
    .axi_m8_arready(axi_instr_data_arready),
    .axi_m8_rdata  (axi_instr_data_rdata),
    .axi_m8_rresp  (axi_instr_data_rresp),
    .axi_m8_rvalid (axi_instr_data_rvalid),
    .axi_m8_rready (axi_instr_data_rready),

    // ==============================================================
    // MASTER 9: BOOT RAM PORTLARI (AXI4-Lite) - Base: 0x0000_0000
    // ==============================================================
    .axi_m9_araddr (axi_boot_rom_interconnect_araddr),
    .axi_m9_arvalid(axi_boot_rom_interconnect_arvalid),
    .axi_m9_arready(axi_boot_rom_interconnect_arready),
    .axi_m9_rdata  (axi_boot_rom_interconnect_rdata),
    .axi_m9_rresp  (axi_boot_rom_interconnect_rresp),
    .axi_m9_rvalid (axi_boot_rom_interconnect_rvalid),
    .axi_m9_rready (axi_boot_rom_interconnect_rready)

);

Timer_AXI4_Lite timer_inst(

    .clk_i(clk_i),
    .rst_n(rst_ni),

    .awaddr (TIMER_awaddr),
    .awvalid(TIMER_awvalid),
    .awready(TIMER_awready),
    .wdata  (TIMER_wdata),
    .wvalid (TIMER_wvalid),
    .wready (TIMER_wready),
    .bresp  (TIMER_bresp),
    .bvalid (TIMER_bvalid),
    .bready (TIMER_bready),
    .araddr (TIMER_araddr),
    .arvalid(TIMER_arvalid),
    .arready(TIMER_arready),
    .rready (TIMER_rready),
    .rdata  (TIMER_rdata),
    .rresp  (TIMER_rresp),
    .rvalid (TIMER_rvalid)
);

UART_GU_AXI4_Lite uart_gu_inst(
    .clk(clk_i),
    .rst_n(rst_ni),

    .awaddr (UART_GU_awaddr),
    .awvalid(UART_GU_awvalid),
    .awready(UART_GU_awready),
    .wdata  (UART_GU_wdata),
    .wvalid (UART_GU_wvalid),
    .wready (UART_GU_wready),
    .bresp  (UART_GU_bresp),
    .bvalid (UART_GU_bvalid),
    .bready (UART_GU_bready),
    .araddr (UART_GU_araddr),
    .arvalid(UART_GU_arvalid),
    .arready(UART_GU_arready),
    .rready (UART_GU_rready),
    .rdata  (UART_GU_rdata),
    .rresp  (UART_GU_rresp),
    .rvalid (UART_GU_rvalid),

    // UART Portları
    .rx(UART_GU_RX),
    .tx(UART_GU_TX)
);

UART_YZ_AXI4_Lite uart_yz_inst(
    .clk(clk_i),
    .rst_n(rst_ni),

    .awaddr (UART_YZ_awaddr),
    .awvalid(UART_YZ_awvalid),
    .awready(UART_YZ_awready),
    .wdata  (UART_YZ_wdata),
    .wvalid (UART_YZ_wvalid),
    .wready (UART_YZ_wready),
    .bresp  (UART_YZ_bresp),
    .bvalid (UART_YZ_bvalid),
    .bready (UART_YZ_bready),
    .araddr (UART_YZ_araddr),
    .arvalid(UART_YZ_arvalid),
    .arready(UART_YZ_arready),
    .rready (UART_YZ_rready),
    .rdata  (UART_YZ_rdata),
    .rresp  (UART_YZ_rresp),
    .rvalid (UART_YZ_rvalid),

    // UART Portları
    .rx(UART_YZ_RX),
    .tx(UART_YZ_TX),

    .dma_enable_i(yz_dma_enable),
    .dma_data_o  (yz_dma_data),
    .dma_valid_o (yz_dma_valid)
);

I2C_Master_AXI4_Lite i2c_master_inst(
    .clk_i(clk_i),
    .rst_n(rst_ni),

    .awaddr (I2C_awaddr),
    .awvalid(I2C_awvalid),
    .awready(I2C_awready),
    .wdata  (I2C_wdata),
    .wvalid (I2C_wvalid),
    .wready (I2C_wready),
    .bresp  (I2C_bresp),
    .bvalid (I2C_bvalid),
    .bready (I2C_bready),
    .araddr (I2C_araddr),
    .arvalid(I2C_arvalid),
    .arready(I2C_arready),
    .rready (I2C_rready),
    .rdata  (I2C_rdata),
    .rresp  (I2C_rresp),
    .rvalid (I2C_rvalid),

    // I/O Portları
    .I2C_SCL(I2C_SCL),
    .I2C_SDA(I2C_SDA)
);


GPIO_AXI4_Lite gpio_inst(
    .clk_i(clk_i),
    .rst_n(rst_ni),

    .awaddr (GPIO_awaddr),
    .awvalid(GPIO_awvalid),
    .awready(GPIO_awready),
    .wdata  (GPIO_wdata),
    .wvalid (GPIO_wvalid),
    .wready (GPIO_wready),
    .bresp  (GPIO_bresp),
    .bvalid (GPIO_bvalid),
    .bready (GPIO_bready),
    .araddr (GPIO_araddr),
    .arvalid(GPIO_arvalid),
    .arready(GPIO_arready),
    .rready (GPIO_rready),
    .rdata  (GPIO_rdata),
    .rresp  (GPIO_rresp),
    .rvalid (GPIO_rvalid),

    // I/O Portları
    .GPIO_IDR(GPIO_IDR),
    .GPIO_ODR(GPIO_ODR),

    .anode (anode),
    .catode(catode)
);

QSPI_Master_AXI4_Lite qspi_master_inst(
    .clk_i(clk_i),
    .rst_n(rst_ni),

    .awaddr (QSPI_awaddr),
    .awvalid(QSPI_awvalid),
    .awready(QSPI_awready),
    .wdata  (QSPI_wdata),
    .wvalid (QSPI_wvalid),
    .wready (QSPI_wready),
    .bresp  (QSPI_bresp),
    .bvalid (QSPI_bvalid),
    .bready (QSPI_bready),
    .araddr (QSPI_araddr),
    .arvalid(QSPI_arvalid),
    .arready(QSPI_arready),
    .rready (QSPI_rready),
    .rdata  (QSPI_rdata),
    .rresp  (QSPI_rresp),
    .rvalid (QSPI_rvalid),

    // QSPI Portları
    .QSPI_SCLK(QSPI_SCLK),
    .QSPI_CS  (QSPI_CS),
    .QSPI_IO0 (QSPI_IO0),
    .QSPI_IO1 (QSPI_IO1),
    .QSPI_IO2 (QSPI_IO2),
    .QSPI_IO3 (QSPI_IO3),

    .dma_data (boot_dma_data),
    .dma_valid(boot_dma_valid)
);


Instr_Splitter instr_splitter_inst(
    // ==========================
    //  GİRİŞ PORTLARI
    // ==========================
    .axi_araddr (cpu_instr_araddr),
    .axi_arvalid(cpu_instr_arvalid),
    .axi_arready(cpu_instr_arready),
    .axi_rready (cpu_instr_rready),
    .axi_rdata  (cpu_instr_rdata),
    .axi_rresp  (cpu_instr_rresp),
    .axi_rvalid (cpu_instr_rvalid),

    // =========================
    // INSTRUCTION RAM PORTLARI
    // =========================
    .i_araddr (axi_instr_bram_araddr),
    .i_arvalid(axi_instr_bram_arvalid),
    .i_arready(axi_instr_bram_arready),
    .i_rready (axi_instr_bram_rready),
    .i_rdata  (axi_instr_bram_rdata),
    .i_rresp  (axi_instr_bram_rresp),
    .i_rvalid (axi_instr_bram_rvalid),

    // =========================
    // BOOT RAM PORTLARI
    // =========================
    .b_araddr (axi_boot_rom_araddr),
    .b_arvalid(axi_boot_rom_arvalid),
    .b_arready(axi_boot_rom_arready),
    .b_rready (axi_boot_rom_rready),
    .b_rdata  (axi_boot_rom_rdata),
    .b_rresp  (axi_boot_rom_rresp),
    .b_rvalid (axi_boot_rom_rvalid)
);


endmodule
