YTU-YODA-KYBER/2026_teknofest-mikrodenetleyici-tasarimi/asic_rtl/patched/QSPI_Master_AXI4_Lite_asic.sv

// ===========================================================================
//  OTOMATIK URETILMIS YAMALI KOPYA -- ELLE DUZENLEME
//
//  Ureten : asic/scripts/patch_rtl.py
//  Kaynak : main_codes/rtl/desgin_sources/Peripherals/QSPI/QSPI_Master_AXI4_Lite.sv
//  SHA256 : cbd8870ce1617c25cd7e8bdfad596b2eb6de9cbb7d594feb74e228d83cfadcf4
//
//  Orijinal dosyaya DOKUNULMAMISTIR. ASIC akisi (asic/filelist.f) orijinalin
//  yerine bu kopyayi kullanir; FPGA/Vivado akisi orijinali kullanmaya devam eder.
//
//  YAPILAN DEGISIKLIK: AXI4-Lite yanit kodlari (RRESP/BRESP) yalnizca reset dalinda 0 atanmisti,
//    baska hicbir yerde atanmadigi icin cikislar SURULMEYEN sinyal olarak
//    kaliyordu. Reset atamalari kaldirilip yerine surekli atama konuldu:
//    deger her zaman 2'b00 (OKAY) -- yani davranis birebir aynidir, ama
//    artik cikisin acik bir surucusu var.
// ===========================================================================


    //==========================================================================
    //    AXI4-Lite arayüzü üzerinden kontrol edilebilen QSPI Master modülü.
    //==========================================================================
    //
    // Bu QSPI modülünün desteklediği bazı komutlar ve açıklamaları:
    // -------------|------------------|-----------------------------------------------
    //  Komut Adı   | Komut Kodu (Hex) | Komut Açıklaması
    // -------------|------------------|-----------------------------------------------
    //  WREN        = 0x06 = 00000110   // Yazma İzni Ver (Write Enable)
    //  WRDI        = 0x04 = 00000100   // Yazma İznini Kaldır (Write Disable)
    //  READ        = 0x03 = 00000011   // Standart Okuma (x1 Modu)
    //  DOR         = 0x3B = 00111011   // Dual Output Fast Read (x2 Modu)
    //  QOR         = 0x6B = 01101011   // Quad Output Fast Read (x4 Modu)
    //  PP          = 0x02 = 00000010   // Sayfa Programlama (Page Program - x1)
    //  QPP         = 0x32 = 00110010   // Dörtlü Sayfa Programlama (Quad Page Program - x4)
    //  SE(4KB)     = 0x20 = 00100000   // Subsektör Silme (Sector Erase - 4KB)
    //  SE(64KB)    = 0xD8 = 11011000   // Sektör silme (Subsector Erase - 64KB)
    //  RDID        = 0x9F = 10011111   // JEDEC Tanımlama Bilgisini Oku
    //  READ_ID     = 0x9E = 10011110   // Cihaz Kimliğini Oku (Read ID)
    //  RES         = 0xAB = 10101011   // Elektronik İmzayı Oku (Read Electronic Signature)
    //  RDSR1       = 0x05 = 00000101   // Durum Yazmacı-1'i Oku (Read Status logicister)
    //  RDSR2       = 0x70 = 01110000   // Flag Durum Yazmacını Oku (Read Flag Status logicister)
    //  RDCR        = 0xB5 = 10110101   // Konfigürasyon Yazmacını Oku (Read Nonvolatile Configuration)
    //  WRR         = 0x01 = 00000001   // Yazmaçları Güncelle (Write Status logicister)
    //  CLSR        = 0x50 = 01010000   // Flag Durum Yazmacını Temizle (Clear Flag Status logicister)
    //  RESET_en    = 0x66 = 01100110   // Reset Enable
    //  RESET_mem   = 0x99 = 10011001   // Reset Memory

module QSPI_Master_AXI4_Lite(

    // clock ve reset sinyalleri
    input logic clk_i,
    input logic rst_n,

    // WRITE ADDRESS kanalları
    input  logic [31:0] awaddr,
    input  logic        awvalid,
    output logic        awready,

    // WRITE DATA kanalları
    input  logic [31:0] wdata,
    input  logic        wvalid,
    output logic        wready,

    // WRITE RESPONSE kanalları
    output logic [ 1:0] bresp,
    output logic        bvalid,
    input  logic        bready,

    // READ ADDRESS kanalları
    input  logic [31:0] araddr,
    input  logic        arvalid,
    output logic        arready,

    // READ DATA kanalları
    input  logic        rready,
    output logic [31:0] rdata,
    output logic [ 1:0] rresp,
    output logic        rvalid,


    output logic QSPI_SCLK,
    output logic QSPI_CS,

    inout  logic QSPI_IO0,
    inout  logic QSPI_IO1,
    inout  logic QSPI_IO2,
    inout  logic QSPI_IO3,

    output logic [31:0] dma_data,
    output logic        dma_valid

    );

    // I/O Portları
    wire QSPI_IO0_out;
    wire QSPI_IO0_oe;
    wire QSPI_IO0_in;

    wire QSPI_IO1_out;
    wire QSPI_IO1_oe;
    wire QSPI_IO1_in;

    wire QSPI_IO2_out;
    wire QSPI_IO2_oe;
    wire QSPI_IO2_in;

    wire QSPI_IO3_out;
    wire QSPI_IO3_oe;
    wire QSPI_IO3_in;

    IOBUF IOBUF_QSPI_IO0 (.I(QSPI_IO0_out), .T(~QSPI_IO0_oe), .O(QSPI_IO0_in), .IO(QSPI_IO0));
    IOBUF IOBUF_QSPI_IO1 (.I(QSPI_IO1_out), .T(~QSPI_IO1_oe), .O(QSPI_IO1_in), .IO(QSPI_IO1));
    IOBUF IOBUF_QSPI_IO2 (.I(QSPI_IO2_out), .T(~QSPI_IO2_oe), .O(QSPI_IO2_in), .IO(QSPI_IO2));
    IOBUF IOBUF_QSPI_IO3 (.I(QSPI_IO3_out), .T(~QSPI_IO3_oe), .O(QSPI_IO3_in), .IO(QSPI_IO3));


    logic [31:0] QSPI_CCR;
    logic [31:0] QSPI_ADR;
    logic [31:0] QSPI_DR;
    logic [31:0] QSPI_STA;
    logic [31:0] QSPI_FCR;

    // LUTRAM kullanıyoruz
    (* ram_style = "distributed" *) logic [31:0] FIFO_TX [0:63];
    (* ram_style = "distributed" *) logic [31:0] FIFO_RX [0:63];

    logic [31:0] fifo_tx_rdata; // TX FIFO'dan okunan veriyi tutar.
    logic [ 6:0] fifo_tx_cnt;   // TX FIFO'nun güncel doluluk sayısını tutar.
    logic [ 5:0] tx_wr_ptr;     // TX FIFO'ya yazacağı yeri gösterir.
    logic [ 5:0] tx_rd_ptr;     // TX FIFO'ya yazılacak yeri gösterir.

    logic [31:0] fifo_rx_rdata; // RX FIFO'dan okunan veriyi tutar.
    logic [31:0] fifo_rx_wdata; // RX FIFO'ya yazılacak veriyi tutar.
    logic [ 6:0] fifo_rx_cnt;   // RX FIFO'nun güncel doluluk sayısını tutar.
    logic [ 5:0] rx_wr_ptr;     // RX FIFO'ya yazacağı yeri gösterir.
    logic [ 5:0] rx_rd_ptr;     // RX FIFO'ya yazılacak yeri gösterir.


    localparam IDLE  = 1;
    localparam SEND  = 2;
    localparam LOAD  = 3;

    localparam x1  = 1;
    localparam x2  = 2;
    localparam x4  = 4;

    localparam read   = 0;
    localparam write  = 1;

    logic        start;             // QSPI_CCR'ye yazma yapıldığını ve çekirdeğin ayağa kalkması gerektiğini gösterir.
    logic        finish;            // Yazma veya okuma işleminin bittiğini gösterir ve QSPI_STA[0] bitini 1 yapmaya yarar.
    logic        set_finish;        // finish sinyalini qspi_falling_edge'den 1 clk önce 1 yapar, böylece finish sinyali tam olarak qspi_falling_edge'de 1 olur.
    logic [ 2:0] fifo_status;       // QSPI ile FIFO I/O işleminin hangi FSM'de olduğunu gösterir.
    logic [ 5:0] prscl_cnt;         // Clk divider için kullanılan sayacın verisini tutar.
    logic        busy;              // Modül flaş bellek ile ilgilenirken değeri 1 olur.
    logic [ 3:0] to_do_list;        // 0. instruction, 1. adres, 2. dummy, 3. bit ise FIFO ile ilgili bir işlemin varlığını gösterir.
    logic        fifo_rx_load_data; // Değeri 1 olduğunda RX FIFO'su yeni verisini "fifo_rx_rdata"ya yükler.
    logic        fifo_tx_load_data;
    logic [ 2:0] data_mode;         // Verinin hangi modda (x1, x2 ya da x4) modunda işleme alınacağının bilgisini tutar.
    logic [ 5:0] shift_cnt;         // FIFO'da veri kaydırma işlemlerinde veri uzunluğu hesaplanırken kullanılır.
    logic [31:0] shift_byte;        // FIFO'da veri kaydırma işlemlerinde kaydırılan veriyi tutar.
    logic        r_w;               // Yapılan işlemin yazma mı yoksa okuma mı olduğu bilgisini tutar.
    logic [ 8:0] data_byte_size;    // Flaşa yazılacak/okunacak kaç bayt verinin kaldığının bilgisini tutar.
    logic [ 4:0] dummy_cycle;       // Güncel yapılacak dummy cycle sayısını tutar
    logic        fifo_tx_push_data; // AXI TX FIFO'ya yazma isteği gönderdiği zaman gelen veriyi yazmak için FIFO'ya istek gönderir.
    logic        fifo_rx_push_data;
    logic        qspi_falling_edge; // QSPI modülünün çalışması için ayarlanan frekanstaki falling edge durumundan 1 clk önce 1 olur.
    logic        qspi_rising_edge;  // QSPI modülünün çalışması için ayarlanan frekanstaki rising edge durumundan 1 clk önce 1 olur.
    logic [ 3:0] fifo_error;        // QSPI_STA register'ının değerini güncellemek için kullanılır.

    logic io0_val;
    logic io1_val;
    logic io2_val;
    logic io3_val;
    logic io0_oe;
    logic io1_oe;
    logic io2_oe;
    logic io3_oe;

    logic dma_start;
    logic dma_rd_data;

    // ---------------------------------------------------------
    //                      CLK DIVIDER
    // ---------------------------------------------------------
    always @(posedge clk_i or negedge rst_n) begin

        if(!rst_n)begin
            prscl_cnt <= 0;
            QSPI_SCLK <= 0;
            qspi_falling_edge <= 0;
            qspi_rising_edge  <= 0;
        end
        else if(!QSPI_CS)begin
            if(QSPI_CCR[30:25] == 1 && !QSPI_SCLK) qspi_falling_edge <= 1;
            else if(prscl_cnt + 2 == QSPI_CCR[30:25] && QSPI_SCLK) qspi_falling_edge <= 1;
            else qspi_falling_edge <= 0;

            if(QSPI_CCR[30:25] == 1 && QSPI_SCLK) qspi_rising_edge <= 1;
            else if(prscl_cnt + 2 == QSPI_CCR[30:25] && !QSPI_SCLK) qspi_rising_edge <= 1;
            else qspi_rising_edge <= 0;

            if(prscl_cnt == QSPI_CCR[30:25]-1)begin
                prscl_cnt <= 0;
                QSPI_SCLK <= ~QSPI_SCLK;
            end
            else prscl_cnt <= prscl_cnt +1;
        end
        else begin
            prscl_cnt <= 0;
            QSPI_SCLK <= 0;
            qspi_falling_edge <= 0;
            qspi_rising_edge  <= 0;
        end
    end

    // ---------------------------------------------------------
    //                      FIFO'LAR
    // ---------------------------------------------------------
    always @(posedge clk_i) begin

        // TX FIFO'ya data yazma isteği
        if(fifo_tx_push_data && !QSPI_STA[6]) begin
            FIFO_TX[tx_wr_ptr] <= QSPI_DR;
        end
    end
    // TX READ
    assign fifo_tx_rdata = FIFO_TX[tx_rd_ptr];



    always @(posedge clk_i) begin
        // RX FIFO'ya data yazma isteği
        if(fifo_rx_push_data && !QSPI_STA[4]) begin
            FIFO_RX[rx_wr_ptr] <= fifo_rx_wdata;
        end
    end
    // RX READ
    assign fifo_rx_rdata = FIFO_RX[rx_rd_ptr];





    assign QSPI_IO0_out = io0_val;
    assign QSPI_IO1_out = io1_val;
    assign QSPI_IO2_out = io2_val;
    assign QSPI_IO3_out = io3_val;
    assign QSPI_IO0_oe  = io0_oe;
    assign QSPI_IO1_oe  = io1_oe;
    assign QSPI_IO2_oe  = io2_oe;
    assign QSPI_IO3_oe  = io3_oe;


    always@(posedge clk_i or negedge rst_n)begin
        if(!rst_n)begin
            QSPI_STA <= 0;
        end
        else if(QSPI_CCR[31]) QSPI_STA <= 0;
        else begin
        QSPI_STA[0]    <= finish;
        QSPI_STA[1]    <= busy;
        QSPI_STA[4]    <= fifo_rx_cnt == 64;     // RX FIFO full.
        QSPI_STA[5]    <= fifo_rx_cnt ? 0 : 1;   // RX FIFO empty. ////////////////////////
        QSPI_STA[6]    <= fifo_tx_cnt == 64;     // TX FIFO full.
        QSPI_STA[7]    <= fifo_tx_cnt ? 0 : 1;   // TX FIFO empty.
        QSPI_STA[11:8] <= fifo_error;            // '0000' Hata yok.
                                                 // '0001' RX FIFO boşken okunmaya çalışıldı.
                                                 // '0010' TX FIFO doluyken yazılmaya çalışıldı.
        end
    end


    // ---------------------------------------------------------
    //                      QSPI ÇEKİRDEĞİ
    // ---------------------------------------------------------
    always @(posedge clk_i or negedge rst_n) begin

        if(!rst_n)begin
            fifo_tx_load_data <= 0;
            fifo_rx_push_data <= 0;
            fifo_rx_cnt <= 0;
            fifo_tx_cnt <= 0;
            rx_wr_ptr   <= 0;
            rx_rd_ptr   <= 0;
            tx_wr_ptr   <= 0;
            tx_rd_ptr   <= 0;

            finish          <= 0;
            set_finish      <= 0;
            busy            <= 0;
            r_w             <= 0;
            dummy_cycle     <= 0;
            data_byte_size  <= 0;
            shift_byte      <= 0;
            shift_cnt       <= 0;
            to_do_list      <= 0;
            data_mode       <= 1;
            QSPI_CS         <= 1;
            fifo_status     <= IDLE;

            io0_val <= 0;
            io1_val <= 0;
            io2_val <= 0;
            io3_val <= 0;
            io0_oe  <= 0;
            io1_oe  <= 0;
            io2_oe  <= 0;
            io3_oe  <= 0;

            dma_data <= 32'b0;
            dma_rd_data <= 1'b0;
            dma_valid <= 1'b0;
        end
        else begin

            if(dma_start) dma_rd_data <= 1;
            if(!dma_rd_data) dma_valid <= 0;

            if(fifo_tx_load_data) fifo_tx_load_data <= 0;

            if((qspi_falling_edge && set_finish))begin
                finish <= 1;
                set_finish <= 0;
            end

            if(QSPI_CCR[31]) begin
                finish     <= 0;
            end


            if(QSPI_FCR[0])begin
                    fifo_rx_cnt <= 0;
                    rx_wr_ptr   <= 0;
                    rx_rd_ptr   <= 0;
                end
            if(QSPI_FCR[1])begin
                    fifo_tx_cnt <= 0;
                    tx_wr_ptr   <= 0;
                    tx_rd_ptr   <= 0;
                end

            if(fifo_rx_push_data) begin
                rx_wr_ptr <= rx_wr_ptr +1;
                fifo_rx_cnt <= fifo_rx_cnt +1;
                if(rx_wr_ptr == 63) rx_wr_ptr <= 0;
            end

            // RX FIFO'dan data okuma isteği
            if((fifo_rx_load_data || dma_rd_data)) begin
                rx_rd_ptr <= rx_rd_ptr +1;
                fifo_rx_cnt <= fifo_rx_cnt -1;
                if(rx_rd_ptr == 63) rx_rd_ptr <= 0;

                if(dma_rd_data)begin
                    dma_valid <= 1;
                    dma_data <= fifo_rx_rdata;
                    if(fifo_rx_cnt == 1) begin 
                        dma_rd_data <= 0;
                    end
                end

            end

            if(fifo_tx_push_data) begin
                tx_wr_ptr <= tx_wr_ptr +1;
                fifo_tx_cnt <= fifo_tx_cnt +1;
                if(tx_wr_ptr == 63) tx_wr_ptr <= 0;
            end

            if(fifo_tx_load_data)begin
                tx_rd_ptr <= tx_rd_ptr +1;
                if(tx_rd_ptr == 63) tx_rd_ptr <= 0;
                fifo_tx_cnt <= fifo_tx_cnt -1;
            end

            if(fifo_rx_push_data) fifo_rx_push_data <= 0;

            case(fifo_status)

                IDLE: begin
                    // QSPI_CCR'ye yazma yapıldıysa çekirdeği ayağa kaldır.
                    if(start && !busy)begin
                        shift_byte[31:25] <= QSPI_CCR[6:0];
                        busy <= 1;
                        to_do_list[0] <= 1;
                        to_do_list[1] <= |QSPI_CCR[24];
                        to_do_list[2] <= |QSPI_CCR[9:8] && !QSPI_CCR[10];
                        to_do_list[3] <= |QSPI_CCR[9:8];
                        data_byte_size <= QSPI_CCR[23:16] + 1;
                        QSPI_CS <= 0;

                        io0_val <= QSPI_CCR[7];
                        io0_oe  <= 1;
                        fifo_status <= SEND;

                        shift_cnt <= 7;

                        dummy_cycle <= QSPI_CCR[15:11];
                    end
                    else begin
                        if(qspi_falling_edge || QSPI_CS) begin
                            r_w <= write;
                            QSPI_CS   <= 1;
                            busy      <= 0;
                            data_mode <= 1;

                            io0_oe <= 0;
                            io1_oe <= 0;
                            io2_oe <= 0;
                            io3_oe <= 0;
                        end

                    end
                end

                SEND: begin
                        case(r_w)

                            read: begin

                                if(qspi_rising_edge) begin
                                    case(data_mode)
                                        x1: begin
                                            shift_byte <= {shift_byte[30:0], QSPI_IO1_in};
                                        end
                                        x2: begin
                                            shift_byte <= {shift_byte[29:0], QSPI_IO1_in, QSPI_IO0_in};
                                        end
                                        x4: begin
                                            shift_byte <= {shift_byte[27:0], QSPI_IO3_in, QSPI_IO2_in, QSPI_IO1_in, QSPI_IO0_in};
                                        end
                                    endcase
                                end
                            end

                            write: begin
                                if(qspi_falling_edge)begin
                                    case(data_mode)
                                        x1: begin
                                            io0_val  <= shift_byte[31];
                                            io0_oe  <= 1;
                                            shift_byte <= shift_byte << 1;
                                        end

                                        x2: begin
                                            io0_val <= shift_byte[30];
                                            io1_val <= shift_byte[31];
                                            io0_oe  <= 1;
                                            io1_oe  <= 1;
                                            shift_byte  <= shift_byte << 2;

                                        end

                                        x4: begin
                                            io0_val <= shift_byte[28];
                                            io1_val <= shift_byte[29];
                                            io2_val <= shift_byte[30];
                                            io3_val <= shift_byte[31];
                                            io0_oe  <= 1;
                                            io1_oe  <= 1;
                                            io2_oe  <= 1;
                                            io3_oe  <= 1;
                                            shift_byte <= shift_byte << 4;
                                        end
                                    endcase
                                end
                            end
                        endcase
                        if(r_w && qspi_falling_edge || (!r_w && qspi_rising_edge))begin
                            if (shift_cnt == data_mode)begin

                                if(to_do_list[0]) to_do_list[0] <= 0;
                                else if(to_do_list[1]) begin
                                    to_do_list[1] <= 0;
                                    if(QSPI_CCR[9:8] == 3) data_mode <= 4;
                                    else data_mode <= QSPI_CCR[9:8];
                                    r_w <= QSPI_CCR[10];
                                end
                                else if(to_do_list[2]) to_do_list[2] <= 0;
                                else to_do_list <= 0;

                                fifo_status <= LOAD;


                            end
                                else shift_cnt <= shift_cnt - data_mode;
                        end
                    end

                LOAD:begin
                    if (to_do_list[1])begin
                        if(QSPI_FCR[2] == 1) begin
                            shift_byte  <= QSPI_ADR;
                            shift_cnt <= 32;
                        end else begin
                            shift_byte[31:8]  <= QSPI_ADR[23:0];
                            shift_cnt <= 24;
                        end
                        fifo_status <= SEND;
                    end

                    else if (to_do_list[2])begin

                        if(qspi_falling_edge) begin

                            io0_oe <= 0;
                            io1_oe <= 0;
                            io2_oe <= 0;
                            io3_oe <= 0;

                            if (dummy_cycle)begin
                                dummy_cycle <= dummy_cycle -1;
                            end
                            else begin
                                if(data_byte_size > 4) begin
                                    shift_cnt <= 32;
                                    data_byte_size <= data_byte_size -4;
                                    to_do_list[2] <= 1;
                                end
                                else begin
                                    case (data_byte_size)
                                        1: shift_cnt <= 8;
                                        2: shift_cnt <= 16;
                                        3: shift_cnt <= 24;
                                        4: shift_cnt <= 32;
                                    endcase
                                    data_byte_size <= 0;
                                    to_do_list[2] <= 0;
                                end
                                if(QSPI_CCR[9:8] == 3) data_mode <= 4;
                                else data_mode <= QSPI_CCR[9:8];
                                r_w <= QSPI_CCR[10];
                                fifo_status <= SEND;
                            end
                        end
                    end

                    else if (to_do_list[3])begin

                        if(data_byte_size > 4) begin
                            shift_cnt <= 32;
                            data_byte_size <= data_byte_size -4;
                            to_do_list[2] <= 1;
                        end
                        else begin
                            case (data_byte_size)
                                1: shift_cnt <= 8;
                                2: shift_cnt <= 16;
                                3: shift_cnt <= 24;
                                4: shift_cnt <= 32;
                            endcase
                            data_byte_size <= 0;
                        end
                        if (r_w) begin
                            if(fifo_tx_cnt) begin
                                shift_byte <= {fifo_tx_rdata};
                                fifo_tx_load_data <= 1;
                            end
                        end
                        else begin
                            if(fifo_rx_cnt <= 64) begin
                                fifo_rx_push_data <= 1;
                                fifo_rx_wdata <= shift_byte;
                            end
                        end

                        fifo_status <= SEND;
                    end

                    else begin
                        if(!r_w) begin
                            QSPI_CS <= 1;
                            if(fifo_rx_cnt <= 64) begin
                                fifo_rx_push_data <= 1;
                                fifo_rx_wdata <= shift_byte;
                            end
                        end
                        if(r_w) set_finish <= 1;
                        else finish <= 1;
                        fifo_status <= IDLE;
                    end
                end
            endcase
            end
        end




    always @(posedge clk_i or negedge rst_n) begin

        // ---------------------------------------------------------
        //                      RESET İŞLEMLERİ
        // ---------------------------------------------------------
        if(!rst_n)begin
            QSPI_CCR <= 0;
            QSPI_ADR <= 0;
            QSPI_DR <= 0;
            QSPI_FCR <= 0;

            bvalid <= 1'b0;
            rdata <= 32'h0000;
            rvalid <= 1'b0;
            awready <= 1;
            wready <= 1;
            arready <= 1;

            fifo_tx_push_data <= 0;
            fifo_rx_load_data <= 0;
            fifo_error <= 0;
            start <= 0;
            dma_start <= 0;
        end
        else begin

            if(QSPI_CCR[31]) begin
                fifo_error <= 0;
                QSPI_CCR[31] <= 0;
            end

            if(dma_start) dma_start <= 0;

            if(fifo_rx_load_data) fifo_rx_load_data <= 0;
            if(fifo_tx_push_data) fifo_tx_push_data <= 0;

            if(start) start <= 0;
            if(QSPI_FCR) QSPI_FCR <= 0;
            // ---------------------------------------------------------
            //                      AXI YAZMA İŞLEMİ
            // ---------------------------------------------------------

            if (awvalid && wvalid && awready && wready) begin
                awready <= 1'b0;
                wready  <= 1'b0;
                bvalid  <= 1'b1;

                case (awaddr[7:0])
                    8'h00: begin
                            QSPI_CCR <= wdata;
                            if(wdata[31] == 0)start <= 1;
                        end
                    8'h04: QSPI_ADR <= wdata;
                    8'h08: begin
                            if(QSPI_STA[6]) begin
                                fifo_error[1] <= 1;
                            end
                            else begin
                                QSPI_DR  <= wdata;
                                fifo_tx_push_data <= 1;
                            end
                        end
                    8'h10: QSPI_FCR <= wdata;
                    8'h14: dma_start <= wdata[0];
                endcase
            end

            else if (bvalid && bready) begin
                bvalid  <= 1'b0;
                awready <= 1'b1;
                wready  <= 1'b1;
            end


            // ---------------------------------------------------------
            //                  AXI OKUMA İŞLEMİ
            // ---------------------------------------------------------
            if (arvalid && arready) begin
                arready <= 0;
                rvalid  <= 1'b1;

                case (araddr[7:0])
                    8'h00: rdata <= QSPI_CCR;
                    8'h04: rdata <= QSPI_ADR;
                    8'h08: begin
                        if(QSPI_STA[5]) begin
                            rdata <= 0;
                            fifo_error[0] <= 1;
                        end
                        else begin
                            rdata <= fifo_rx_rdata;
                            fifo_rx_load_data <= 1;
                        end
                    end
                    8'h0C: rdata <= QSPI_STA;
                    8'h10: rdata <= QSPI_FCR;
                    8'h14: rdata <= {31'b0, dma_valid};

                  default: rdata <= 32'h00000000;
                endcase
            end
            else if (rvalid && rready) begin
                arready <= 1;
                rvalid  <= 1'b0;
            end

        end
    end

    // ASIC yamasi: bkz. dosya basi
    assign bresp = 2'b00;   // AXI OKAY
    // ASIC yamasi: bkz. dosya basi
    assign rresp = 2'b00;   // AXI OKAY

endmodule
