YTU-YODA-KYBER/2026_teknofest-mikrodenetleyici-tasarimi/asic_rtl/gen/fc_weights_rom_p4_asic.v

// ---------------------------------------------------------------------------
//  fc_weights_rom_p4 -- OTOMATIK URETILMIS DOSYA, ELLE DUZENLEME.
//
//  Ureten : asic/scripts/gen_rom.py
//  Kaynak : fc_weights_p4.hex
//  Kaynak SHA256 : 2d6635eabb0b199b2998f8735880d70915cde29459bb9e01a0312ab5a0c8ba33
//  Icerik : 4000 / 4000 kelime x 32 bit  (128000 bit)
//
//  Kaynak hex'in SHA256'si BILEREK bu basliktadir: `gen_rom.py --all --check`
//  uretimi bellekte tekrarlayip diskteki dosyayla metin bazinda karsilastirir.
//  Boylece firmware/agirliklar yeniden uretildiginde ve `make roms`
//  unutuldugunda BAYAT bir ROM sessizce senteze giremez (patch_rtl.py'nin
//  yamali kopyalar icin yaptigi kontrolun ROM karsiligi).
//
//  Bu modul ASIC akisinda AI_Accelerator/fc_weights_rom_p4.v dosyasinin
//  yerine gecer (modul adi ve port listesi birebir aynidir). Icerik silikonda
//  mask ROM olarak standart hucrelerden orulur; SRAM makrosu KULLANILMAZ,
//  cunku bu bellek kalicidir ve guc verildiginde hazir olmalidir.
// ---------------------------------------------------------------------------

module fc_weights_rom_p4 (
    input  wire                  clk,
    input  wire [11:0] addr,
    output reg  [31:0] dout
);
    reg [31:0] mem [0:3999];

    integer i;
    initial begin
        mem[0] = 32'h060804FF;
        mem[1] = 32'hF006F4F9;
        mem[2] = 32'h151815FD;
        mem[3] = 32'h14060F0A;
        mem[4] = 32'h130C1007;
        mem[5] = 32'h20131808;
        mem[6] = 32'h1BFDD607;
        mem[7] = 32'hDE092903;
        mem[8] = 32'h10131007;
        mem[9] = 32'h052604F2;
        mem[10] = 32'h33121CD1;
        mem[11] = 32'hF8F4EF09;
        mem[12] = 32'h08EF0FF0;
        mem[13] = 32'h04000CE9;
        mem[14] = 32'h17F5C728;
        mem[15] = 32'h0D280409;
        mem[16] = 32'h0F18FEDF;
        mem[17] = 32'hF6FEEB05;
        mem[18] = 32'h0104FFFA;
        mem[19] = 32'hED0EF5F0;
        mem[20] = 32'h2821E3E8;
        mem[21] = 32'h251A15E3;
        mem[22] = 32'h1C0AFE13;
        mem[23] = 32'h131ECB0E;
        mem[24] = 32'hFB091008;
        mem[25] = 32'hEAF0FFEF;
        mem[26] = 32'hFB0D12D3;
        mem[27] = 32'hF30FFBEE;
        mem[28] = 32'h1CECE40F;
        mem[29] = 32'hF9F3EBE8;
        mem[30] = 32'h1F17F9EB;
        mem[31] = 32'hF0220014;
        mem[32] = 32'hFB0002F7;
        mem[33] = 32'h17ECF1ED;
        mem[34] = 32'hF80E14FD;
        mem[35] = 32'hFF01131F;
        mem[36] = 32'h10E901E8;
        mem[37] = 32'hF70802D5;
        mem[38] = 32'h0B09F9EB;
        mem[39] = 32'h24F201FC;
        mem[40] = 32'h04F2060E;
        mem[41] = 32'h00080CF4;
        mem[42] = 32'h0DF0F5F7;
        mem[43] = 32'h0C0B0A07;
        mem[44] = 32'hF7D91E05;
        mem[45] = 32'h0A0901EA;
        mem[46] = 32'h161419F6;
        mem[47] = 32'h13F50E1F;
        mem[48] = 32'hF8F605F8;
        mem[49] = 32'h0504F5DB;
        mem[50] = 32'h0A190ADC;
        mem[51] = 32'hF1F4FF0B;
        mem[52] = 32'hF511FF03;
        mem[53] = 32'hEEE9F2DD;
        mem[54] = 32'hF8F2FBD8;
        mem[55] = 32'h140DDBF3;
        mem[56] = 32'h0E20F80F;
        mem[57] = 32'hED170619;
        mem[58] = 32'hFE0A17E1;
        mem[59] = 32'h1B05F209;
        mem[60] = 32'hFE0CF7FC;
        mem[61] = 32'h17040DE4;
        mem[62] = 32'h13010E02;
        mem[63] = 32'h10FDF404;
        mem[64] = 32'h12F4FAF1;
        mem[65] = 32'h21FBF704;
        mem[66] = 32'h1C1B14EB;
        mem[67] = 32'hFA0CDBF3;
        mem[68] = 32'hE5F2E01E;
        mem[69] = 32'h0B0BFD06;
        mem[70] = 32'h08FF08FD;
        mem[71] = 32'h0CFE1611;
        mem[72] = 32'h1001F7FC;
        mem[73] = 32'h1BD816FA;
        mem[74] = 32'h03FAFCF6;
        mem[75] = 32'hEF0E091F;
        mem[76] = 32'h0DF5270F;
        mem[77] = 32'h05140702;
        mem[78] = 32'h0AF909F5;
        mem[79] = 32'hF001FBF7;
        mem[80] = 32'h04040AFF;
        mem[81] = 32'h11F8FC24;
        mem[82] = 32'h15FA0CDF;
        mem[83] = 32'h0002E4F7;
        mem[84] = 32'hFDE8DBF8;
        mem[85] = 32'hEFF9EEF3;
        mem[86] = 32'h02F9FFF6;
        mem[87] = 32'h18EA10E9;
        mem[88] = 32'hF4F1F3EF;
        mem[89] = 32'h09070903;
        mem[90] = 32'hFAFFFADD;
        mem[91] = 32'hF61EF4F2;
        mem[92] = 32'h02012328;
        mem[93] = 32'hF70BF3E1;
        mem[94] = 32'hFDF7F4F2;
        mem[95] = 32'h130A1922;
        mem[96] = 32'hEFF7FFF4;
        mem[97] = 32'h130CFA09;
        mem[98] = 32'hF7FDFFF7;
        mem[99] = 32'hF9EC19F9;
        mem[100] = 32'h17F30FF0;
        mem[101] = 32'h0F0511D4;
        mem[102] = 32'hFAF8EDF9;
        mem[103] = 32'hF8DAECEE;
        mem[104] = 32'h150BF8FF;
        mem[105] = 32'hFF150F14;
        mem[106] = 32'h04F610DA;
        mem[107] = 32'hEFEEF3F3;
        mem[108] = 32'hF0F9FF11;
        mem[109] = 32'h15100BE2;
        mem[110] = 32'hFAFAF7F6;
        mem[111] = 32'hFEFE060C;
        mem[112] = 32'hF0080BF2;
        mem[113] = 32'hF4F00EEB;
        mem[114] = 32'hEDE607F8;
        mem[115] = 32'h06ECE4E8;
        mem[116] = 32'h1C0518E3;
        mem[117] = 32'h02FF0A08;
        mem[118] = 32'hFB150802;
        mem[119] = 32'hF7190E17;
        mem[120] = 32'h051F02F4;
        mem[121] = 32'hFB110A0B;
        mem[122] = 32'h0CFC050C;
        mem[123] = 32'hEF091927;
        mem[124] = 32'hF40802E6;
        mem[125] = 32'hF001F302;
        mem[126] = 32'hF606FE03;
        mem[127] = 32'hECFEFEF9;
        mem[128] = 32'h17040B14;
        mem[129] = 32'hF3080F18;
        mem[130] = 32'hF5FBFCF6;
        mem[131] = 32'hEFFBFAEB;
        mem[132] = 32'h0208051F;
        mem[133] = 32'hFDF4F90C;
        mem[134] = 32'hE5F6E2F1;
        mem[135] = 32'h2128F9EE;
        mem[136] = 32'h0C101BFC;
        mem[137] = 32'hF1F9F708;
        mem[138] = 32'h1E280FF0;
        mem[139] = 32'h080B07FE;
        mem[140] = 32'hF1F8FCFD;
        mem[141] = 32'h0B0D12EE;
        mem[142] = 32'hF701FE17;
        mem[143] = 32'h090001FD;
        mem[144] = 32'h1DFFFD1C;
        mem[145] = 32'hF202F0EF;
        mem[146] = 32'hF90504FD;
        mem[147] = 32'hF208F4DE;
        mem[148] = 32'hFBEAFD04;
        mem[149] = 32'h0EE90705;
        mem[150] = 32'hEDF4F2F0;
        mem[151] = 32'hF8F60431;
        mem[152] = 32'hFA0104FA;
        mem[153] = 32'hDDEA070B;
        mem[154] = 32'hF0DFEFDC;
        mem[155] = 32'hFD1F0C0D;
        mem[156] = 32'hDBFEEDED;
        mem[157] = 32'h1A0A0EF5;
        mem[158] = 32'hF4F9F6FA;
        mem[159] = 32'hEFF7EFF4;
        mem[160] = 32'h0C0C0808;
        mem[161] = 32'h061B070C;
        mem[162] = 32'h0F0604D7;
        mem[163] = 32'hDFEDE91E;
        mem[164] = 32'hE2F6F315;
        mem[165] = 32'h06F22003;
        mem[166] = 32'h0603DAF5;
        mem[167] = 32'hEE031502;
        mem[168] = 32'hFAFDF8F4;
        mem[169] = 32'h0D04FFFB;
        mem[170] = 32'h17F5ECED;
        mem[171] = 32'hFC10E001;
        mem[172] = 32'hF90AF6FE;
        mem[173] = 32'h150BFFD6;
        mem[174] = 32'h1AF4E91F;
        mem[175] = 32'hE4F808FD;
        mem[176] = 32'hFBF101FD;
        mem[177] = 32'h0CE7100E;
        mem[178] = 32'h1A05F0FA;
        mem[179] = 32'hFCFEFC06;
        mem[180] = 32'h1BE7E9F1;
        mem[181] = 32'h040B08F9;
        mem[182] = 32'h07F1E8E2;
        mem[183] = 32'h20ECF516;
        mem[184] = 32'hFFF4F8E9;
        mem[185] = 32'h09ECE5F1;
        mem[186] = 32'h0F061703;
        mem[187] = 32'hF2EEE60D;
        mem[188] = 32'h26DE030D;
        mem[189] = 32'h1905FCDF;
        mem[190] = 32'h1F1B09F9;
        mem[191] = 32'h0DFEF51A;
        mem[192] = 32'h0213DD0E;
        mem[193] = 32'h16F3F2F6;
        mem[194] = 32'h03D9FFFC;
        mem[195] = 32'h03EA050A;
        mem[196] = 32'hFD04F619;
        mem[197] = 32'h0510F8E2;
        mem[198] = 32'h0105F5E0;
        mem[199] = 32'h1BED0709;
        mem[200] = 32'h0A15FC15;
        mem[201] = 32'h1102F1F0;
        mem[202] = 32'hFA0B04F1;
        mem[203] = 32'h2110F306;
        mem[204] = 32'h13FA13F1;
        mem[205] = 32'hFB02E1E1;
        mem[206] = 32'h0C050FEF;
        mem[207] = 32'h050BF21A;
        mem[208] = 32'hF3020A08;
        mem[209] = 32'hDD07F9E8;
        mem[210] = 32'hE4FCFDFD;
        mem[211] = 32'hDCF51C12;
        mem[212] = 32'h2215E014;
        mem[213] = 32'h1B141106;
        mem[214] = 32'h15051BF1;
        mem[215] = 32'h14F7E6FC;
        mem[216] = 32'h0E0CEFEA;
        mem[217] = 32'hE8FE05FB;
        mem[218] = 32'h00F605F7;
        mem[219] = 32'hF7F40CEA;
        mem[220] = 32'hF8FA231D;
        mem[221] = 32'hF4061009;
        mem[222] = 32'h0BFC09FA;
        mem[223] = 32'h0B13FEF6;
        mem[224] = 32'hFDDCF708;
        mem[225] = 32'h21E41AF2;
        mem[226] = 32'hE309F1E7;
        mem[227] = 32'h0FFAFCF8;
        mem[228] = 32'hE10211FC;
        mem[229] = 32'h22231D16;
        mem[230] = 32'h01ECFFF5;
        mem[231] = 32'h2106030E;
        mem[232] = 32'h0B110308;
        mem[233] = 32'h1F13E6F9;
        mem[234] = 32'h09F8070A;
        mem[235] = 32'h10FA1103;
        mem[236] = 32'hE2270C26;
        mem[237] = 32'h18280DD8;
        mem[238] = 32'h110B1602;
        mem[239] = 32'h0E2305F5;
        mem[240] = 32'hEDEC05F6;
        mem[241] = 32'h01F125F6;
        mem[242] = 32'h1409F3EF;
        mem[243] = 32'h1217101F;
        mem[244] = 32'hFD0F10E4;
        mem[245] = 32'h111306E2;
        mem[246] = 32'hF6FF09FB;
        mem[247] = 32'hE9F2E802;
        mem[248] = 32'h20FC1A1B;
        mem[249] = 32'hE10AF0E6;
        mem[250] = 32'hF5F5EEDE;
        mem[251] = 32'h1B0D0900;
        mem[252] = 32'h2703FFF2;
        mem[253] = 32'h222624ED;
        mem[254] = 32'hFA01F7FB;
        mem[255] = 32'hF70FFB18;
        mem[256] = 32'hFEFEE6E4;
        mem[257] = 32'h13F10616;
        mem[258] = 32'hF6FBFA1A;
        mem[259] = 32'hDCE6081D;
        mem[260] = 32'h06F003F1;
        mem[261] = 32'h0D0200F6;
        mem[262] = 32'hF4F2F2EA;
        mem[263] = 32'h05FF0416;
        mem[264] = 32'h2002F005;
        mem[265] = 32'h0D11EBDE;
        mem[266] = 32'h0BFF14FB;
        mem[267] = 32'hE4FD1C18;
        mem[268] = 32'h151C03F5;
        mem[269] = 32'h280221E4;
        mem[270] = 32'h0C0B14FE;
        mem[271] = 32'h00F61DE2;
        mem[272] = 32'hF514FE1B;
        mem[273] = 32'h070C031C;
        mem[274] = 32'h0C0BF60C;
        mem[275] = 32'h0A2102E8;
        mem[276] = 32'h06280902;
        mem[277] = 32'h0EF0FFEE;
        mem[278] = 32'hF31100FB;
        mem[279] = 32'hFB051307;
        mem[280] = 32'hFE06EF24;
        mem[281] = 32'h04ED10F2;
        mem[282] = 32'h08F91EE9;
        mem[283] = 32'hF40A0BFA;
        mem[284] = 32'hEFF21D0D;
        mem[285] = 32'h03EF1C05;
        mem[286] = 32'hE4F8F1F1;
        mem[287] = 32'hEBF1F603;
        mem[288] = 32'h06FEE7FE;
        mem[289] = 32'hEE0DFDF6;
        mem[290] = 32'hEDF91419;
        mem[291] = 32'hDBF70106;
        mem[292] = 32'hEBEAFFFF;
        mem[293] = 32'h1D0013F9;
        mem[294] = 32'hF408F704;
        mem[295] = 32'hFADBFCFB;
        mem[296] = 32'h0C020015;
        mem[297] = 32'hFC0F21EF;
        mem[298] = 32'hFEFEE3F1;
        mem[299] = 32'h1104EBF8;
        mem[300] = 32'hF7EF07E9;
        mem[301] = 32'hF8200EE1;
        mem[302] = 32'hF5160910;
        mem[303] = 32'hEF01F104;
        mem[304] = 32'hE7E8F8FC;
        mem[305] = 32'hFCEDFDE6;
        mem[306] = 32'h1BE4031F;
        mem[307] = 32'hDC22EEED;
        mem[308] = 32'h17F6190B;
        mem[309] = 32'hFD19FDEF;
        mem[310] = 32'hFE00FF00;
        mem[311] = 32'h0004FB1E;
        mem[312] = 32'hEA01FFE6;
        mem[313] = 32'hF413EA16;
        mem[314] = 32'hF1EBFBF3;
        mem[315] = 32'hF70D0709;
        mem[316] = 32'h0FECF0FD;
        mem[317] = 32'h21010A08;
        mem[318] = 32'h04080408;
        mem[319] = 32'hFD050406;
        mem[320] = 32'h0D0C0B06;
        mem[321] = 32'h0C0E1223;
        mem[322] = 32'h0AFEFEDF;
        mem[323] = 32'h14020BFC;
        mem[324] = 32'hFD12E008;
        mem[325] = 32'h19F7FFF4;
        mem[326] = 32'h0927F6EA;
        mem[327] = 32'h01F9E50C;
        mem[328] = 32'hFDFDFCF2;
        mem[329] = 32'hE21811E6;
        mem[330] = 32'h0CFEED18;
        mem[331] = 32'h0C24FDF5;
        mem[332] = 32'hE0F71502;
        mem[333] = 32'h251303F9;
        mem[334] = 32'hFBEDDD50;
        mem[335] = 32'hFF1EDB09;
        mem[336] = 32'h0D090401;
        mem[337] = 32'h18FFFEDA;
        mem[338] = 32'hF6D8FF0B;
        mem[339] = 32'h0BF40E05;
        mem[340] = 32'h1912FF12;
        mem[341] = 32'h12F8FA18;
        mem[342] = 32'h1004FBEF;
        mem[343] = 32'h090CE504;
        mem[344] = 32'h0B1CEF0E;
        mem[345] = 32'h0611F6D9;
        mem[346] = 32'h12FDFEFF;
        mem[347] = 32'h1C1722DC;
        mem[348] = 32'h101D0FF6;
        mem[349] = 32'h0301E816;
        mem[350] = 32'h1313FEF9;
        mem[351] = 32'h0AEEF4F4;
        mem[352] = 32'h0511FDEC;
        mem[353] = 32'h0FF3D9FF;
        mem[354] = 32'h09F803EA;
        mem[355] = 32'h01060AE6;
        mem[356] = 32'h21F6DFFA;
        mem[357] = 32'hE416CF0A;
        mem[358] = 32'h01FEF1ED;
        mem[359] = 32'h261514EF;
        mem[360] = 32'hF9160502;
        mem[361] = 32'hF4DCFDF0;
        mem[362] = 32'h051FFB25;
        mem[363] = 32'h1900F321;
        mem[364] = 32'h0025FBF1;
        mem[365] = 32'hFFEEFB26;
        mem[366] = 32'h0BFF0FF5;
        mem[367] = 32'hFFF7F8ED;
        mem[368] = 32'h16F60509;
        mem[369] = 32'h090209EA;
        mem[370] = 32'hE7DD03EA;
        mem[371] = 32'hEE15F724;
        mem[372] = 32'hEDF105FA;
        mem[373] = 32'hF5140511;
        mem[374] = 32'h0F0813FC;
        mem[375] = 32'h2FE8FBDF;
        mem[376] = 32'hEEE5EBF3;
        mem[377] = 32'h1921230A;
        mem[378] = 32'h03EAE728;
        mem[379] = 32'h0AF0180C;
        mem[380] = 32'h101AFB19;
        mem[381] = 32'hEE0700FF;
        mem[382] = 32'hF7EAFEF5;
        mem[383] = 32'h2E08DDD6;
        mem[384] = 32'hF4EAE90E;
        mem[385] = 32'h08E4EAE2;
        mem[386] = 32'hF71ED32A;
        mem[387] = 32'hEE00E806;
        mem[388] = 32'h07131AFA;
        mem[389] = 32'h0017EF03;
        mem[390] = 32'hFCEC01F9;
        mem[391] = 32'h0E11F1E6;
        mem[392] = 32'hF0D609EF;
        mem[393] = 32'h12111D23;
        mem[394] = 32'h0818D8F9;
        mem[395] = 32'h0517FCFA;
        mem[396] = 32'hED04DAE6;
        mem[397] = 32'h111519FE;
        mem[398] = 32'hFC0303FC;
        mem[399] = 32'hFB3AEC03;
        mem[400] = 32'hF7D6E506;
        mem[401] = 32'h2502F31A;
        mem[402] = 32'hF107EDF9;
        mem[403] = 32'h05040A08;
        mem[404] = 32'h0CE6F4E0;
        mem[405] = 32'hF9E513E5;
        mem[406] = 32'hFAFE0BFF;
        mem[407] = 32'h030EF705;
        mem[408] = 32'h0CFF0C01;
        mem[409] = 32'h16ED00E7;
        mem[410] = 32'h04FCF912;
        mem[411] = 32'h25FBEA02;
        mem[412] = 32'hF8FFE31D;
        mem[413] = 32'hE71CFE05;
        mem[414] = 32'hFC06FF03;
        mem[415] = 32'h110A0D05;
        mem[416] = 32'h0DFB0A0B;
        mem[417] = 32'h19F91BEE;
        mem[418] = 32'hD8EAD7ED;
        mem[419] = 32'hFA1A17FC;
        mem[420] = 32'h0B21EB0F;
        mem[421] = 32'h06F5E9F3;
        mem[422] = 32'hFD040002;
        mem[423] = 32'hEF060EE0;
        mem[424] = 32'h130AEE15;
        mem[425] = 32'hF6E324DF;
        mem[426] = 32'hFF16EF02;
        mem[427] = 32'h0EEA09ED;
        mem[428] = 32'hF9040710;
        mem[429] = 32'h04E2F026;
        mem[430] = 32'hF1F9F5EF;
        mem[431] = 32'hDCF9070D;
        mem[432] = 32'hFBE6F506;
        mem[433] = 32'hE1FBF5EE;
        mem[434] = 32'hF60F10EF;
        mem[435] = 32'h0BFC17F6;
        mem[436] = 32'h150606EB;
        mem[437] = 32'h07FBF711;
        mem[438] = 32'hF710FC09;
        mem[439] = 32'h020702F4;
        mem[440] = 32'h0E07FBF7;
        mem[441] = 32'hF113F906;
        mem[442] = 32'hFD07E70F;
        mem[443] = 32'hE3FC0A01;
        mem[444] = 32'hEB16262A;
        mem[445] = 32'h07EFF30B;
        mem[446] = 32'hF1070101;
        mem[447] = 32'hEFDC01DD;
        mem[448] = 32'h031209FC;
        mem[449] = 32'hFE1F0BF4;
        mem[450] = 32'hF80802F1;
        mem[451] = 32'h07F42717;
        mem[452] = 32'h10E9F803;
        mem[453] = 32'hF714EE04;
        mem[454] = 32'h0006FD07;
        mem[455] = 32'hF9F71CFC;
        mem[456] = 32'hF2F1F822;
        mem[457] = 32'h0E0CF2FC;
        mem[458] = 32'hF9010FDE;
        mem[459] = 32'hF20CFCFE;
        mem[460] = 32'h1DE60D0B;
        mem[461] = 32'hF504E003;
        mem[462] = 32'hD8F3EAF3;
        mem[463] = 32'hFFF202FB;
        mem[464] = 32'hE6E50B0C;
        mem[465] = 32'h18F30025;
        mem[466] = 32'h2AEFE004;
        mem[467] = 32'h1B1D0819;
        mem[468] = 32'h03F6FE04;
        mem[469] = 32'h16201003;
        mem[470] = 32'hFE070401;
        mem[471] = 32'hF4FEFEFA;
        mem[472] = 32'hF5F4EBFB;
        mem[473] = 32'hFD0513F7;
        mem[474] = 32'h04EE01F6;
        mem[475] = 32'h01100C0E;
        mem[476] = 32'hFEFD0E15;
        mem[477] = 32'hFE0EED0E;
        mem[478] = 32'h070B0909;
        mem[479] = 32'hFC0201FF;
        mem[480] = 32'h0E0D0C06;
        mem[481] = 32'hFAD8E3FA;
        mem[482] = 32'h150710FB;
        mem[483] = 32'hEBFBDF1E;
        mem[484] = 32'h0226D1FB;
        mem[485] = 32'h150A1405;
        mem[486] = 32'hEA1CF322;
        mem[487] = 32'hFD21EFF9;
        mem[488] = 32'h040609FE;
        mem[489] = 32'hE51FF0F7;
        mem[490] = 32'hFEF4EE1D;
        mem[491] = 32'hED06E5ED;
        mem[492] = 32'hFE3711DF;
        mem[493] = 32'h1A18F418;
        mem[494] = 32'h09FAF609;
        mem[495] = 32'h2A1600EB;
        mem[496] = 32'h1B1EE8EF;
        mem[497] = 32'hDF242004;
        mem[498] = 32'hFBFB0A12;
        mem[499] = 32'hF8F0FCEA;
        mem[500] = 32'hF112EADF;
        mem[501] = 32'h04F9F7FB;
        mem[502] = 32'h1A0202DA;
        mem[503] = 32'h340916F6;
        mem[504] = 32'h0717E7DF;
        mem[505] = 32'hF916F317;
        mem[506] = 32'h0DF30DEF;
        mem[507] = 32'hF5F9E4EF;
        mem[508] = 32'hEF1704E1;
        mem[509] = 32'hECF2E61A;
        mem[510] = 32'h1002EFD9;
        mem[511] = 32'h1A0AF8E2;
        mem[512] = 32'h0B2D0FE2;
        mem[513] = 32'h0FE723FC;
        mem[514] = 32'h13E30205;
        mem[515] = 32'hFE25E011;
        mem[516] = 32'h10F001F6;
        mem[517] = 32'h22F901EE;
        mem[518] = 32'h1E0F01E8;
        mem[519] = 32'h02DD05F2;
        mem[520] = 32'hE615F5E1;
        mem[521] = 32'hF7E60D08;
        mem[522] = 32'h1104F526;
        mem[523] = 32'hFAFCF504;
        mem[524] = 32'h11F1E1ED;
        mem[525] = 32'hFC17FF03;
        mem[526] = 32'h1B0A04E0;
        mem[527] = 32'h21EA00FB;
        mem[528] = 32'h1224F4EE;
        mem[529] = 32'hF4070D0C;
        mem[530] = 32'h18F1EEEE;
        mem[531] = 32'h1611F1F6;
        mem[532] = 32'h2913EF04;
        mem[533] = 32'hE429F72D;
        mem[534] = 32'h0CF40BF2;
        mem[535] = 32'h2EC5FFD3;
        mem[536] = 32'h12FB1BF4;
        mem[537] = 32'h0707ECE0;
        mem[538] = 32'h20EF05F8;
        mem[539] = 32'hF613E70C;
        mem[540] = 32'h1D0BF3FE;
        mem[541] = 32'hF4E11311;
        mem[542] = 32'h12F1120B;
        mem[543] = 32'h33EBF2D7;
        mem[544] = 32'hF4F8F3FD;
        mem[545] = 32'hEE1BFC18;
        mem[546] = 32'hFE09EA07;
        mem[547] = 32'h0508060D;
        mem[548] = 32'h061FFE07;
        mem[549] = 32'hFB151308;
        mem[550] = 32'h13F212F4;
        mem[551] = 32'h0C05DBC6;
        mem[552] = 32'h0E02110A;
        mem[553] = 32'hF0DDE20A;
        mem[554] = 32'h0009FC1F;
        mem[555] = 32'hF80F0D0C;
        mem[556] = 32'hEE161CF4;
        mem[557] = 32'hF310E81D;
        mem[558] = 32'h17011D02;
        mem[559] = 32'h0030FC0B;
        mem[560] = 32'hF7F2F209;
        mem[561] = 32'hFBE0E20E;
        mem[562] = 32'hFC271321;
        mem[563] = 32'h0FFE1DFF;
        mem[564] = 32'hF4F1DA17;
        mem[565] = 32'hD50EF60B;
        mem[566] = 32'h0A0E1C0D;
        mem[567] = 32'hED0718F2;
        mem[568] = 32'hEBE61EED;
        mem[569] = 32'hF507F4D7;
        mem[570] = 32'hE90BFA0A;
        mem[571] = 32'hEF1803F8;
        mem[572] = 32'hD8FEDC03;
        mem[573] = 32'hF00F0F06;
        mem[574] = 32'hF801FFFA;
        mem[575] = 32'hE207FFE5;
        mem[576] = 32'h19F418FD;
        mem[577] = 32'hF7070B03;
        mem[578] = 32'hF810ED14;
        mem[579] = 32'h0AE7F10F;
        mem[580] = 32'h0BFBF8E9;
        mem[581] = 32'h09F3021A;
        mem[582] = 32'hFAF7F4F4;
        mem[583] = 32'hE70B10DA;
        mem[584] = 32'h0FF9F901;
        mem[585] = 32'hFC15EBE6;
        mem[586] = 32'hE8180B09;
        mem[587] = 32'h02250E06;
        mem[588] = 32'h000C0F11;
        mem[589] = 32'h1A14010D;
        mem[590] = 32'hFE0202FD;
        mem[591] = 32'hFD081BEB;
        mem[592] = 32'h1B0A0616;
        mem[593] = 32'hE60F1023;
        mem[594] = 32'hEF1000FA;
        mem[595] = 32'h0FECE700;
        mem[596] = 32'hE3EE230B;
        mem[597] = 32'h101A0D17;
        mem[598] = 32'hF103F6F7;
        mem[599] = 32'hE21411DA;
        mem[600] = 32'h0B0F08D7;
        mem[601] = 32'h0EFAF51B;
        mem[602] = 32'h06250FFA;
        mem[603] = 32'h29FF0501;
        mem[604] = 32'h00181303;
        mem[605] = 32'h010DF705;
        mem[606] = 32'hF30B01FE;
        mem[607] = 32'h00EA01D6;
        mem[608] = 32'h111F0C02;
        mem[609] = 32'h0428F6EE;
        mem[610] = 32'hF210F9EE;
        mem[611] = 32'hF70CF002;
        mem[612] = 32'hEAE729F3;
        mem[613] = 32'hF8EE0106;
        mem[614] = 32'hE0F7E9ED;
        mem[615] = 32'h09FA1103;
        mem[616] = 32'h0E0302EC;
        mem[617] = 32'h1315FA01;
        mem[618] = 32'hF40CEBF2;
        mem[619] = 32'h001D160F;
        mem[620] = 32'h09010E05;
        mem[621] = 32'hFA001017;
        mem[622] = 32'hF512090B;
        mem[623] = 32'h0CEE0EFB;
        mem[624] = 32'hFF011C0F;
        mem[625] = 32'h18F10A05;
        mem[626] = 32'h08F8E303;
        mem[627] = 32'h0D0BD313;
        mem[628] = 32'hFAF301FF;
        mem[629] = 32'hDEFDE306;
        mem[630] = 32'hFA040002;
        mem[631] = 32'h03F806F5;
        mem[632] = 32'hF202E2F4;
        mem[633] = 32'hF31EE918;
        mem[634] = 32'h1B0E192B;
        mem[635] = 32'hEBF3EFF0;
        mem[636] = 32'h06021200;
        mem[637] = 32'hEA10F317;
        mem[638] = 32'hFBFDFCFC;
        mem[639] = 32'hFF0702FD;
        mem[640] = 32'h0D0B0B05;
        mem[641] = 32'hF5090C0B;
        mem[642] = 32'h10030D0E;
        mem[643] = 32'h1710ED14;
        mem[644] = 32'hF83EFDE1;
        mem[645] = 32'hE808F624;
        mem[646] = 32'hF10EF908;
        mem[647] = 32'hF10CE924;
        mem[648] = 32'hF5F4F2E6;
        mem[649] = 32'h00E728EB;
        mem[650] = 32'h03FDFE21;
        mem[651] = 32'h0A1C0312;
        mem[652] = 32'h0927ECFB;
        mem[653] = 32'h0A1A0312;
        mem[654] = 32'hF3ED00E7;
        mem[655] = 32'hFBE1F8F4;
        mem[656] = 32'h3308DEE8;
        mem[657] = 32'h26DC0D0E;
        mem[658] = 32'hE7D92518;
        mem[659] = 32'h17F107EE;
        mem[660] = 32'hE31E1AF5;
        mem[661] = 32'hFA07E7F3;
        mem[662] = 32'h1F12FDD9;
        mem[663] = 32'h24F129F3;
        mem[664] = 32'hFC10D8DB;
        mem[665] = 32'h07FBF7EC;
        mem[666] = 32'h02C8FB0C;
        mem[667] = 32'hE208DE1E;
        mem[668] = 32'hEB0F0CCF;
        mem[669] = 32'h08030814;
        mem[670] = 32'h2C1D06DB;
        mem[671] = 32'hF8DC22E3;
        mem[672] = 32'h0223EEDC;
        mem[673] = 32'h1F041D02;
        mem[674] = 32'h04F9050C;
        mem[675] = 32'hEB0A07FB;
        mem[676] = 32'h0BFFF0DB;
        mem[677] = 32'h0408FB1B;
        mem[678] = 32'h170EFED0;
        mem[679] = 32'hF7C907FE;
        mem[680] = 32'hFF39F1F9;
        mem[681] = 32'h1C0A04FE;
        mem[682] = 32'hED01E92A;
        mem[683] = 32'h000701F5;
        mem[684] = 32'h3FECFC00;
        mem[685] = 32'hD5E0F10B;
        mem[686] = 32'h170500CD;
        mem[687] = 32'h1DE8EBE0;
        mem[688] = 32'hFE14E3E2;
        mem[689] = 32'h03D8080E;
        mem[690] = 32'hF1E1EC04;
        mem[691] = 32'h1CFAFEF8;
        mem[692] = 32'h17D604DA;
        mem[693] = 32'hECF8EB1C;
        mem[694] = 32'h0EEDFCE5;
        mem[695] = 32'h54DB010F;
        mem[696] = 32'hEEFFF6E8;
        mem[697] = 32'hF51D0EF4;
        mem[698] = 32'h25F5DFF7;
        mem[699] = 32'hFA17F815;
        mem[700] = 32'h080F1206;
        mem[701] = 32'hEE1CE3F8;
        mem[702] = 32'h13DC1602;
        mem[703] = 32'h32EDDCF7;
        mem[704] = 32'h0EFF210F;
        mem[705] = 32'hD8FF0AFB;
        mem[706] = 32'h0904E617;
        mem[707] = 32'h0F1306F9;
        mem[708] = 32'hEEF5E5DA;
        mem[709] = 32'hE5E71001;
        mem[710] = 32'h06D207DA;
        mem[711] = 32'h1012F7D1;
        mem[712] = 32'hF4DB1EF6;
        mem[713] = 32'hFBE1DE02;
        mem[714] = 32'hE413E3FD;
        mem[715] = 32'hFB110716;
        mem[716] = 32'h092316F1;
        mem[717] = 32'hDE0EEDE4;
        mem[718] = 32'h13F923FA;
        mem[719] = 32'hFF31F207;
        mem[720] = 32'h02DC12EE;
        mem[721] = 32'hF9EF0D0A;
        mem[722] = 32'hEC07E9F3;
        mem[723] = 32'h0A0AF9FD;
        mem[724] = 32'h0020E8F2;
        mem[725] = 32'hE9F2FE23;
        mem[726] = 32'hFDF90EF0;
        mem[727] = 32'hDC1302E1;
        mem[728] = 32'h06FF180A;
        mem[729] = 32'h041C0A1A;
        mem[730] = 32'hDB2AEA12;
        mem[731] = 32'h06DFEC1F;
        mem[732] = 32'h01DBFBEF;
        mem[733] = 32'hF8E7FE27;
        mem[734] = 32'h09110C09;
        mem[735] = 32'hE2F21BF1;
        mem[736] = 32'h0CFD190C;
        mem[737] = 32'h14FB2013;
        mem[738] = 32'hDA28FA23;
        mem[739] = 32'hFE0007FD;
        mem[740] = 32'h2015E5F5;
        mem[741] = 32'hE3030C03;
        mem[742] = 32'h090204FE;
        mem[743] = 32'hDA202709;
        mem[744] = 32'h1407DBFD;
        mem[745] = 32'h12F7E616;
        mem[746] = 32'hE119FEF8;
        mem[747] = 32'h05130D07;
        mem[748] = 32'hFF130A08;
        mem[749] = 32'hF3F60A25;
        mem[750] = 32'h0009FE08;
        mem[751] = 32'h08FE39F8;
        mem[752] = 32'hFBFDDDF6;
        mem[753] = 32'hF120DE0A;
        mem[754] = 32'hFD1405F1;
        mem[755] = 32'hF3F5ECF5;
        mem[756] = 32'h04F50907;
        mem[757] = 32'hFAFC0509;
        mem[758] = 32'h08140A05;
        mem[759] = 32'hFF0E2CCC;
        mem[760] = 32'h0117F4F8;
        mem[761] = 32'h1DFE0208;
        mem[762] = 32'h0B151F13;
        mem[763] = 32'hFD04D3F9;
        mem[764] = 32'h0AF9241D;
        mem[765] = 32'hF4F6EE11;
        mem[766] = 32'hFB1D0F0F;
        mem[767] = 32'hFCF63CDC;
        mem[768] = 32'hF91BF5EE;
        mem[769] = 32'h19E4FDF3;
        mem[770] = 32'hEDEEF827;
        mem[771] = 32'hFCFDF8F9;
        mem[772] = 32'hF20012F9;
        mem[773] = 32'h06E9F522;
        mem[774] = 32'hE7EEF3FA;
        mem[775] = 32'h02CE190D;
        mem[776] = 32'hF60FF9E2;
        mem[777] = 32'h0C20DA13;
        mem[778] = 32'hFC05F6FB;
        mem[779] = 32'hFB020A11;
        mem[780] = 32'h010D0A03;
        mem[781] = 32'h0C06F41E;
        mem[782] = 32'hEB0509FF;
        mem[783] = 32'h1BF80FFB;
        mem[784] = 32'hFFEFFCED;
        mem[785] = 32'hFFDF00F1;
        mem[786] = 32'h0816010E;
        mem[787] = 32'h1D17010B;
        mem[788] = 32'hF7E6F30F;
        mem[789] = 32'hE8F1F800;
        mem[790] = 32'hFC100506;
        mem[791] = 32'hF4F3F3E0;
        mem[792] = 32'h0C060C15;
        mem[793] = 32'hFA0419F3;
        mem[794] = 32'hF1DB0E13;
        mem[795] = 32'hEEFBFDFC;
        mem[796] = 32'hEDE7FA18;
        mem[797] = 32'hDDF8E1F9;
        mem[798] = 32'hFC02FCFF;
        mem[799] = 32'h06110C09;
        mem[800] = 32'h05FF03FA;
        mem[801] = 32'hDC0DFB1F;
        mem[802] = 32'h1A0A1B12;
        mem[803] = 32'hFCFA06E5;
        mem[804] = 32'hF927CCE2;
        mem[805] = 32'h070AE406;
        mem[806] = 32'hDFFC08F9;
        mem[807] = 32'h1BE8F9F4;
        mem[808] = 32'h14111007;
        mem[809] = 32'h0C17E915;
        mem[810] = 32'hFCF0060B;
        mem[811] = 32'h010D0004;
        mem[812] = 32'h160D17DB;
        mem[813] = 32'hE1EEE80D;
        mem[814] = 32'hEDDF0DEB;
        mem[815] = 32'h09DD12F3;
        mem[816] = 32'h34F1CAE6;
        mem[817] = 32'hEE15F506;
        mem[818] = 32'hE4D623E5;
        mem[819] = 32'h1CF7E4EE;
        mem[820] = 32'h1B0021D8;
        mem[821] = 32'hFCEFF622;
        mem[822] = 32'h3B2E19D8;
        mem[823] = 32'h03E63310;
        mem[824] = 32'h1524DDEA;
        mem[825] = 32'hF2FDFAF9;
        mem[826] = 32'hEBD50C1C;
        mem[827] = 32'h140401F7;
        mem[828] = 32'h00F014D3;
        mem[829] = 32'hDD080711;
        mem[830] = 32'h240800C3;
        mem[831] = 32'h04ED34F8;
        mem[832] = 32'hF122DADE;
        mem[833] = 32'hED070505;
        mem[834] = 32'hFDE10700;
        mem[835] = 32'hE60901E6;
        mem[836] = 32'h32D00707;
        mem[837] = 32'hF90BE4FD;
        mem[838] = 32'h241806D3;
        mem[839] = 32'h04E62403;
        mem[840] = 32'h0E3F02EA;
        mem[841] = 32'h220AFFE0;
        mem[842] = 32'h03E5F013;
        mem[843] = 32'h14E20914;
        mem[844] = 32'h2FF9FCCF;
        mem[845] = 32'hF508F4EB;
        mem[846] = 32'h1A0203CD;
        mem[847] = 32'h37D606D3;
        mem[848] = 32'hF413EEDE;
        mem[849] = 32'h181508F5;
        mem[850] = 32'h03BDE2F0;
        mem[851] = 32'h0F001D0C;
        mem[852] = 32'h4B0EFA0C;
        mem[853] = 32'hE6F80CFA;
        mem[854] = 32'h0DE2FCEB;
        mem[855] = 32'h5CCA02D3;
        mem[856] = 32'hF7EC03FB;
        mem[857] = 32'h1F0EE5FD;
        mem[858] = 32'h1CE6F008;
        mem[859] = 32'hE6EFE2F9;
        mem[860] = 32'h23150AF4;
        mem[861] = 32'h0C111810;
        mem[862] = 32'h15CB12FA;
        mem[863] = 32'h4EDF0CD3;
        mem[864] = 32'hE0F91EF4;
        mem[865] = 32'h05032011;
        mem[866] = 32'h1C22ED11;
        mem[867] = 32'hEC1020F8;
        mem[868] = 32'hFFFBE4EF;
        mem[869] = 32'h04F901F8;
        mem[870] = 32'h13E52AF8;
        mem[871] = 32'h150809F1;
        mem[872] = 32'hEEE10DFC;
        mem[873] = 32'h07110EE1;
        mem[874] = 32'hEC10D0F7;
        mem[875] = 32'h0CFCF412;
        mem[876] = 32'hDDFADD04;
        mem[877] = 32'hF800FDF4;
        mem[878] = 32'h0EF82BFB;
        mem[879] = 32'h0330F2ED;
        mem[880] = 32'h0CE508EF;
        mem[881] = 32'h1F080C0C;
        mem[882] = 32'hE814F8FD;
        mem[883] = 32'h0EE8F71C;
        mem[884] = 32'hF512FCFE;
        mem[885] = 32'hECE2F90E;
        mem[886] = 32'hFC0415FD;
        mem[887] = 32'hE219EFE2;
        mem[888] = 32'hE80B19FE;
        mem[889] = 32'hFBFA1C0A;
        mem[890] = 32'hF6330102;
        mem[891] = 32'h00F3FFFE;
        mem[892] = 32'hE5ECE2E6;
        mem[893] = 32'hEAFE011F;
        mem[894] = 32'hF3F8F3EF;
        mem[895] = 32'hD32530E5;
        mem[896] = 32'hF5F80EE6;
        mem[897] = 32'hFD21FBF8;
        mem[898] = 32'hD2281516;
        mem[899] = 32'hFDEFE827;
        mem[900] = 32'h1B001CE8;
        mem[901] = 32'hEDDE0020;
        mem[902] = 32'h09FFFA05;
        mem[903] = 32'hD12B16E3;
        mem[904] = 32'h2303EFF1;
        mem[905] = 32'hFAFCEAEF;
        mem[906] = 32'hD410FBEE;
        mem[907] = 32'hF70C05ED;
        mem[908] = 32'hE9CFF00D;
        mem[909] = 32'hF0FD0E11;
        mem[910] = 32'h0A190216;
        mem[911] = 32'hD60A13FB;
        mem[912] = 32'h140CF4F3;
        mem[913] = 32'h03F201FF;
        mem[914] = 32'hE6F70314;
        mem[915] = 32'h100CE501;
        mem[916] = 32'hF4FD29FF;
        mem[917] = 32'h18020715;
        mem[918] = 32'hFE1C0910;
        mem[919] = 32'hE1DF2402;
        mem[920] = 32'h0B26F9E5;
        mem[921] = 32'h250DE328;
        mem[922] = 32'hF5F0F829;
        mem[923] = 32'hFC0BDE13;
        mem[924] = 32'hE9CE2D13;
        mem[925] = 32'hF215F416;
        mem[926] = 32'hE9FBF5E6;
        mem[927] = 32'hF4EC4000;
        mem[928] = 32'h0D27EDD2;
        mem[929] = 32'hF5F6DF26;
        mem[930] = 32'h00F907FD;
        mem[931] = 32'hF9E5EF03;
        mem[932] = 32'h17E20F04;
        mem[933] = 32'h02FB0A05;
        mem[934] = 32'hFDFD0B07;
        mem[935] = 32'h03D83206;
        mem[936] = 32'h04280DF1;
        mem[937] = 32'hF8ECE80E;
        mem[938] = 32'hF5E90005;
        mem[939] = 32'h14F2E60D;
        mem[940] = 32'hE3CAF6E2;
        mem[941] = 32'hD309FC0F;
        mem[942] = 32'hEB02FD02;
        mem[943] = 32'hE70619E1;
        mem[944] = 32'h090C1107;
        mem[945] = 32'hF3FA09F7;
        mem[946] = 32'h1405F31C;
        mem[947] = 32'h170103FA;
        mem[948] = 32'hEED5EA14;
        mem[949] = 32'hE60AF130;
        mem[950] = 32'hF602FBF7;
        mem[951] = 32'hFFFB02EE;
        mem[952] = 32'h1104FD00;
        mem[953] = 32'h261706FA;
        mem[954] = 32'hF4DDFF3D;
        mem[955] = 32'hF7FEFE06;
        mem[956] = 32'h02EB091C;
        mem[957] = 32'hFAF1EC04;
        mem[958] = 32'h05090606;
        mem[959] = 32'h08100C07;
        mem[960] = 32'h16121505;
        mem[961] = 32'hFFFFF91A;
        mem[962] = 32'h0D000610;
        mem[963] = 32'hF7E0D7F6;
        mem[964] = 32'hF126E3EE;
        mem[965] = 32'hF7F7F70A;
        mem[966] = 32'hE6EDEDEB;
        mem[967] = 32'hFBF40104;
        mem[968] = 32'h040003EB;
        mem[969] = 32'h04F2FDDF;
        mem[970] = 32'h07FA141D;
        mem[971] = 32'h02070109;
        mem[972] = 32'h04020ED5;
        mem[973] = 32'h09F5E0E8;
        mem[974] = 32'hF50637D6;
        mem[975] = 32'hFCE80DF4;
        mem[976] = 32'h5F03D2F0;
        mem[977] = 32'hD6FD180F;
        mem[978] = 32'hE7DC2F1D;
        mem[979] = 32'h2AF2EAEA;
        mem[980] = 32'h23C212F2;
        mem[981] = 32'hF4FF0DF8;
        mem[982] = 32'h1B0B05A6;
        mem[983] = 32'h06D63A0B;
        mem[984] = 32'h0125D5DC;
        mem[985] = 32'hEA040709;
        mem[986] = 32'hE7E91E08;
        mem[987] = 32'h05F0F224;
        mem[988] = 32'h25D921EE;
        mem[989] = 32'hE3081124;
        mem[990] = 32'h2509F9AA;
        mem[991] = 32'h07C536E4;
        mem[992] = 32'hEA23D3CB;
        mem[993] = 32'hFB12F515;
        mem[994] = 32'hFBF612EF;
        mem[995] = 32'h0913F6E7;
        mem[996] = 32'h2511FBE9;
        mem[997] = 32'hDEF3F60C;
        mem[998] = 32'h371806CF;
        mem[999] = 32'h04F00F06;
        mem[1000] = 32'h0734DEE3;
        mem[1001] = 32'hE5FEF912;
        mem[1002] = 32'hFFFE0611;
        mem[1003] = 32'h14ED0900;
        mem[1004] = 32'h2FEADF07;
        mem[1005] = 32'h0A02FF14;
        mem[1006] = 32'h30170BD7;
        mem[1007] = 32'h23DCF3DE;
        mem[1008] = 32'h041BF5F6;
        mem[1009] = 32'hF01B010F;
        mem[1010] = 32'h23EAF10B;
        mem[1011] = 32'hFEFEEA04;
        mem[1012] = 32'h1CEAF2FB;
        mem[1013] = 32'hD2FE020D;
        mem[1014] = 32'h2BF212F8;
        mem[1015] = 32'h55C4FC0D;
        mem[1016] = 32'h01FD0EF6;
        mem[1017] = 32'hE504EE1B;
        mem[1018] = 32'h26E9F8F1;
        mem[1019] = 32'hFE0DEB21;
        mem[1020] = 32'h140D00DD;
        mem[1021] = 32'hED09EFFC;
        mem[1022] = 32'h24CA21F4;
        mem[1023] = 32'h46D40FE9;
        mem[1024] = 32'hE6E109F8;
        mem[1025] = 32'hEE04EFE8;
        mem[1026] = 32'h0F1EEBF7;
        mem[1027] = 32'hFDFF1E06;
        mem[1028] = 32'hED0FEF03;
        mem[1029] = 32'hEFEFF21E;
        mem[1030] = 32'h0ED626CE;
        mem[1031] = 32'h1E0FF9E1;
        mem[1032] = 32'h05D517EA;
        mem[1033] = 32'h0AF8F1F6;
        mem[1034] = 32'h1226F105;
        mem[1035] = 32'hFFD6F0F9;
        mem[1036] = 32'hE4330C16;
        mem[1037] = 32'hF5E81015;
        mem[1038] = 32'h0CF51D04;
        mem[1039] = 32'hED3BFFE0;
        mem[1040] = 32'hFDF11D14;
        mem[1041] = 32'hEAE806F7;
        mem[1042] = 32'h0D39031E;
        mem[1043] = 32'h13E8F61C;
        mem[1044] = 32'h1A08FB0A;
        mem[1045] = 32'hE5E51427;
        mem[1046] = 32'hFC011BEF;
        mem[1047] = 32'hC20203F3;
        mem[1048] = 32'hEF04220F;
        mem[1049] = 32'h0AF6FDF3;
        mem[1050] = 32'hE219ECEE;
        mem[1051] = 32'h0F0A0304;
        mem[1052] = 32'hFED0FAF8;
        mem[1053] = 32'hFFEBF8F1;
        mem[1054] = 32'h0C0B0107;
        mem[1055] = 32'hF0152BE3;
        mem[1056] = 32'hFFF71E05;
        mem[1057] = 32'hDF0E1B0B;
        mem[1058] = 32'hEA230900;
        mem[1059] = 32'h00F6091C;
        mem[1060] = 32'hF6F40715;
        mem[1061] = 32'hE1D8FF27;
        mem[1062] = 32'h04F4F007;
        mem[1063] = 32'hD81720F7;
        mem[1064] = 32'h2623EEFA;
        mem[1065] = 32'h2025140B;
        mem[1066] = 32'hDC14FBFA;
        mem[1067] = 32'hF401F6FA;
        mem[1068] = 32'h19D7F817;
        mem[1069] = 32'h06FD1113;
        mem[1070] = 32'hE8F9D9E1;
        mem[1071] = 32'hD21F29F5;
        mem[1072] = 32'h101BF4FB;
        mem[1073] = 32'h0411FA0C;
        mem[1074] = 32'hF10A0721;
        mem[1075] = 32'h0218EF2F;
        mem[1076] = 32'h0CF520D7;
        mem[1077] = 32'h06F5F9FB;
        mem[1078] = 32'hF00FF2F5;
        mem[1079] = 32'hF0E030FD;
        mem[1080] = 32'h042EEED3;
        mem[1081] = 32'h1F01F0F4;
        mem[1082] = 32'hF4E5F307;
        mem[1083] = 32'hF5DBD60E;
        mem[1084] = 32'hEDE20DFD;
        mem[1085] = 32'hF1F2FE0B;
        mem[1086] = 32'hFA1403FC;
        mem[1087] = 32'hF1FA36FA;
        mem[1088] = 32'h042AF5F5;
        mem[1089] = 32'h0200D70E;
        mem[1090] = 32'hF8E20102;
        mem[1091] = 32'hFBEAE6FA;
        mem[1092] = 32'h04FD04FA;
        mem[1093] = 32'hF10EF019;
        mem[1094] = 32'hE5FC05FD;
        mem[1095] = 32'hE4C11FFA;
        mem[1096] = 32'h0A350FFC;
        mem[1097] = 32'hF008DD13;
        mem[1098] = 32'hFEF6FF24;
        mem[1099] = 32'hEFF9F80C;
        mem[1100] = 32'h1CEC1FE4;
        mem[1101] = 32'hE300F231;
        mem[1102] = 32'hEB0604F8;
        mem[1103] = 32'hF3003712;
        mem[1104] = 32'h000BFAF4;
        mem[1105] = 32'h17F60004;
        mem[1106] = 32'h0101FD18;
        mem[1107] = 32'h13FEF829;
        mem[1108] = 32'h19EA1027;
        mem[1109] = 32'hDA0BE119;
        mem[1110] = 32'hF808FBFC;
        mem[1111] = 32'h06050D08;
        mem[1112] = 32'hDEE4ED11;
        mem[1113] = 32'h11EAF6E3;
        mem[1114] = 32'hEAD7E207;
        mem[1115] = 32'hF7FDFEFE;
        mem[1116] = 32'hF4EE0826;
        mem[1117] = 32'hEFF3FE40;
        mem[1118] = 32'h030C0705;
        mem[1119] = 32'h040C0802;
        mem[1120] = 32'h0B0D0804;
        mem[1121] = 32'hE8021102;
        mem[1122] = 32'h08FD0A0F;
        mem[1123] = 32'h0EEEF0EE;
        mem[1124] = 32'hE217F8F4;
        mem[1125] = 32'hEE10F527;
        mem[1126] = 32'hDE1304EA;
        mem[1127] = 32'h06FDEAF4;
        mem[1128] = 32'h0E0708F5;
        mem[1129] = 32'h29031211;
        mem[1130] = 32'hFBF80626;
        mem[1131] = 32'hFA0C0D0B;
        mem[1132] = 32'h00D40FE7;
        mem[1133] = 32'h02ED1005;
        mem[1134] = 32'hECFE40D2;
        mem[1135] = 32'h1B0728F6;
        mem[1136] = 32'h52F4C0EA;
        mem[1137] = 32'hFFEEFBFA;
        mem[1138] = 32'hDEF43F0B;
        mem[1139] = 32'h3A0308F9;
        mem[1140] = 32'h2FC21DFA;
        mem[1141] = 32'h13180916;
        mem[1142] = 32'h302C1BBA;
        mem[1143] = 32'hE9D13D00;
        mem[1144] = 32'hFF33EEFB;
        mem[1145] = 32'hF6D8F40D;
        mem[1146] = 32'hE7DB290B;
        mem[1147] = 32'h15FA13F9;
        mem[1148] = 32'h1DED20E6;
        mem[1149] = 32'hD910FCF6;
        mem[1150] = 32'h3C1C11C5;
        mem[1151] = 32'h0FE34CF8;
        mem[1152] = 32'hE637DBF6;
        mem[1153] = 32'h140A0201;
        mem[1154] = 32'hEEEA150F;
        mem[1155] = 32'h13FE05ED;
        mem[1156] = 32'h1FF6ECED;
        mem[1157] = 32'hE7EFEB13;
        mem[1158] = 32'h33200ACD;
        mem[1159] = 32'h08ED220D;
        mem[1160] = 32'hFC32E7DA;
        mem[1161] = 32'h06F70006;
        mem[1162] = 32'h0CF50217;
        mem[1163] = 32'h08F301EE;
        mem[1164] = 32'h19CAD407;
        mem[1165] = 32'hD9FDEA1D;
        mem[1166] = 32'h2B0A0AB8;
        mem[1167] = 32'h1FCFF3FA;
        mem[1168] = 32'h070DE3E2;
        mem[1169] = 32'h1010F8EA;
        mem[1170] = 32'h24DEF5F2;
        mem[1171] = 32'h1607FAEE;
        mem[1172] = 32'h29180104;
        mem[1173] = 32'hFC100D00;
        mem[1174] = 32'h31F019DC;
        mem[1175] = 32'h4DD606D0;
        mem[1176] = 32'hF00C24FB;
        mem[1177] = 32'hD90413F5;
        mem[1178] = 32'h3FEB02EC;
        mem[1179] = 32'hF21AF5FE;
        mem[1180] = 32'h20F9F1F1;
        mem[1181] = 32'hE208F10D;
        mem[1182] = 32'h25C41BF0;
        mem[1183] = 32'h49CB0FDB;
        mem[1184] = 32'hE5E419F9;
        mem[1185] = 32'hEC0B040D;
        mem[1186] = 32'h0A19E303;
        mem[1187] = 32'hF5FCF903;
        mem[1188] = 32'hF229E70E;
        mem[1189] = 32'hD9F6020A;
        mem[1190] = 32'h22EC29DA;
        mem[1191] = 32'h1F07FCD6;
        mem[1192] = 32'hEDF32901;
        mem[1193] = 32'h22EDECF2;
        mem[1194] = 32'h022BE906;
        mem[1195] = 32'h0AE90414;
        mem[1196] = 32'h16FADC1C;
        mem[1197] = 32'h0802221F;
        mem[1198] = 32'hF7EC1DE8;
        mem[1199] = 32'hFB2BFDE8;
        mem[1200] = 32'h0EF01F0E;
        mem[1201] = 32'hFBF201FD;
        mem[1202] = 32'hFB2DEC0C;
        mem[1203] = 32'h1DE8E8F5;
        mem[1204] = 32'hF3EDF5F3;
        mem[1205] = 32'h1C00143D;
        mem[1206] = 32'hF6121BF3;
        mem[1207] = 32'hE1131905;
        mem[1208] = 32'hCFED0610;
        mem[1209] = 32'h191A0EFA;
        mem[1210] = 32'hF43D021B;
        mem[1211] = 32'h0FF00D18;
        mem[1212] = 32'hEE05F908;
        mem[1213] = 32'hF9040636;
        mem[1214] = 32'h04FCFC09;
        mem[1215] = 32'hD11315F1;
        mem[1216] = 32'hF91007EB;
        mem[1217] = 32'hE201FAF9;
        mem[1218] = 32'hDA400C22;
        mem[1219] = 32'hF1F2E101;
        mem[1220] = 32'h240618F3;
        mem[1221] = 32'hF5021AF7;
        mem[1222] = 32'h07F9E8FF;
        mem[1223] = 32'hDF221BF0;
        mem[1224] = 32'h1D24E90C;
        mem[1225] = 32'hF9FFEFE9;
        mem[1226] = 32'hDB180A01;
        mem[1227] = 32'h18001829;
        mem[1228] = 32'h0BEBFC21;
        mem[1229] = 32'hEAE80515;
        mem[1230] = 32'h0814F903;
        mem[1231] = 32'hCAF914EE;
        mem[1232] = 32'hF225DCE9;
        mem[1233] = 32'hFAE0041A;
        mem[1234] = 32'hECFF01F7;
        mem[1235] = 32'h0403FF15;
        mem[1236] = 32'h0EE50706;
        mem[1237] = 32'h17FDFD25;
        mem[1238] = 32'hED08F0FA;
        mem[1239] = 32'hF1EA2CF0;
        mem[1240] = 32'h062EF2E4;
        mem[1241] = 32'h150BECF1;
        mem[1242] = 32'hFC050E1F;
        mem[1243] = 32'hFDE7E701;
        mem[1244] = 32'h08DE1ADC;
        mem[1245] = 32'hFAE4052D;
        mem[1246] = 32'hE3F5E8CE;
        mem[1247] = 32'hE4EA35E9;
        mem[1248] = 32'h0A3A13EA;
        mem[1249] = 32'hFCF4090B;
        mem[1250] = 32'hEEF4F906;
        mem[1251] = 32'h08E7072C;
        mem[1252] = 32'hF5EDFE0A;
        mem[1253] = 32'h09ECFA30;
        mem[1254] = 32'hEFF80DE7;
        mem[1255] = 32'hEEEE4009;
        mem[1256] = 32'h06300CF4;
        mem[1257] = 32'hEF0AEAF0;
        mem[1258] = 32'hE1DBF410;
        mem[1259] = 32'h19050429;
        mem[1260] = 32'h07F701F9;
        mem[1261] = 32'hE816113D;
        mem[1262] = 32'hE6FFFCE7;
        mem[1263] = 32'hDFF723DC;
        mem[1264] = 32'hEAFAEBE4;
        mem[1265] = 32'h0D1FF4F7;
        mem[1266] = 32'hF1EFE93B;
        mem[1267] = 32'h16E40427;
        mem[1268] = 32'hEECEEB23;
        mem[1269] = 32'hEDF8E73A;
        mem[1270] = 32'hF813070A;
        mem[1271] = 32'h09040906;
        mem[1272] = 32'hFAF9FB0E;
        mem[1273] = 32'hFB01F1FD;
        mem[1274] = 32'h0CE1F62C;
        mem[1275] = 32'hF803FD07;
        mem[1276] = 32'hEBF9022B;
        mem[1277] = 32'hDAF9FA1C;
        mem[1278] = 32'h000802FA;
        mem[1279] = 32'hFC04FF00;
        mem[1280] = 32'h04FA00F9;
        mem[1281] = 32'hFEE4FF11;
        mem[1282] = 32'hF5E7F1EA;
        mem[1283] = 32'hFFF7F114;
        mem[1284] = 32'hF6281AEB;
        mem[1285] = 32'hE1FDE9FC;
        mem[1286] = 32'h0CFD1018;
        mem[1287] = 32'h0A00E303;
        mem[1288] = 32'h13FC0BF1;
        mem[1289] = 32'h0DFB0C16;
        mem[1290] = 32'hF6EF0812;
        mem[1291] = 32'hF50A0404;
        mem[1292] = 32'h15EC1BCF;
        mem[1293] = 32'h070C0A12;
        mem[1294] = 32'hCA0A2BDD;
        mem[1295] = 32'hECD210E4;
        mem[1296] = 32'h5005E10E;
        mem[1297] = 32'h0EFB01F0;
        mem[1298] = 32'hD0CD1F09;
        mem[1299] = 32'h26FB06E8;
        mem[1300] = 32'h4C9D04F3;
        mem[1301] = 32'hF8EAECFB;
        mem[1302] = 32'h231C19A8;
        mem[1303] = 32'hEBE549F9;
        mem[1304] = 32'hFF25EEEE;
        mem[1305] = 32'h08E8F8FB;
        mem[1306] = 32'hE3EA221E;
        mem[1307] = 32'h110B0C1D;
        mem[1308] = 32'h2CF020FD;
        mem[1309] = 32'hF9F30205;
        mem[1310] = 32'h2A0D07AB;
        mem[1311] = 32'hF1AB31E5;
        mem[1312] = 32'hE949E7FF;
        mem[1313] = 32'h0B0EFF01;
        mem[1314] = 32'hE9EB0FFE;
        mem[1315] = 32'h0F00F004;
        mem[1316] = 32'h15E2FDF9;
        mem[1317] = 32'hEC03EA02;
        mem[1318] = 32'h332913B9;
        mem[1319] = 32'h11E026DC;
        mem[1320] = 32'h0C3DCEDF;
        mem[1321] = 32'h0D06FA05;
        mem[1322] = 32'h01F7FFF1;
        mem[1323] = 32'h01F8EEEF;
        mem[1324] = 32'h32CFE9F1;
        mem[1325] = 32'hE30CFE1E;
        mem[1326] = 32'h411A15C7;
        mem[1327] = 32'h27D608EE;
        mem[1328] = 32'h111F04F7;
        mem[1329] = 32'h02EF051E;
        mem[1330] = 32'h2EFD0D00;
        mem[1331] = 32'h07FFFA00;
        mem[1332] = 32'h09EFDDF8;
        mem[1333] = 32'hE30CF810;
        mem[1334] = 32'h22DB07EC;
        mem[1335] = 32'h4DE00BE8;
        mem[1336] = 32'hF1203304;
        mem[1337] = 32'h0506EF0F;
        mem[1338] = 32'h27DFECF6;
        mem[1339] = 32'h031AF9FF;
        mem[1340] = 32'h25E7D904;
        mem[1341] = 32'hF5FCE609;
        mem[1342] = 32'h2CB21DE0;
        mem[1343] = 32'h3BD1100A;
        mem[1344] = 32'hF4DF410E;
        mem[1345] = 32'h0013F6E4;
        mem[1346] = 32'h1607DFF0;
        mem[1347] = 32'h0B1F11F1;
        mem[1348] = 32'hEC0CE316;
        mem[1349] = 32'hFEF7142B;
        mem[1350] = 32'h17DE1DD3;
        mem[1351] = 32'h0D0AFBE1;
        mem[1352] = 32'hFFDB2B0A;
        mem[1353] = 32'hE7DF15EF;
        mem[1354] = 32'hFE1ADCF9;
        mem[1355] = 32'h24F509FE;
        mem[1356] = 32'h0629F60B;
        mem[1357] = 32'hEE0D0522;
        mem[1358] = 32'hF0EB16F5;
        mem[1359] = 32'hE92C0001;
        mem[1360] = 32'hFACF1C0A;
        mem[1361] = 32'h1C0E27F8;
        mem[1362] = 32'hF226E402;
        mem[1363] = 32'h19FEFC00;
        mem[1364] = 32'h08EFF717;
        mem[1365] = 32'hFA041619;
        mem[1366] = 32'hFFF508F3;
        mem[1367] = 32'hD2140805;
        mem[1368] = 32'h01092F21;
        mem[1369] = 32'h0213DDFA;
        mem[1370] = 32'hEA34F8EE;
        mem[1371] = 32'h05FFFAEE;
        mem[1372] = 32'hF2FEE912;
        mem[1373] = 32'hF40E0EF2;
        mem[1374] = 32'h0B060BFA;
        mem[1375] = 32'hD20E0BF5;
        mem[1376] = 32'hF9100205;
        mem[1377] = 32'h0DF91212;
        mem[1378] = 32'hCD2A02EE;
        mem[1379] = 32'h0D0BFDE4;
        mem[1380] = 32'h12E61928;
        mem[1381] = 32'hF2FE03FA;
        mem[1382] = 32'h0EF1EBF1;
        mem[1383] = 32'hE11A1103;
        mem[1384] = 32'h1F36F415;
        mem[1385] = 32'h00290916;
        mem[1386] = 32'hE7290918;
        mem[1387] = 32'h140515FD;
        mem[1388] = 32'h0405120F;
        mem[1389] = 32'hFFD80D21;
        mem[1390] = 32'h0914EF04;
        mem[1391] = 32'hDB121CF4;
        mem[1392] = 32'hFC26E4E5;
        mem[1393] = 32'hD90BFE0C;
        mem[1394] = 32'h06181706;
        mem[1395] = 32'hF9FF0C13;
        mem[1396] = 32'hEBD709DE;
        mem[1397] = 32'h01DF0436;
        mem[1398] = 32'hEF0FEAE8;
        mem[1399] = 32'hFAED2FFB;
        mem[1400] = 32'hFB31F2E7;
        mem[1401] = 32'hF5F71EFD;
        mem[1402] = 32'hFCFC02F6;
        mem[1403] = 32'hFBECFB12;
        mem[1404] = 32'h140BFE0E;
        mem[1405] = 32'hE2EFE31D;
        mem[1406] = 32'hF90C00EA;
        mem[1407] = 32'hF5D22EF8;
        mem[1408] = 32'h023004D4;
        mem[1409] = 32'hFDF9F9E8;
        mem[1410] = 32'hFC040C19;
        mem[1411] = 32'h01FE0507;
        mem[1412] = 32'hF7EF27E5;
        mem[1413] = 32'hF3E40C1C;
        mem[1414] = 32'h00FB07F7;
        mem[1415] = 32'hECD12D0C;
        mem[1416] = 32'hE732F7EF;
        mem[1417] = 32'hF2E50B05;
        mem[1418] = 32'h00EEFB0F;
        mem[1419] = 32'hF1F0F909;
        mem[1420] = 32'h110C1CDD;
        mem[1421] = 32'hECE6DF1A;
        mem[1422] = 32'hF01311EA;
        mem[1423] = 32'hE9ED36D7;
        mem[1424] = 32'h111E05F9;
        mem[1425] = 32'h0A0BF2F9;
        mem[1426] = 32'h07E40212;
        mem[1427] = 32'h04E0F817;
        mem[1428] = 32'h01FA0B2E;
        mem[1429] = 32'hEEF40710;
        mem[1430] = 32'hFB140508;
        mem[1431] = 32'hF2F4FBFE;
        mem[1432] = 32'h1418FC14;
        mem[1433] = 32'h01F70EF5;
        mem[1434] = 32'h12D9131D;
        mem[1435] = 32'hF0F6FAFA;
        mem[1436] = 32'hF2EDFB06;
        mem[1437] = 32'hF1EA0933;
        mem[1438] = 32'hF0FCF5ED;
        mem[1439] = 32'hFB06FDFE;
        mem[1440] = 32'h08FC06F7;
        mem[1441] = 32'h03F51511;
        mem[1442] = 32'hF8EDF9F0;
        mem[1443] = 32'h01EB0315;
        mem[1444] = 32'hE80518E2;
        mem[1445] = 32'hF903FD24;
        mem[1446] = 32'h171B1AF6;
        mem[1447] = 32'h260B0A0A;
        mem[1448] = 32'h0FFF03E2;
        mem[1449] = 32'hEA0BE2FC;
        mem[1450] = 32'hF7EFFB23;
        mem[1451] = 32'hF8010012;
        mem[1452] = 32'h1EF11EDD;
        mem[1453] = 32'hFE16FE11;
        mem[1454] = 32'hF2054FFD;
        mem[1455] = 32'hF80027E5;
        mem[1456] = 32'h3FEEE108;
        mem[1457] = 32'h000AF7FF;
        mem[1458] = 32'hD4DB3115;
        mem[1459] = 32'h1C10F0F6;
        mem[1460] = 32'h53B41BF1;
        mem[1461] = 32'hFE14EC1B;
        mem[1462] = 32'h1E0F07AE;
        mem[1463] = 32'h0FE15FFE;
        mem[1464] = 32'hEF1CE2E6;
        mem[1465] = 32'hDDFDF815;
        mem[1466] = 32'hEDF0402C;
        mem[1467] = 32'h10F8052D;
        mem[1468] = 32'h19C31715;
        mem[1469] = 32'hE7112415;
        mem[1470] = 32'h34170CC5;
        mem[1471] = 32'h0EBA3CF8;
        mem[1472] = 32'hDE47F3EA;
        mem[1473] = 32'hDF1510E7;
        mem[1474] = 32'hFAE61307;
        mem[1475] = 32'h0E01F804;
        mem[1476] = 32'h29EA0BFE;
        mem[1477] = 32'hE3F1F328;
        mem[1478] = 32'h160CF9A1;
        mem[1479] = 32'h090836F2;
        mem[1480] = 32'h064AE1E1;
        mem[1481] = 32'h1215F3F9;
        mem[1482] = 32'hEBF0F4F8;
        mem[1483] = 32'hF9F7E8FF;
        mem[1484] = 32'h32EAEFF4;
        mem[1485] = 32'hE000F822;
        mem[1486] = 32'h1AF5FCB4;
        mem[1487] = 32'h1DD4EBDB;
        mem[1488] = 32'hF3F1E303;
        mem[1489] = 32'hEDFFFB20;
        mem[1490] = 32'h10E0F0E6;
        mem[1491] = 32'h070CEEF3;
        mem[1492] = 32'h31F4DB0E;
        mem[1493] = 32'hF2170619;
        mem[1494] = 32'h12D80CE3;
        mem[1495] = 32'h52EA110A;
        mem[1496] = 32'hEB031EFA;
        mem[1497] = 32'hF7FF10EE;
        mem[1498] = 32'h1ED5E2F3;
        mem[1499] = 32'hF718E9E5;
        mem[1500] = 32'h1AFBEBD8;
        mem[1501] = 32'hDC070DF9;
        mem[1502] = 32'h3EC734F1;
        mem[1503] = 32'h33C90FDE;
        mem[1504] = 32'hE3DD4306;
        mem[1505] = 32'hFBF3D905;
        mem[1506] = 32'h1F15EFF2;
        mem[1507] = 32'h0B0D08F5;
        mem[1508] = 32'h0822ECE7;
        mem[1509] = 32'hFEEA0516;
        mem[1510] = 32'h13DB1DD8;
        mem[1511] = 32'h1A0A02FE;
        mem[1512] = 32'hF4D63307;
        mem[1513] = 32'hF809EFEA;
        mem[1514] = 32'hFE1DF4EE;
        mem[1515] = 32'h08E5F70E;
        mem[1516] = 32'hFC2DE6FA;
        mem[1517] = 32'hE904F9FF;
        mem[1518] = 32'hFEFC22DB;
        mem[1519] = 32'hEB3507E7;
        mem[1520] = 32'hE6C60403;
        mem[1521] = 32'hF60E06ED;
        mem[1522] = 32'h0233E901;
        mem[1523] = 32'h18F102FD;
        mem[1524] = 32'h02D7F009;
        mem[1525] = 32'hE8EAFC1A;
        mem[1526] = 32'hFB0124FA;
        mem[1527] = 32'hF31B20E6;
        mem[1528] = 32'h010E2405;
        mem[1529] = 32'h08011710;
        mem[1530] = 32'hD72AE6E9;
        mem[1531] = 32'h13FF0F01;
        mem[1532] = 32'h04EF051F;
        mem[1533] = 32'hE6F1F613;
        mem[1534] = 32'h02F7FCF7;
        mem[1535] = 32'hE60F1FF6;
        mem[1536] = 32'hD7FFF2FB;
        mem[1537] = 32'h01000113;
        mem[1538] = 32'hD43B0DFF;
        mem[1539] = 32'hF0E8E7DB;
        mem[1540] = 32'h0E0AFFED;
        mem[1541] = 32'h05FF1DFE;
        mem[1542] = 32'h18F4F00A;
        mem[1543] = 32'hE50DFA10;
        mem[1544] = 32'h081FD009;
        mem[1545] = 32'hE5040029;
        mem[1546] = 32'hD217FFF5;
        mem[1547] = 32'h16F70E04;
        mem[1548] = 32'h12DF23F5;
        mem[1549] = 32'hFEECF926;
        mem[1550] = 32'h0E12F30D;
        mem[1551] = 32'hD326110C;
        mem[1552] = 32'hFC36DEF9;
        mem[1553] = 32'h1F070D16;
        mem[1554] = 32'hE90C05FA;
        mem[1555] = 32'hF8060402;
        mem[1556] = 32'h11E70BF4;
        mem[1557] = 32'h06D60B2E;
        mem[1558] = 32'hF313FBDE;
        mem[1559] = 32'hD5E326F5;
        mem[1560] = 32'hF8300DE1;
        mem[1561] = 32'hFF090D1D;
        mem[1562] = 32'hF000FFFB;
        mem[1563] = 32'h04F5E802;
        mem[1564] = 32'h0AE0160B;
        mem[1565] = 32'hD9F3E823;
        mem[1566] = 32'hF8110B07;
        mem[1567] = 32'hFDE23CEA;
        mem[1568] = 32'hF53818D9;
        mem[1569] = 32'h120DE40A;
        mem[1570] = 32'hFFF604F3;
        mem[1571] = 32'h0605FF0A;
        mem[1572] = 32'h1BECFA0F;
        mem[1573] = 32'hE605F31E;
        mem[1574] = 32'hFE00FFE7;
        mem[1575] = 32'hFEE540F1;
        mem[1576] = 32'hDE24EED7;
        mem[1577] = 32'hEEEF060B;
        mem[1578] = 32'hF6FEFCF6;
        mem[1579] = 32'h18F80DFF;
        mem[1580] = 32'hF100000D;
        mem[1581] = 32'hF8D8F724;
        mem[1582] = 32'h061813CC;
        mem[1583] = 32'hF3F13F0A;
        mem[1584] = 32'h0226F7EE;
        mem[1585] = 32'hEA0B13DA;
        mem[1586] = 32'h04F20614;
        mem[1587] = 32'h14FC0812;
        mem[1588] = 32'hFCE0F911;
        mem[1589] = 32'hEEE41329;
        mem[1590] = 32'hE606F2F4;
        mem[1591] = 32'h090B191A;
        mem[1592] = 32'hF91AFDEF;
        mem[1593] = 32'hEE05F90B;
        mem[1594] = 32'hE3C6F3FA;
        mem[1595] = 32'hE7F6E6EC;
        mem[1596] = 32'hFCE8FC0C;
        mem[1597] = 32'hD9DE071B;
        mem[1598] = 32'hEFFEF6F4;
        mem[1599] = 32'hFC0CFDFF;
        mem[1600] = 32'h0A030AF5;
        mem[1601] = 32'h0C0922EF;
        mem[1602] = 32'h03FE000F;
        mem[1603] = 32'hF6E20110;
        mem[1604] = 32'hE21819D4;
        mem[1605] = 32'h111BFF04;
        mem[1606] = 32'h0FFBE7F9;
        mem[1607] = 32'h19F7FFF8;
        mem[1608] = 32'h180608EC;
        mem[1609] = 32'h10F1FDF9;
        mem[1610] = 32'hEFFE0321;
        mem[1611] = 32'hE5F6FD05;
        mem[1612] = 32'h22EF1FD3;
        mem[1613] = 32'hF51BE727;
        mem[1614] = 32'hE50728F3;
        mem[1615] = 32'hE90D0817;
        mem[1616] = 32'h4B01DEFF;
        mem[1617] = 32'hF70AF3F6;
        mem[1618] = 32'hDBED4315;
        mem[1619] = 32'h0CF0F6F9;
        mem[1620] = 32'h4FAD0CED;
        mem[1621] = 32'hDE1AFE0A;
        mem[1622] = 32'h22171EAC;
        mem[1623] = 32'h16D65202;
        mem[1624] = 32'h0937F2FD;
        mem[1625] = 32'h16FD04FB;
        mem[1626] = 32'hD1D81704;
        mem[1627] = 32'hF8ECF229;
        mem[1628] = 32'h19CA0806;
        mem[1629] = 32'hE0F10D03;
        mem[1630] = 32'h241504B8;
        mem[1631] = 32'hFEC438E6;
        mem[1632] = 32'hB833DED5;
        mem[1633] = 32'hFBF10C17;
        mem[1634] = 32'hE5ED1009;
        mem[1635] = 32'h12F0EF1B;
        mem[1636] = 32'h1CE9DFF6;
        mem[1637] = 32'hE3150F1B;
        mem[1638] = 32'h220D01AB;
        mem[1639] = 32'h09F224DC;
        mem[1640] = 32'h0536DEDF;
        mem[1641] = 32'h29DEE1FD;
        mem[1642] = 32'hF7FD0D06;
        mem[1643] = 32'h100EFD09;
        mem[1644] = 32'h31FBD409;
        mem[1645] = 32'hE110F637;
        mem[1646] = 32'h330F12BB;
        mem[1647] = 32'h3FF60EED;
        mem[1648] = 32'hFDF9ED19;
        mem[1649] = 32'hED0C01D7;
        mem[1650] = 32'h04EAF0E2;
        mem[1651] = 32'h03F0F3DD;
        mem[1652] = 32'h2EE5FD05;
        mem[1653] = 32'hED0BFF01;
        mem[1654] = 32'h30EE18EC;
        mem[1655] = 32'h36C1F3FB;
        mem[1656] = 32'hEE1036E4;
        mem[1657] = 32'h16F4DA0E;
        mem[1658] = 32'h2FE8F6EB;
        mem[1659] = 32'hF51FEFF0;
        mem[1660] = 32'h1BEEE803;
        mem[1661] = 32'hDC00EF17;
        mem[1662] = 32'h3AD03704;
        mem[1663] = 32'h56E427EB;
        mem[1664] = 32'hE5E74E09;
        mem[1665] = 32'hEF13F8EE;
        mem[1666] = 32'h2607F4EB;
        mem[1667] = 32'hFF27FFE7;
        mem[1668] = 32'h0312E50C;
        mem[1669] = 32'hD7EAF316;
        mem[1670] = 32'h31EA32CB;
        mem[1671] = 32'h160F0B0E;
        mem[1672] = 32'hEFEA3617;
        mem[1673] = 32'hF1F408D8;
        mem[1674] = 32'h0814E9E1;
        mem[1675] = 32'h13EEF6F8;
        mem[1676] = 32'h01FEE22B;
        mem[1677] = 32'h02091319;
        mem[1678] = 32'h03FB21DE;
        mem[1679] = 32'hF131FEEB;
        mem[1680] = 32'hF2DB1210;
        mem[1681] = 32'h081BEDF2;
        mem[1682] = 32'hFF1CDDFF;
        mem[1683] = 32'h05E7FBF8;
        mem[1684] = 32'h12EFF8EE;
        mem[1685] = 32'hF2F5050E;
        mem[1686] = 32'hEEF70FE7;
        mem[1687] = 32'hDA1A03F0;
        mem[1688] = 32'hED061C15;
        mem[1689] = 32'hEC010408;
        mem[1690] = 32'hEA2CFCF8;
        mem[1691] = 32'hF7EDF2DF;
        mem[1692] = 32'h0CFB2306;
        mem[1693] = 32'hF1040E0D;
        mem[1694] = 32'h09FA03F9;
        mem[1695] = 32'hE607FC14;
        mem[1696] = 32'hE619F9FA;
        mem[1697] = 32'h00EC180B;
        mem[1698] = 32'hCC2BF704;
        mem[1699] = 32'h100D01FD;
        mem[1700] = 32'h0DFC1B15;
        mem[1701] = 32'h0DD80323;
        mem[1702] = 32'h20FCF520;
        mem[1703] = 32'hF40FFDFF;
        mem[1704] = 32'h181FDEFD;
        mem[1705] = 32'h23FCF31D;
        mem[1706] = 32'hEC2D190C;
        mem[1707] = 32'hF9F3FCF1;
        mem[1708] = 32'h00C911FE;
        mem[1709] = 32'hE4DA0215;
        mem[1710] = 32'h070AE70A;
        mem[1711] = 32'hD4FE1302;
        mem[1712] = 32'hFB29DEED;
        mem[1713] = 32'h1600D8FE;
        mem[1714] = 32'hD2FAF2FB;
        mem[1715] = 32'h01090504;
        mem[1716] = 32'hE6E828FB;
        mem[1717] = 32'h01F6021E;
        mem[1718] = 32'h062102DD;
        mem[1719] = 32'hF0F32705;
        mem[1720] = 32'hFE4A07E0;
        mem[1721] = 32'h031A0816;
        mem[1722] = 32'hF3F8FFF9;
        mem[1723] = 32'h090007F6;
        mem[1724] = 32'h01E727FD;
        mem[1725] = 32'h0DF00E32;
        mem[1726] = 32'h052119DC;
        mem[1727] = 32'hF70140F2;
        mem[1728] = 32'hD422FBD3;
        mem[1729] = 32'h02F30208;
        mem[1730] = 32'hFB000CF4;
        mem[1731] = 32'hFBE9F6EC;
        mem[1732] = 32'h08060D17;
        mem[1733] = 32'hF0E30725;
        mem[1734] = 32'h1F150FE2;
        mem[1735] = 32'hF3D747F0;
        mem[1736] = 32'hFE3DF8EE;
        mem[1737] = 32'hEB0C05F1;
        mem[1738] = 32'h02070E0D;
        mem[1739] = 32'h0EF1FDFE;
        mem[1740] = 32'h1BF30313;
        mem[1741] = 32'h0FEC1E2D;
        mem[1742] = 32'h04170701;
        mem[1743] = 32'hF5DF3211;
        mem[1744] = 32'hF029E7D4;
        mem[1745] = 32'h1F1BF6E4;
        mem[1746] = 32'h14FD2407;
        mem[1747] = 32'hF7FE01FB;
        mem[1748] = 32'h06EB0132;
        mem[1749] = 32'hDCED0211;
        mem[1750] = 32'hF9170A14;
        mem[1751] = 32'hE9F6FF07;
        mem[1752] = 32'h0123F6D7;
        mem[1753] = 32'hFF0A2602;
        mem[1754] = 32'h08EA1510;
        mem[1755] = 32'hF2EEF0EB;
        mem[1756] = 32'h06F9042B;
        mem[1757] = 32'hFFF3131D;
        mem[1758] = 32'hFF0F0301;
        mem[1759] = 32'hF30CFAFC;
        mem[1760] = 32'h05F8FEF3;
        mem[1761] = 32'h1AF5F6F0;
        mem[1762] = 32'hFCEDF113;
        mem[1763] = 32'hFAE8091A;
        mem[1764] = 32'hEB1C2ADB;
        mem[1765] = 32'hFB14E620;
        mem[1766] = 32'hFA07EA00;
        mem[1767] = 32'h1217F6F0;
        mem[1768] = 32'h200B17F0;
        mem[1769] = 32'hF60D1305;
        mem[1770] = 32'hE0EDEB16;
        mem[1771] = 32'hE8F7FF03;
        mem[1772] = 32'h1CED15D4;
        mem[1773] = 32'hFA10EBE3;
        mem[1774] = 32'hD60723C2;
        mem[1775] = 32'h0DD506F0;
        mem[1776] = 32'h2CF2C806;
        mem[1777] = 32'h0409F602;
        mem[1778] = 32'hE1D6331E;
        mem[1779] = 32'h09F7EB0A;
        mem[1780] = 32'h3BB5F4EC;
        mem[1781] = 32'hD3F6E71F;
        mem[1782] = 32'h2A1912AB;
        mem[1783] = 32'hEEC92AEA;
        mem[1784] = 32'hF725E3FA;
        mem[1785] = 32'hED15E6E3;
        mem[1786] = 32'hF1E83220;
        mem[1787] = 32'hF7F5FA22;
        mem[1788] = 32'h0DC41603;
        mem[1789] = 32'hF0F9151B;
        mem[1790] = 32'h322A17B3;
        mem[1791] = 32'h0FB0400E;
        mem[1792] = 32'hC939F1E3;
        mem[1793] = 32'h0E0E08F3;
        mem[1794] = 32'h00021A1D;
        mem[1795] = 32'h1011F327;
        mem[1796] = 32'h24F0F6E3;
        mem[1797] = 32'hFBF70C10;
        mem[1798] = 32'h311D0CA7;
        mem[1799] = 32'hF0EB11DA;
        mem[1800] = 32'hF439D0F3;
        mem[1801] = 32'hDD102200;
        mem[1802] = 32'hF502020A;
        mem[1803] = 32'h0415EE0A;
        mem[1804] = 32'h25E0EA04;
        mem[1805] = 32'hC708F4FB;
        mem[1806] = 32'h2701F8B2;
        mem[1807] = 32'h25EEF90F;
        mem[1808] = 32'h161C130C;
        mem[1809] = 32'h111E10F5;
        mem[1810] = 32'h2E081707;
        mem[1811] = 32'h0904F5FF;
        mem[1812] = 32'h30F2F113;
        mem[1813] = 32'hD1020A1E;
        mem[1814] = 32'h2CE80EDB;
        mem[1815] = 32'h34DAFDF6;
        mem[1816] = 32'hE6FA32F9;
        mem[1817] = 32'hF0FBDAEF;
        mem[1818] = 32'h21E0F1E8;
        mem[1819] = 32'hF5FEE2E7;
        mem[1820] = 32'h2105DBFB;
        mem[1821] = 32'hC802F218;
        mem[1822] = 32'h40D334EB;
        mem[1823] = 32'h39CA1FEC;
        mem[1824] = 32'hDEF45309;
        mem[1825] = 32'hF0ECFCDA;
        mem[1826] = 32'h1210E4F1;
        mem[1827] = 32'hF316F2F0;
        mem[1828] = 32'h1005F60B;
        mem[1829] = 32'hE80DF204;
        mem[1830] = 32'h1FD71DE1;
        mem[1831] = 32'h180904FA;
        mem[1832] = 32'hFADC4A1C;
        mem[1833] = 32'hEAF6EC25;
        mem[1834] = 32'h071EEEEE;
        mem[1835] = 32'h11F80601;
        mem[1836] = 32'hDF10DF0B;
        mem[1837] = 32'hEDED0129;
        mem[1838] = 32'hFAF71AD7;
        mem[1839] = 32'hF027040C;
        mem[1840] = 32'h07F52704;
        mem[1841] = 32'hEF08FC0B;
        mem[1842] = 32'hF328E6EF;
        mem[1843] = 32'h05EEFDFD;
        mem[1844] = 32'h10ECD91C;
        mem[1845] = 32'hE5E0FDFC;
        mem[1846] = 32'hF3F80EF1;
        mem[1847] = 32'hE91700FB;
        mem[1848] = 32'hE9FB0C0B;
        mem[1849] = 32'hE823160F;
        mem[1850] = 32'hD62EF3DF;
        mem[1851] = 32'h01F103ED;
        mem[1852] = 32'hF9FAF717;
        mem[1853] = 32'h05F5FC38;
        mem[1854] = 32'h0BFC0E0C;
        mem[1855] = 32'hEE1A0FD7;
        mem[1856] = 32'hF91009FF;
        mem[1857] = 32'h12F706FD;
        mem[1858] = 32'hE3320601;
        mem[1859] = 32'h05FB04FC;
        mem[1860] = 32'hFDFB08FB;
        mem[1861] = 32'hE6E802FB;
        mem[1862] = 32'h16F1ED18;
        mem[1863] = 32'hE203F51A;
        mem[1864] = 32'h1B24E418;
        mem[1865] = 32'h12EBE6E3;
        mem[1866] = 32'hC52507F9;
        mem[1867] = 32'h00F906F4;
        mem[1868] = 32'hFDCA03FA;
        mem[1869] = 32'h02F11820;
        mem[1870] = 32'h04FEEA06;
        mem[1871] = 32'hD2011309;
        mem[1872] = 32'hFF2EE211;
        mem[1873] = 32'hEC07FA08;
        mem[1874] = 32'hF618101D;
        mem[1875] = 32'hFD03F2F8;
        mem[1876] = 32'h00E502FA;
        mem[1877] = 32'hE4EAEC1D;
        mem[1878] = 32'hF71003F5;
        mem[1879] = 32'hF3FA3C1C;
        mem[1880] = 32'hEB3BF6F5;
        mem[1881] = 32'hFA07F6FE;
        mem[1882] = 32'hF80F0A03;
        mem[1883] = 32'h0D111007;
        mem[1884] = 32'h030409E4;
        mem[1885] = 32'hFAF7F833;
        mem[1886] = 32'hFE1D15C8;
        mem[1887] = 32'hE4F1240C;
        mem[1888] = 32'hDB24FDE1;
        mem[1889] = 32'hE3D90D13;
        mem[1890] = 32'h060809FF;
        mem[1891] = 32'hFFEF01E5;
        mem[1892] = 32'hF4020010;
        mem[1893] = 32'hF2DDFF2C;
        mem[1894] = 32'h1B0700D3;
        mem[1895] = 32'hF1C81AF0;
        mem[1896] = 32'hF72CF0ED;
        mem[1897] = 32'h020DEE04;
        mem[1898] = 32'h01060807;
        mem[1899] = 32'h04EC0301;
        mem[1900] = 32'h13171DF1;
        mem[1901] = 32'hE5DA0516;
        mem[1902] = 32'h0C2116E0;
        mem[1903] = 32'h05DF4613;
        mem[1904] = 32'hF734E6FA;
        mem[1905] = 32'h0AD9F811;
        mem[1906] = 32'h03FB0807;
        mem[1907] = 32'h03F200FA;
        mem[1908] = 32'h0BF40919;
        mem[1909] = 32'h03EC0916;
        mem[1910] = 32'hEE0EFF01;
        mem[1911] = 32'hF70A0100;
        mem[1912] = 32'h210FFC07;
        mem[1913] = 32'h200F2026;
        mem[1914] = 32'hFFDBFC00;
        mem[1915] = 32'hF3F0ECEC;
        mem[1916] = 32'h09FB051D;
        mem[1917] = 32'hE5E61B23;
        mem[1918] = 32'hFF0F0305;
        mem[1919] = 32'hEC00F1F4;
        mem[1920] = 32'h17041207;
        mem[1921] = 32'h00F9E417;
        mem[1922] = 32'h0601FA2C;
        mem[1923] = 32'h1405241D;
        mem[1924] = 32'hEB051CEE;
        mem[1925] = 32'hF2FEF5F0;
        mem[1926] = 32'h1808F20C;
        mem[1927] = 32'h16F30509;
        mem[1928] = 32'h1F0E11E3;
        mem[1929] = 32'hECF2E71A;
        mem[1930] = 32'hEEFBFA24;
        mem[1931] = 32'hE101020B;
        mem[1932] = 32'h1EFD20F3;
        mem[1933] = 32'h0318EA1E;
        mem[1934] = 32'hFA1D31CE;
        mem[1935] = 32'hFEF610FE;
        mem[1936] = 32'h28EECFFE;
        mem[1937] = 32'h0306D812;
        mem[1938] = 32'hC9CF3321;
        mem[1939] = 32'h0CFCEE1A;
        mem[1940] = 32'h3FAEFFF6;
        mem[1941] = 32'hD8270923;
        mem[1942] = 32'h302120C3;
        mem[1943] = 32'h16D23F03;
        mem[1944] = 32'h0333E2F4;
        mem[1945] = 32'hF8030A10;
        mem[1946] = 32'hE9E0291A;
        mem[1947] = 32'hFBE0EE2A;
        mem[1948] = 32'h28C93AF4;
        mem[1949] = 32'hE1FBF208;
        mem[1950] = 32'h363A1EBF;
        mem[1951] = 32'h0ABD39FF;
        mem[1952] = 32'hDF4D0204;
        mem[1953] = 32'hE5041EF4;
        mem[1954] = 32'hEBE8FE0B;
        mem[1955] = 32'h08F5F21D;
        mem[1956] = 32'h1CE6EF1A;
        mem[1957] = 32'hCDEBE2F8;
        mem[1958] = 32'h29190DCC;
        mem[1959] = 32'hF2F20F00;
        mem[1960] = 32'hFC4BF1F7;
        mem[1961] = 32'h0A1D1913;
        mem[1962] = 32'hEDFC02F4;
        mem[1963] = 32'h01F7E7FD;
        mem[1964] = 32'h29D9ECF4;
        mem[1965] = 32'hF1FFFF19;
        mem[1966] = 32'h20FEFEBD;
        mem[1967] = 32'h13EAE4EF;
        mem[1968] = 32'h040FFE0C;
        mem[1969] = 32'hEC04FB0D;
        mem[1970] = 32'h170E0202;
        mem[1971] = 32'h0A00F6FC;
        mem[1972] = 32'h35EDF112;
        mem[1973] = 32'hC319F413;
        mem[1974] = 32'h1AE907E9;
        mem[1975] = 32'h46E91AE7;
        mem[1976] = 32'hE0FF2AF5;
        mem[1977] = 32'hD711F9FA;
        mem[1978] = 32'h3CEF06FA;
        mem[1979] = 32'h0914F9F6;
        mem[1980] = 32'h2801DA1A;
        mem[1981] = 32'hD117F42E;
        mem[1982] = 32'h22BC22CE;
        mem[1983] = 32'h20B502D4;
        mem[1984] = 32'hD5EF4F01;
        mem[1985] = 32'hFA0C0A12;
        mem[1986] = 32'h2822F3FD;
        mem[1987] = 32'hFA27FCFC;
        mem[1988] = 32'hFF0FF326;
        mem[1989] = 32'hEA01F610;
        mem[1990] = 32'h1DD425CC;
        mem[1991] = 32'h23030AE7;
        mem[1992] = 32'hE0CE28EE;
        mem[1993] = 32'h07010113;
        mem[1994] = 32'h0725F7EE;
        mem[1995] = 32'h0FFF09FF;
        mem[1996] = 32'hF1F9E6EF;
        mem[1997] = 32'hF1F005EA;
        mem[1998] = 32'h080A2800;
        mem[1999] = 32'hF01CF70E;
        mem[2000] = 32'hF8E51E1A;
        mem[2001] = 32'hFF0FF217;
        mem[2002] = 32'h051CEE04;
        mem[2003] = 32'h1BEE130C;
        mem[2004] = 32'h05F4EE04;
        mem[2005] = 32'hFAF1050C;
        mem[2006] = 32'hF0F40FE6;
        mem[2007] = 32'hFB0C0AF3;
        mem[2008] = 32'hE30009F6;
        mem[2009] = 32'hE408E8DB;
        mem[2010] = 32'hCC1CE8DD;
        mem[2011] = 32'h1AF40E04;
        mem[2012] = 32'hF9D505F4;
        mem[2013] = 32'h09F11222;
        mem[2014] = 32'h06FC0F11;
        mem[2015] = 32'hEE1F1516;
        mem[2016] = 32'hF41102F3;
        mem[2017] = 32'h0300EC07;
        mem[2018] = 32'hD018F8EC;
        mem[2019] = 32'h140302F8;
        mem[2020] = 32'hF4F7F7F2;
        mem[2021] = 32'hFFE40507;
        mem[2022] = 32'h1DFFF803;
        mem[2023] = 32'hE807FF02;
        mem[2024] = 32'h1109DCF5;
        mem[2025] = 32'hF41A000A;
        mem[2026] = 32'hD11801F6;
        mem[2027] = 32'hF4FF0002;
        mem[2028] = 32'h04EA121D;
        mem[2029] = 32'h0BEC171B;
        mem[2030] = 32'hFBFDEC11;
        mem[2031] = 32'hDC131906;
        mem[2032] = 32'h0A2BFAF8;
        mem[2033] = 32'h0CF80906;
        mem[2034] = 32'hEB0CFA02;
        mem[2035] = 32'hEDFAF3EA;
        mem[2036] = 32'h06DF1DF3;
        mem[2037] = 32'hF3F60B1D;
        mem[2038] = 32'h041107CE;
        mem[2039] = 32'hDDDA2500;
        mem[2040] = 32'hDF2AEAED;
        mem[2041] = 32'hF9DC0CF9;
        mem[2042] = 32'hEAFCF5EF;
        mem[2043] = 32'hFCFFFAF6;
        mem[2044] = 32'hF5FF04EC;
        mem[2045] = 32'hF2ECF722;
        mem[2046] = 32'hFB12FEC7;
        mem[2047] = 32'hEAE133F0;
        mem[2048] = 32'hE337FEED;
        mem[2049] = 32'h03FD14DB;
        mem[2050] = 32'hEEEBEFE0;
        mem[2051] = 32'h0EFE0402;
        mem[2052] = 32'hFFEAF011;
        mem[2053] = 32'hDBD10007;
        mem[2054] = 32'h1E1200E8;
        mem[2055] = 32'h04FA3AF0;
        mem[2056] = 32'hF728EAD1;
        mem[2057] = 32'h1A1AFAED;
        mem[2058] = 32'h040D10FF;
        mem[2059] = 32'h0CF001FD;
        mem[2060] = 32'h0DF7E40C;
        mem[2061] = 32'hDAE0002E;
        mem[2062] = 32'h040CFFD4;
        mem[2063] = 32'hE9EB23ED;
        mem[2064] = 32'hFF35E9EC;
        mem[2065] = 32'h0414260E;
        mem[2066] = 32'h00EB15F1;
        mem[2067] = 32'h0C001007;
        mem[2068] = 32'hF9EB0401;
        mem[2069] = 32'hE4E7140E;
        mem[2070] = 32'hFB1B0D0E;
        mem[2071] = 32'hF6FC08FE;
        mem[2072] = 32'h1409F8DA;
        mem[2073] = 32'hDE00FD0B;
        mem[2074] = 32'h1BF2100A;
        mem[2075] = 32'h0004FB0A;
        mem[2076] = 32'h0BF9001F;
        mem[2077] = 32'hFEE5212E;
        mem[2078] = 32'h061A0613;
        mem[2079] = 32'hF80EFA07;
        mem[2080] = 32'h0F080F00;
        mem[2081] = 32'hDC120807;
        mem[2082] = 32'h01F8F114;
        mem[2083] = 32'hEFFE0921;
        mem[2084] = 32'hEF0928E9;
        mem[2085] = 32'h0D0FF0FC;
        mem[2086] = 32'hF80DD8F0;
        mem[2087] = 32'hF1EA0D1E;
        mem[2088] = 32'h0F0308D7;
        mem[2089] = 32'hF9E109EA;
        mem[2090] = 32'hF9FE0234;
        mem[2091] = 32'hDFF2FB07;
        mem[2092] = 32'h0DEC12C6;
        mem[2093] = 32'hE40D030C;
        mem[2094] = 32'hD9020ED4;
        mem[2095] = 32'hF9DBFBEC;
        mem[2096] = 32'h2B04CEFD;
        mem[2097] = 32'hEE1DF006;
        mem[2098] = 32'hE8D43924;
        mem[2099] = 32'h0901E50A;
        mem[2100] = 32'h40CA09F3;
        mem[2101] = 32'hF913F615;
        mem[2102] = 32'h2F291FAF;
        mem[2103] = 32'h0ACA35FF;
        mem[2104] = 32'hFA28DDE9;
        mem[2105] = 32'hE8041CF1;
        mem[2106] = 32'hE9E2250D;
        mem[2107] = 32'h01F1EF3E;
        mem[2108] = 32'h0EDB17E9;
        mem[2109] = 32'hE70B0C18;
        mem[2110] = 32'h232CF6BA;
        mem[2111] = 32'h0ACD3E13;
        mem[2112] = 32'hD044F0ED;
        mem[2113] = 32'h190021D7;
        mem[2114] = 32'hD3E7080B;
        mem[2115] = 32'h0EF4FF31;
        mem[2116] = 32'h04D0D705;
        mem[2117] = 32'hDA12FC0E;
        mem[2118] = 32'h2B15FDAF;
        mem[2119] = 32'h0FFF1F13;
        mem[2120] = 32'hE742E5D6;
        mem[2121] = 32'hE611180E;
        mem[2122] = 32'hF3051210;
        mem[2123] = 32'hFBFDE902;
        mem[2124] = 32'h2CD9F502;
        mem[2125] = 32'hD311E914;
        mem[2126] = 32'h361C12CB;
        mem[2127] = 32'h19F4F6D5;
        mem[2128] = 32'h0E1502F9;
        mem[2129] = 32'hFEEC130C;
        mem[2130] = 32'h03F2F4F9;
        mem[2131] = 32'h1A240A0E;
        mem[2132] = 32'h2ED6FD1F;
        mem[2133] = 32'hD01D0324;
        mem[2134] = 32'h23EC09D5;
        mem[2135] = 32'h32DA08EB;
        mem[2136] = 32'hF1F52FFF;
        mem[2137] = 32'hE1EC07F1;
        mem[2138] = 32'h2AE5EEF5;
        mem[2139] = 32'h0922FD0C;
        mem[2140] = 32'h1BF2D708;
        mem[2141] = 32'hF60B0007;
        mem[2142] = 32'h29BD2BF4;
        mem[2143] = 32'h3ED029D7;
        mem[2144] = 32'hCEEB3B06;
        mem[2145] = 32'h1505DB10;
        mem[2146] = 32'h0A07DEE8;
        mem[2147] = 32'hE81BF1EF;
        mem[2148] = 32'hEC01E1FC;
        mem[2149] = 32'hDFEDF72F;
        mem[2150] = 32'h44F547EE;
        mem[2151] = 32'h280212F1;
        mem[2152] = 32'hD9CF3518;
        mem[2153] = 32'hFD080CF8;
        mem[2154] = 32'hFA15E4F4;
        mem[2155] = 32'h09FD0902;
        mem[2156] = 32'hFF1CEF11;
        mem[2157] = 32'hE7E51721;
        mem[2158] = 32'h08042BD3;
        mem[2159] = 32'hEC19EA12;
        mem[2160] = 32'hF4C72D14;
        mem[2161] = 32'hEF25F8E4;
        mem[2162] = 32'h0122E8F4;
        mem[2163] = 32'h19F31802;
        mem[2164] = 32'h11DEEF05;
        mem[2165] = 32'hF3FB0324;
        mem[2166] = 32'hEBFB11CA;
        mem[2167] = 32'hEB200AF2;
        mem[2168] = 32'hEDF610F3;
        mem[2169] = 32'h1AEBFFEB;
        mem[2170] = 32'hDD25E8E7;
        mem[2171] = 32'h15FE07F8;
        mem[2172] = 32'h0FF50C16;
        mem[2173] = 32'h0708071A;
        mem[2174] = 32'hFEF503EB;
        mem[2175] = 32'hEB17180D;
        mem[2176] = 32'hFF0E0505;
        mem[2177] = 32'hD6040816;
        mem[2178] = 32'hD51CF8F1;
        mem[2179] = 32'h04F9F8EC;
        mem[2180] = 32'hF5EE0611;
        mem[2181] = 32'h07EC181C;
        mem[2182] = 32'h10E1E909;
        mem[2183] = 32'hE606F91E;
        mem[2184] = 32'h0C12E0E0;
        mem[2185] = 32'hE4FF0FE6;
        mem[2186] = 32'hDA2A0DFA;
        mem[2187] = 32'h0C13180E;
        mem[2188] = 32'h08ED040D;
        mem[2189] = 32'hEEFE012A;
        mem[2190] = 32'h0605F0EA;
        mem[2191] = 32'hD8181C2E;
        mem[2192] = 32'hF825F6ED;
        mem[2193] = 32'hF12014F9;
        mem[2194] = 32'hE009FDF7;
        mem[2195] = 32'h01131216;
        mem[2196] = 32'h08EA0C09;
        mem[2197] = 32'hFED70C05;
        mem[2198] = 32'hF90502DD;
        mem[2199] = 32'hF30634D6;
        mem[2200] = 32'hDF33F602;
        mem[2201] = 32'h0325E6EB;
        mem[2202] = 32'hE6FFFDF5;
        mem[2203] = 32'hF40AF9F3;
        mem[2204] = 32'h0AF0F9E4;
        mem[2205] = 32'hFFEAFD3B;
        mem[2206] = 32'hF21700ED;
        mem[2207] = 32'hE0E12A04;
        mem[2208] = 32'hD930FCE0;
        mem[2209] = 32'hEBFAF90E;
        mem[2210] = 32'h010DFFFD;
        mem[2211] = 32'h100A0A09;
        mem[2212] = 32'h0204FEFD;
        mem[2213] = 32'hFC001B35;
        mem[2214] = 32'h0D0EF5DC;
        mem[2215] = 32'h14E93418;
        mem[2216] = 32'hEA16DCF3;
        mem[2217] = 32'hF820F904;
        mem[2218] = 32'h030D15FA;
        mem[2219] = 32'h18021305;
        mem[2220] = 32'hF3E8E715;
        mem[2221] = 32'h09ED1B34;
        mem[2222] = 32'hFC07F7E5;
        mem[2223] = 32'h0CE825E1;
        mem[2224] = 32'h0B3CFDE4;
        mem[2225] = 32'h1FF109F4;
        mem[2226] = 32'hF5D908E0;
        mem[2227] = 32'h05FA0AF9;
        mem[2228] = 32'hF7E1F008;
        mem[2229] = 32'hF9ED1732;
        mem[2230] = 32'h00180F04;
        mem[2231] = 32'hFDFC0408;
        mem[2232] = 32'h04F0F4F4;
        mem[2233] = 32'hFC09E90F;
        mem[2234] = 32'h16E306FF;
        mem[2235] = 32'h07050708;
        mem[2236] = 32'h00FEF509;
        mem[2237] = 32'hDFD1022F;
        mem[2238] = 32'hF90BFC06;
        mem[2239] = 32'hFA0EF502;
        mem[2240] = 32'h0CF509FD;
        mem[2241] = 32'hFB25EE05;
        mem[2242] = 32'hF4FDF10C;
        mem[2243] = 32'hF7FB0724;
        mem[2244] = 32'hF03038E3;
        mem[2245] = 32'hEB1E031E;
        mem[2246] = 32'h070805F5;
        mem[2247] = 32'h17FC0F0C;
        mem[2248] = 32'h200C16DD;
        mem[2249] = 32'hFB210FF8;
        mem[2250] = 32'hF0EAED18;
        mem[2251] = 32'hECFCFF20;
        mem[2252] = 32'h04E521D8;
        mem[2253] = 32'h001EF814;
        mem[2254] = 32'hF81634EF;
        mem[2255] = 32'hF2F507F4;
        mem[2256] = 32'h2DF4D117;
        mem[2257] = 32'hF9FCF908;
        mem[2258] = 32'hD9F02725;
        mem[2259] = 32'h0BEA0014;
        mem[2260] = 32'h55C40C04;
        mem[2261] = 32'hEC212106;
        mem[2262] = 32'h332718B0;
        mem[2263] = 32'h26E942F5;
        mem[2264] = 32'hF82BE6F5;
        mem[2265] = 32'h0ADB0209;
        mem[2266] = 32'hF2DB1A0F;
        mem[2267] = 32'h0BECF13E;
        mem[2268] = 32'h25E52FFF;
        mem[2269] = 32'hDFFEF128;
        mem[2270] = 32'h29370EB3;
        mem[2271] = 32'h05E23BF5;
        mem[2272] = 32'hD146EE19;
        mem[2273] = 32'h1425F8D8;
        mem[2274] = 32'hE2FA0814;
        mem[2275] = 32'hF2ECEA21;
        mem[2276] = 32'h12E4FED9;
        mem[2277] = 32'hDDF3F9F7;
        mem[2278] = 32'h281903B7;
        mem[2279] = 32'hFCF218E5;
        mem[2280] = 32'hEC4CF5FE;
        mem[2281] = 32'h0806F8E7;
        mem[2282] = 32'hFD000D07;
        mem[2283] = 32'h02FBEB1E;
        mem[2284] = 32'h3AEB0104;
        mem[2285] = 32'hE6101015;
        mem[2286] = 32'h291009C5;
        mem[2287] = 32'h25F702F9;
        mem[2288] = 32'h0D2A1514;
        mem[2289] = 32'h10F8FB20;
        mem[2290] = 32'h09E9F1EB;
        mem[2291] = 32'h0A180B01;
        mem[2292] = 32'h32EEF201;
        mem[2293] = 32'hF5210618;
        mem[2294] = 32'h17E808CE;
        mem[2295] = 32'h2DD50900;
        mem[2296] = 32'hEAF42FE6;
        mem[2297] = 32'hFB0A19E2;
        mem[2298] = 32'h35ED02F7;
        mem[2299] = 32'hFC24FEFB;
        mem[2300] = 32'h28FEE4F3;
        mem[2301] = 32'hD0F9060D;
        mem[2302] = 32'h29B21FD3;
        mem[2303] = 32'h2FBC17F3;
        mem[2304] = 32'hCBF34904;
        mem[2305] = 32'h061DF2F8;
        mem[2306] = 32'h0F00E2F0;
        mem[2307] = 32'h042F0203;
        mem[2308] = 32'hF207EFF1;
        mem[2309] = 32'hF3080425;
        mem[2310] = 32'h34E126B5;
        mem[2311] = 32'h1CF116EF;
        mem[2312] = 32'hF4ED3F05;
        mem[2313] = 32'h082708E0;
        mem[2314] = 32'h0527F101;
        mem[2315] = 32'hFCFE0AF6;
        mem[2316] = 32'hFD22FD04;
        mem[2317] = 32'hEDFDF916;
        mem[2318] = 32'h0F0228D1;
        mem[2319] = 32'hF8200101;
        mem[2320] = 32'hE9D8150A;
        mem[2321] = 32'hF0050B21;
        mem[2322] = 32'h0925F901;
        mem[2323] = 32'h16EC1005;
        mem[2324] = 32'hFEF1DC0E;
        mem[2325] = 32'h02FF0201;
        mem[2326] = 32'hFF0A20F0;
        mem[2327] = 32'hD40FF70A;
        mem[2328] = 32'hEAE616F3;
        mem[2329] = 32'h0AFEE600;
        mem[2330] = 32'hEB460903;
        mem[2331] = 32'h0CFD03F8;
        mem[2332] = 32'hF8E1F1FA;
        mem[2333] = 32'hF4CAF503;
        mem[2334] = 32'h09F7120B;
        mem[2335] = 32'hF4221CDE;
        mem[2336] = 32'hF203FBFE;
        mem[2337] = 32'h07082AFF;
        mem[2338] = 32'hD92108FB;
        mem[2339] = 32'h0BF5FAEA;
        mem[2340] = 32'hFD0F0A09;
        mem[2341] = 32'hE4F71602;
        mem[2342] = 32'h1AFBF6F5;
        mem[2343] = 32'hEF0C15E8;
        mem[2344] = 32'h14FBF0E7;
        mem[2345] = 32'h08140608;
        mem[2346] = 32'hD82D1100;
        mem[2347] = 32'hFC03FDF5;
        mem[2348] = 32'hF5E50EF8;
        mem[2349] = 32'hE1E4F90F;
        mem[2350] = 32'h0309F613;
        mem[2351] = 32'hCF0B12FA;
        mem[2352] = 32'hF11AEDEB;
        mem[2353] = 32'h11E6F3E8;
        mem[2354] = 32'hDB01FDFB;
        mem[2355] = 32'h15281F1F;
        mem[2356] = 32'h07E90B08;
        mem[2357] = 32'h10D6FA16;
        mem[2358] = 32'hF80B08E6;
        mem[2359] = 32'hFCF730FA;
        mem[2360] = 32'hE22CF8E1;
        mem[2361] = 32'hF1FBFF00;
        mem[2362] = 32'hF5110B03;
        mem[2363] = 32'hDEEEEBDD;
        mem[2364] = 32'hFF0B10F1;
        mem[2365] = 32'hE7EDFF26;
        mem[2366] = 32'h011707E5;
        mem[2367] = 32'hEAF0221D;
        mem[2368] = 32'hEE3C0DD9;
        mem[2369] = 32'hE9F507FF;
        mem[2370] = 32'h020809F2;
        mem[2371] = 32'h0AFA03F8;
        mem[2372] = 32'h18F8F6FF;
        mem[2373] = 32'hECCDF833;
        mem[2374] = 32'hFE17FCEA;
        mem[2375] = 32'hF9FA26E5;
        mem[2376] = 32'h0939F803;
        mem[2377] = 32'hF3EAEE0C;
        mem[2378] = 32'h0E111107;
        mem[2379] = 32'h02F502F9;
        mem[2380] = 32'hF1ED03F8;
        mem[2381] = 32'hFCEE0A0F;
        mem[2382] = 32'hF90AEFE1;
        mem[2383] = 32'h16EC381E;
        mem[2384] = 32'h0541FEDD;
        mem[2385] = 32'h07D6130F;
        mem[2386] = 32'h09E71B00;
        mem[2387] = 32'h0DF909F1;
        mem[2388] = 32'h0EFAFE06;
        mem[2389] = 32'hF7C80621;
        mem[2390] = 32'h04150509;
        mem[2391] = 32'hEDF7F305;
        mem[2392] = 32'h040804F3;
        mem[2393] = 32'hDB0EDFEC;
        mem[2394] = 32'h04E3FCE6;
        mem[2395] = 32'h04080004;
        mem[2396] = 32'hF6E8E707;
        mem[2397] = 32'hDCEC1532;
        mem[2398] = 32'hEEFDECF1;
        mem[2399] = 32'hECFEF1F9;
        mem[2400] = 32'hF5F1F8F2;
        mem[2401] = 32'hFE00FC01;
        mem[2402] = 32'hF4E9ED18;
        mem[2403] = 32'h02F4051F;
        mem[2404] = 32'hE4090ED2;
        mem[2405] = 32'h0B26F3E2;
        mem[2406] = 32'hE002150A;
        mem[2407] = 32'h171609F4;
        mem[2408] = 32'h0AF001CA;
        mem[2409] = 32'hE0010DFC;
        mem[2410] = 32'hF7EFFD28;
        mem[2411] = 32'hDC010016;
        mem[2412] = 32'h11FF24C2;
        mem[2413] = 32'hD603E210;
        mem[2414] = 32'hFE2231F2;
        mem[2415] = 32'hFADB13FC;
        mem[2416] = 32'h35FCD508;
        mem[2417] = 32'hDEF51BE9;
        mem[2418] = 32'hE6DE2B2A;
        mem[2419] = 32'h06E5E80F;
        mem[2420] = 32'h44C403FA;
        mem[2421] = 32'hF90108F5;
        mem[2422] = 32'h35281DA9;
        mem[2423] = 32'h0AD43307;
        mem[2424] = 32'hFB38DCEC;
        mem[2425] = 32'hFF08FDE9;
        mem[2426] = 32'hECD02419;
        mem[2427] = 32'hFBECE443;
        mem[2428] = 32'h16D5200B;
        mem[2429] = 32'hD904FA1C;
        mem[2430] = 32'h232F07A6;
        mem[2431] = 32'h0FCE33E9;
        mem[2432] = 32'hD44E01F4;
        mem[2433] = 32'hEFEB1216;
        mem[2434] = 32'hDFF9060D;
        mem[2435] = 32'h06E7F52B;
        mem[2436] = 32'h0BDFEFFC;
        mem[2437] = 32'hD9F0F711;
        mem[2438] = 32'h251BFA9A;
        mem[2439] = 32'hFFF513E1;
        mem[2440] = 32'hF84201F1;
        mem[2441] = 32'hEBF1EC1C;
        mem[2442] = 32'hF4F6EEF5;
        mem[2443] = 32'h0A09E00F;
        mem[2444] = 32'h20D5FDE4;
        mem[2445] = 32'hE50A0D18;
        mem[2446] = 32'h220DFFC0;
        mem[2447] = 32'h1C0809D9;
        mem[2448] = 32'hEB04F614;
        mem[2449] = 32'hF4050026;
        mem[2450] = 32'h0DE2EDE6;
        mem[2451] = 32'h0C0E07F8;
        mem[2452] = 32'h19D7EA0A;
        mem[2453] = 32'hE1190E17;
        mem[2454] = 32'h1EDBFFEC;
        mem[2455] = 32'h31DA0EFB;
        mem[2456] = 32'hE9E126E1;
        mem[2457] = 32'hFB25FC22;
        mem[2458] = 32'h20DEF0DF;
        mem[2459] = 32'hF015E7F2;
        mem[2460] = 32'h230EE7FE;
        mem[2461] = 32'hFE14FE1E;
        mem[2462] = 32'h35BD30D4;
        mem[2463] = 32'h28B0FFEB;
        mem[2464] = 32'hB4E324D7;
        mem[2465] = 32'h06E5040E;
        mem[2466] = 32'h28240608;
        mem[2467] = 32'hE71EF4F6;
        mem[2468] = 32'hFBF8F5EF;
        mem[2469] = 32'hE90DF8FC;
        mem[2470] = 32'h2AD823E6;
        mem[2471] = 32'h1AF70ED4;
        mem[2472] = 32'hEFF23DF7;
        mem[2473] = 32'h15FFF20B;
        mem[2474] = 32'h0C18FDFB;
        mem[2475] = 32'hEDF504F5;
        mem[2476] = 32'hF107E801;
        mem[2477] = 32'h04F0FB25;
        mem[2478] = 32'h0E0223D7;
        mem[2479] = 32'h0A25FEFB;
        mem[2480] = 32'hFFD5330D;
        mem[2481] = 32'h161EE1FE;
        mem[2482] = 32'h012E01FF;
        mem[2483] = 32'h04DFFDF3;
        mem[2484] = 32'h17E7DC1D;
        mem[2485] = 32'hEA05FB32;
        mem[2486] = 32'hECEF0EFE;
        mem[2487] = 32'hDC11FAEE;
        mem[2488] = 32'hF4E82212;
        mem[2489] = 32'hF7E7FBF2;
        mem[2490] = 32'h0447110C;
        mem[2491] = 32'h16F4FAEC;
        mem[2492] = 32'h1FE1FF02;
        mem[2493] = 32'h0ADE0810;
        mem[2494] = 32'h110921EF;
        mem[2495] = 32'hEF363001;
        mem[2496] = 32'h121A13F2;
        mem[2497] = 32'hDF11030B;
        mem[2498] = 32'hD911F2F3;
        mem[2499] = 32'h0CF503F7;
        mem[2500] = 32'hF512F8FA;
        mem[2501] = 32'h10E50F25;
        mem[2502] = 32'h02E7ECFB;
        mem[2503] = 32'hF3180D0D;
        mem[2504] = 32'h1001EF11;
        mem[2505] = 32'h03170F15;
        mem[2506] = 32'hD32A1004;
        mem[2507] = 32'hF50310FC;
        mem[2508] = 32'h0B050F0C;
        mem[2509] = 32'h02EAF621;
        mem[2510] = 32'h0009F912;
        mem[2511] = 32'hCB0B1E29;
        mem[2512] = 32'hF612F700;
        mem[2513] = 32'h2304E5FA;
        mem[2514] = 32'hF61708F6;
        mem[2515] = 32'hF1F0FAF5;
        mem[2516] = 32'h1FEE0906;
        mem[2517] = 32'hF9D7FF22;
        mem[2518] = 32'hFC1100EA;
        mem[2519] = 32'hF0ED15E2;
        mem[2520] = 32'hF63C02EE;
        mem[2521] = 32'hFE170000;
        mem[2522] = 32'hFA1608FD;
        mem[2523] = 32'hF8FFFEF0;
        mem[2524] = 32'hF902FB0B;
        mem[2525] = 32'hF4DC0E1D;
        mem[2526] = 32'hFB2115D3;
        mem[2527] = 32'h0AF328E4;
        mem[2528] = 32'hD62EFAE4;
        mem[2529] = 32'h29E5FB0A;
        mem[2530] = 32'h091313FC;
        mem[2531] = 32'h02EF06E8;
        mem[2532] = 32'h00ECFBEA;
        mem[2533] = 32'hFCE2052C;
        mem[2534] = 32'hFC10F6ED;
        mem[2535] = 32'hEED011ED;
        mem[2536] = 32'hF52EF6EF;
        mem[2537] = 32'h05EE0BE8;
        mem[2538] = 32'hFBFF06F2;
        mem[2539] = 32'h1E011505;
        mem[2540] = 32'hF1E0E1FD;
        mem[2541] = 32'hF1E50015;
        mem[2542] = 32'hF30BE9D8;
        mem[2543] = 32'h02DA0FDA;
        mem[2544] = 32'hEC1FE1CA;
        mem[2545] = 32'h1CF81DEE;
        mem[2546] = 32'h0CF618FA;
        mem[2547] = 32'h0EFBFD00;
        mem[2548] = 32'h0B070BFE;
        mem[2549] = 32'h04DB0F0E;
        mem[2550] = 32'hF605FFF2;
        mem[2551] = 32'hE7F6F2F0;
        mem[2552] = 32'h140CF50E;
        mem[2553] = 32'h08F3FDF5;
        mem[2554] = 32'h27F01404;
        mem[2555] = 32'h0110FF03;
        mem[2556] = 32'hFEF9F41D;
        mem[2557] = 32'hE5F5FE2B;
        mem[2558] = 32'hE7F2E2EE;
        mem[2559] = 32'h010DF805;
        mem[2560] = 32'h1B10140F;
        mem[2561] = 32'hF0F70B10;
        mem[2562] = 32'hF6F6EB13;
        mem[2563] = 32'hFFFF0735;
        mem[2564] = 32'hF42B35E2;
        mem[2565] = 32'hE70DE204;
        mem[2566] = 32'hEE06EB10;
        mem[2567] = 32'h181E0BDF;
        mem[2568] = 32'h0DF304CF;
        mem[2569] = 32'h080C22EB;
        mem[2570] = 32'hF8E9FE40;
        mem[2571] = 32'hD6010E26;
        mem[2572] = 32'h07F21DE4;
        mem[2573] = 32'hF423F203;
        mem[2574] = 32'h08FE24F3;
        mem[2575] = 32'hFFE911F9;
        mem[2576] = 32'h1DDDCCF5;
        mem[2577] = 32'h1312EC14;
        mem[2578] = 32'hE7DD2524;
        mem[2579] = 32'h0BF7F72A;
        mem[2580] = 32'h42BBFFDF;
        mem[2581] = 32'hEF22F9FE;
        mem[2582] = 32'h281B06AB;
        mem[2583] = 32'h00D429E5;
        mem[2584] = 32'hF938E4FE;
        mem[2585] = 32'hF029071C;
        mem[2586] = 32'hF3D41C27;
        mem[2587] = 32'h00CFDB35;
        mem[2588] = 32'h15F5F8DB;
        mem[2589] = 32'hFDF91DFF;
        mem[2590] = 32'h1A27FAAC;
        mem[2591] = 32'h22DD4401;
        mem[2592] = 32'hC147F2F6;
        mem[2593] = 32'hF50001FC;
        mem[2594] = 32'hE0F20F19;
        mem[2595] = 32'hF8E5E61A;
        mem[2596] = 32'h09091111;
        mem[2597] = 32'hE6FC031F;
        mem[2598] = 32'h0E0EEEA8;
        mem[2599] = 32'h05F917F5;
        mem[2600] = 32'hF9340602;
        mem[2601] = 32'hF60AE00F;
        mem[2602] = 32'h01020C1A;
        mem[2603] = 32'h01FDD81F;
        mem[2604] = 32'h13ECE9F7;
        mem[2605] = 32'hDC25FDF2;
        mem[2606] = 32'h1F1D11A2;
        mem[2607] = 32'h0D03FE00;
        mem[2608] = 32'hFB150715;
        mem[2609] = 32'h0409DD22;
        mem[2610] = 32'h08F1EAE4;
        mem[2611] = 32'h0B1BFF13;
        mem[2612] = 32'h15D0DE00;
        mem[2613] = 32'hDB17DD09;
        mem[2614] = 32'h28DA0AD9;
        mem[2615] = 32'h34DA09D5;
        mem[2616] = 32'hEDE73002;
        mem[2617] = 32'h0B07F219;
        mem[2618] = 32'h3AE301FD;
        mem[2619] = 32'hED15E4F8;
        mem[2620] = 32'h16F1E0E7;
        mem[2621] = 32'hE302EBFF;
        mem[2622] = 32'h39B92DFB;
        mem[2623] = 32'h32CE12E0;
        mem[2624] = 32'hC4E62DEF;
        mem[2625] = 32'h0B0CEBF7;
        mem[2626] = 32'h2010FCEE;
        mem[2627] = 32'hE731F0F3;
        mem[2628] = 32'hF7FEE8F3;
        mem[2629] = 32'h02F7F919;
        mem[2630] = 32'h35D91FB0;
        mem[2631] = 32'h24FA08DF;
        mem[2632] = 32'hFCED3F00;
        mem[2633] = 32'hE8EDEB0F;
        mem[2634] = 32'h1C330E08;
        mem[2635] = 32'hF8F413F3;
        mem[2636] = 32'hF119F915;
        mem[2637] = 32'hFAE70C17;
        mem[2638] = 32'h0CFE1CEC;
        mem[2639] = 32'h1D3F020F;
        mem[2640] = 32'hF2E52511;
        mem[2641] = 32'h0506EC14;
        mem[2642] = 32'hFF2EF602;
        mem[2643] = 32'h12E60508;
        mem[2644] = 32'h0FF2F310;
        mem[2645] = 32'h01DCF417;
        mem[2646] = 32'hECF518E6;
        mem[2647] = 32'hEA180808;
        mem[2648] = 32'hF0E612F7;
        mem[2649] = 32'h0301E900;
        mem[2650] = 32'hE72FFBED;
        mem[2651] = 32'h15EEFDF7;
        mem[2652] = 32'hFDE7F929;
        mem[2653] = 32'h05E40807;
        mem[2654] = 32'h08FE1310;
        mem[2655] = 32'hE02C1C05;
        mem[2656] = 32'h1B030805;
        mem[2657] = 32'hF8F7ECE7;
        mem[2658] = 32'hE120FEED;
        mem[2659] = 32'h1E0502F4;
        mem[2660] = 32'hED07F1F9;
        mem[2661] = 32'hDCE21915;
        mem[2662] = 32'h1106F3F9;
        mem[2663] = 32'hEB1E1DF0;
        mem[2664] = 32'hFD05F108;
        mem[2665] = 32'h1AED0700;
        mem[2666] = 32'hEB2F1103;
        mem[2667] = 32'h09031209;
        mem[2668] = 32'hF9EAFA21;
        mem[2669] = 32'hF3F8F228;
        mem[2670] = 32'h000EF6F6;
        mem[2671] = 32'hE80C0D0E;
        mem[2672] = 32'hE61FFFFB;
        mem[2673] = 32'h08FF17F3;
        mem[2674] = 32'hF7200A03;
        mem[2675] = 32'hDEF4FBF7;
        mem[2676] = 32'h1EE81F0F;
        mem[2677] = 32'h00E1F80C;
        mem[2678] = 32'h001C11F0;
        mem[2679] = 32'h00EC24F5;
        mem[2680] = 32'hE422F6E3;
        mem[2681] = 32'h091EFCD8;
        mem[2682] = 32'hF205FEF8;
        mem[2683] = 32'hF8FD07F2;
        mem[2684] = 32'hE7F5ED09;
        mem[2685] = 32'hF2CA051C;
        mem[2686] = 32'h0D301CE7;
        mem[2687] = 32'hFAE921FB;
        mem[2688] = 32'hE230FEE4;
        mem[2689] = 32'h0FE4FEF6;
        mem[2690] = 32'h041416FA;
        mem[2691] = 32'h08FF0DF8;
        mem[2692] = 32'hF2F208F1;
        mem[2693] = 32'h13DC0F42;
        mem[2694] = 32'hF81709F6;
        mem[2695] = 32'hF9F833DA;
        mem[2696] = 32'hF126F4DD;
        mem[2697] = 32'hFFE11FD7;
        mem[2698] = 32'h030B14FA;
        mem[2699] = 32'h11010CFF;
        mem[2700] = 32'h1211FE2F;
        mem[2701] = 32'hE9C2F52C;
        mem[2702] = 32'hF402EBDA;
        mem[2703] = 32'h13F12A0A;
        mem[2704] = 32'h0736EEDE;
        mem[2705] = 32'h0C10F3EC;
        mem[2706] = 32'h130212F1;
        mem[2707] = 32'h2B051914;
        mem[2708] = 32'hF7EDECFB;
        mem[2709] = 32'hDDF1011D;
        mem[2710] = 32'hF91506EB;
        mem[2711] = 32'hE9FAF7EE;
        mem[2712] = 32'hFA1705F2;
        mem[2713] = 32'hDBF822EB;
        mem[2714] = 32'h1DF70BF3;
        mem[2715] = 32'hF6F1EBED;
        mem[2716] = 32'hF6E8EB0E;
        mem[2717] = 32'hF9D30635;
        mem[2718] = 32'hE4FDE1F0;
        mem[2719] = 32'hF608F506;
        mem[2720] = 32'h0DFB0D19;
        mem[2721] = 32'hEB27EE04;
        mem[2722] = 32'h0DF5FB2F;
        mem[2723] = 32'h08F50A23;
        mem[2724] = 32'hE71331E2;
        mem[2725] = 32'hE706FF07;
        mem[2726] = 32'hF20BE313;
        mem[2727] = 32'h03F0EA0F;
        mem[2728] = 32'h1D0118E9;
        mem[2729] = 32'hD9F909F0;
        mem[2730] = 32'hD8D7E322;
        mem[2731] = 32'hE40E072E;
        mem[2732] = 32'hF7EC1AD9;
        mem[2733] = 32'hEA12F81A;
        mem[2734] = 32'hDCFE15CB;
        mem[2735] = 32'hDCFDFCED;
        mem[2736] = 32'h26EECCFD;
        mem[2737] = 32'h0225F204;
        mem[2738] = 32'hEED82A27;
        mem[2739] = 32'hFAF1E51E;
        mem[2740] = 32'h38B201F6;
        mem[2741] = 32'hFC09EA07;
        mem[2742] = 32'h1A1C1096;
        mem[2743] = 32'hEFBF1FD6;
        mem[2744] = 32'hDA34D9D8;
        mem[2745] = 32'hF1EA0211;
        mem[2746] = 32'hDFC81318;
        mem[2747] = 32'h0BEAF656;
        mem[2748] = 32'h1ADB16D2;
        mem[2749] = 32'hE00E01FB;
        mem[2750] = 32'h16240E92;
        mem[2751] = 32'h16DE3CFC;
        mem[2752] = 32'hDC47020B;
        mem[2753] = 32'h04FE170A;
        mem[2754] = 32'hFADC0417;
        mem[2755] = 32'hF7E0F12C;
        mem[2756] = 32'hEEF3F7E5;
        mem[2757] = 32'h02060204;
        mem[2758] = 32'h252007A2;
        mem[2759] = 32'h02FE0CF8;
        mem[2760] = 32'hF52B02E2;
        mem[2761] = 32'hFBF61F04;
        mem[2762] = 32'h0818F41A;
        mem[2763] = 32'hF614E60D;
        mem[2764] = 32'h11CDF0EB;
        mem[2765] = 32'hF519E911;
        mem[2766] = 32'h121605A2;
        mem[2767] = 32'h08FEF4E5;
        mem[2768] = 32'hF41AFDE5;
        mem[2769] = 32'hE315E4F8;
        mem[2770] = 32'h1BF8F702;
        mem[2771] = 32'hF511E9F7;
        mem[2772] = 32'h3AF4FC17;
        mem[2773] = 32'hDC22EF03;
        mem[2774] = 32'h20D706CA;
        mem[2775] = 32'h2ECC02E9;
        mem[2776] = 32'hE0DD260C;
        mem[2777] = 32'hF515F11F;
        mem[2778] = 32'h30DCF1FE;
        mem[2779] = 32'hE414EBF5;
        mem[2780] = 32'h09F9E918;
        mem[2781] = 32'hF802E612;
        mem[2782] = 32'h3CBB30DD;
        mem[2783] = 32'h45CA1C08;
        mem[2784] = 32'hD3E33815;
        mem[2785] = 32'h08F30FFF;
        mem[2786] = 32'h230D03FC;
        mem[2787] = 32'hD81EF1F6;
        mem[2788] = 32'h092A10E1;
        mem[2789] = 32'hE40C041D;
        mem[2790] = 32'h35E430E2;
        mem[2791] = 32'h300519E1;
        mem[2792] = 32'hE4E01FFE;
        mem[2793] = 32'hFE18FBFC;
        mem[2794] = 32'h072AFC03;
        mem[2795] = 32'hF60705FF;
        mem[2796] = 32'h0520E2F2;
        mem[2797] = 32'h01EDFE23;
        mem[2798] = 32'h05F618D2;
        mem[2799] = 32'hFF17F201;
        mem[2800] = 32'hF6CF1C13;
        mem[2801] = 32'h0DF4F2DD;
        mem[2802] = 32'h022AF5F3;
        mem[2803] = 32'hFDD60EF4;
        mem[2804] = 32'h03FBF2F2;
        mem[2805] = 32'h05CE0507;
        mem[2806] = 32'h0D031DEF;
        mem[2807] = 32'h00372803;
        mem[2808] = 32'hF5E21215;
        mem[2809] = 32'hD6FDF021;
        mem[2810] = 32'hCF1DF0D8;
        mem[2811] = 32'h19FB0FF8;
        mem[2812] = 32'h06E50A09;
        mem[2813] = 32'hEEE003F3;
        mem[2814] = 32'h0D051AE8;
        mem[2815] = 32'hF2291AEA;
        mem[2816] = 32'h01EFF3E8;
        mem[2817] = 32'h181608F2;
        mem[2818] = 32'hEF231308;
        mem[2819] = 32'h12F7EFF0;
        mem[2820] = 32'h0401F504;
        mem[2821] = 32'h02F41C1A;
        mem[2822] = 32'h210C06F2;
        mem[2823] = 32'hD9140019;
        mem[2824] = 32'h02FFEEFB;
        mem[2825] = 32'h0DEE121B;
        mem[2826] = 32'hEB311D15;
        mem[2827] = 32'hE9F903FC;
        mem[2828] = 32'h1312181D;
        mem[2829] = 32'h08F90630;
        mem[2830] = 32'h15140AE5;
        mem[2831] = 32'hF0F60E1E;
        mem[2832] = 32'hEE0CF009;
        mem[2833] = 32'h03F6EBE8;
        mem[2834] = 32'hEC0BFAE9;
        mem[2835] = 32'h060F0D09;
        mem[2836] = 32'h17D808F7;
        mem[2837] = 32'hEDDCFF2A;
        mem[2838] = 32'h00FE06E1;
        mem[2839] = 32'h1A0F240E;
        mem[2840] = 32'hEE370F00;
        mem[2841] = 32'hF2FA0321;
        mem[2842] = 32'hFC010AF3;
        mem[2843] = 32'h09090FFF;
        mem[2844] = 32'hEC040EFB;
        mem[2845] = 32'hF8D1FF01;
        mem[2846] = 32'hF80B08DF;
        mem[2847] = 32'h180C33F2;
        mem[2848] = 32'hF429FCFE;
        mem[2849] = 32'h13F300F4;
        mem[2850] = 32'h040A0EFC;
        mem[2851] = 32'hF6F9FBF0;
        mem[2852] = 32'h02EDFB0B;
        mem[2853] = 32'hF0C2050B;
        mem[2854] = 32'hFC1807DD;
        mem[2855] = 32'hFEF419E4;
        mem[2856] = 32'hE325E8D2;
        mem[2857] = 32'h0118E714;
        mem[2858] = 32'h0A0F12F7;
        mem[2859] = 32'h1C0811FE;
        mem[2860] = 32'h1BF7150B;
        mem[2861] = 32'hECEDF739;
        mem[2862] = 32'h0E1F0C01;
        mem[2863] = 32'h01F71AE6;
        mem[2864] = 32'hFB4FF6E4;
        mem[2865] = 32'h080E2827;
        mem[2866] = 32'h11F008FA;
        mem[2867] = 32'hF5E4EBE4;
        mem[2868] = 32'h0000F204;
        mem[2869] = 32'h14EB252C;
        mem[2870] = 32'hE6FAEEE2;
        mem[2871] = 32'h121A0104;
        mem[2872] = 32'h070C03F5;
        mem[2873] = 32'hF403EC07;
        mem[2874] = 32'h15E9EDF2;
        mem[2875] = 32'h07FCFA03;
        mem[2876] = 32'hFCF0F0F0;
        mem[2877] = 32'hFBCCF210;
        mem[2878] = 32'hF506EFF5;
        mem[2879] = 32'hF105F1F6;
        mem[2880] = 32'h01F202FC;
        mem[2881] = 32'h21122316;
        mem[2882] = 32'h0104EF22;
        mem[2883] = 32'hE9E2011B;
        mem[2884] = 32'hE81641F8;
        mem[2885] = 32'hEF0AFA11;
        mem[2886] = 32'hDB0AF4E4;
        mem[2887] = 32'hDFF3F409;
        mem[2888] = 32'h1F0B15F6;
        mem[2889] = 32'h0AF3F5F0;
        mem[2890] = 32'hDDDCF541;
        mem[2891] = 32'hD1FDF91E;
        mem[2892] = 32'h161028CF;
        mem[2893] = 32'h04FCDE04;
        mem[2894] = 32'hFD0E20EA;
        mem[2895] = 32'hE1E2F6EE;
        mem[2896] = 32'h24E0C70E;
        mem[2897] = 32'hF0FEDEF6;
        mem[2898] = 32'hECF0211B;
        mem[2899] = 32'hF4FFE42F;
        mem[2900] = 32'h38B1FEC7;
        mem[2901] = 32'hE106ECF1;
        mem[2902] = 32'h161B0DBA;
        mem[2903] = 32'hFDE42CEF;
        mem[2904] = 32'hE030EE0F;
        mem[2905] = 32'hEC132416;
        mem[2906] = 32'hE7C6101E;
        mem[2907] = 32'h0CC3F039;
        mem[2908] = 32'h2AFA1D05;
        mem[2909] = 32'h040C121E;
        mem[2910] = 32'h0C1E0E90;
        mem[2911] = 32'h17D92BE6;
        mem[2912] = 32'hDC57060D;
        mem[2913] = 32'hE811F8FA;
        mem[2914] = 32'hF2E1FD22;
        mem[2915] = 32'h03D6013F;
        mem[2916] = 32'hECFA08E3;
        mem[2917] = 32'hFDEEEF23;
        mem[2918] = 32'h191DFDA5;
        mem[2919] = 32'hFEF70FE3;
        mem[2920] = 32'hF337EBE9;
        mem[2921] = 32'hF0EAED0F;
        mem[2922] = 32'hF3F0E105;
        mem[2923] = 32'hFB05DF27;
        mem[2924] = 32'h18EFF102;
        mem[2925] = 32'hDF24E511;
        mem[2926] = 32'h1C1E1699;
        mem[2927] = 32'h00F1E305;
        mem[2928] = 32'h091008FA;
        mem[2929] = 32'hF4E8FC05;
        mem[2930] = 32'h18EBF603;
        mem[2931] = 32'h0B19F601;
        mem[2932] = 32'h1FD1D8FF;
        mem[2933] = 32'hF618F026;
        mem[2934] = 32'h34F523D3;
        mem[2935] = 32'h22C8FCF7;
        mem[2936] = 32'hF4F82BF7;
        mem[2937] = 32'h22ECF5F9;
        mem[2938] = 32'h45F5FF05;
        mem[2939] = 32'hEB1FE7F4;
        mem[2940] = 32'h23F2F4EF;
        mem[2941] = 32'hCFFFE923;
        mem[2942] = 32'h32B329D2;
        mem[2943] = 32'h34D209DD;
        mem[2944] = 32'hF2E62B05;
        mem[2945] = 32'hF90E0C08;
        mem[2946] = 32'h2906FFFA;
        mem[2947] = 32'hD42E08FF;
        mem[2948] = 32'hF7070B03;
        mem[2949] = 32'h0B17ED04;
        mem[2950] = 32'h38E029BD;
        mem[2951] = 32'h2AF514D7;
        mem[2952] = 32'h09023C14;
        mem[2953] = 32'hE6F9F506;
        mem[2954] = 32'h0520EBEF;
        mem[2955] = 32'h01071806;
        mem[2956] = 32'h0B16F6E5;
        mem[2957] = 32'hFE081005;
        mem[2958] = 32'h17E822EA;
        mem[2959] = 32'hFB1DF9EA;
        mem[2960] = 32'h00D31702;
        mem[2961] = 32'hEB0823FD;
        mem[2962] = 32'h0834020D;
        mem[2963] = 32'hFDDA0C00;
        mem[2964] = 32'h0CF2F608;
        mem[2965] = 32'h02CEFAFF;
        mem[2966] = 32'h1DFB2FE7;
        mem[2967] = 32'hEA1FFEFB;
        mem[2968] = 32'hFAE11EFE;
        mem[2969] = 32'h0B00EB13;
        mem[2970] = 32'hEB2DFDFE;
        mem[2971] = 32'h09DB03EC;
        mem[2972] = 32'hFEDFF0F9;
        mem[2973] = 32'hFECC0702;
        mem[2974] = 32'h10051CF3;
        mem[2975] = 32'hE0FB09FF;
        mem[2976] = 32'hF6F7FAFF;
        mem[2977] = 32'h0600E108;
        mem[2978] = 32'hF0330D04;
        mem[2979] = 32'h15F90FED;
        mem[2980] = 32'hF30B1819;
        mem[2981] = 32'h0901031D;
        mem[2982] = 32'h1113FEFA;
        mem[2983] = 32'hE428F00A;
        mem[2984] = 32'hF9F8EC0D;
        mem[2985] = 32'h07070BF2;
        mem[2986] = 32'hE124100F;
        mem[2987] = 32'hEDF802EC;
        mem[2988] = 32'h170F1425;
        mem[2989] = 32'h0503061C;
        mem[2990] = 32'h0C0DEFEC;
        mem[2991] = 32'hE1E9F70B;
        mem[2992] = 32'hDB06EA01;
        mem[2993] = 32'hF2FE0BFF;
        mem[2994] = 32'hF8180501;
        mem[2995] = 32'hEAF9FEF6;
        mem[2996] = 32'h22ED1F08;
        mem[2997] = 32'hE9F50609;
        mem[2998] = 32'h020C0EE8;
        mem[2999] = 32'h00E007E2;
        mem[3000] = 32'hFD2C00EC;
        mem[3001] = 32'hE70EE123;
        mem[3002] = 32'hF2F901E5;
        mem[3003] = 32'hF80601E9;
        mem[3004] = 32'hF9FB07F0;
        mem[3005] = 32'hFCCE052E;
        mem[3006] = 32'hFA2709BD;
        mem[3007] = 32'hE8E8F7E1;
        mem[3008] = 32'hE829EFEF;
        mem[3009] = 32'hEB191514;
        mem[3010] = 32'hE9F9F7E9;
        mem[3011] = 32'h0D0112F6;
        mem[3012] = 32'h040E05F5;
        mem[3013] = 32'hF8C8031D;
        mem[3014] = 32'hF82504DC;
        mem[3015] = 32'hF7ED1DE3;
        mem[3016] = 32'hF83004D7;
        mem[3017] = 32'h0DEB10FC;
        mem[3018] = 32'h030112F9;
        mem[3019] = 32'h0CFE06F2;
        mem[3020] = 32'h131005FE;
        mem[3021] = 32'hF2DC0024;
        mem[3022] = 32'h0F1E08F2;
        mem[3023] = 32'hF9001805;
        mem[3024] = 32'hE61ED6D5;
        mem[3025] = 32'hFD10F2ED;
        mem[3026] = 32'h0FF9FAE9;
        mem[3027] = 32'h190007F9;
        mem[3028] = 32'h08FCF8FA;
        mem[3029] = 32'hF7C8122D;
        mem[3030] = 32'hFA0E07F0;
        mem[3031] = 32'h0104FDFE;
        mem[3032] = 32'hF313DDEE;
        mem[3033] = 32'h120400F2;
        mem[3034] = 32'h1EF004E8;
        mem[3035] = 32'h0502FBF7;
        mem[3036] = 32'h0AFEF806;
        mem[3037] = 32'h09D80914;
        mem[3038] = 32'hFD0FF301;
        mem[3039] = 32'h0B1B0910;
        mem[3040] = 32'h07F7FB06;
        mem[3041] = 32'h08E1F0F3;
        mem[3042] = 32'h02F8E80E;
        mem[3043] = 32'hFCDE090E;
        mem[3044] = 32'hD61227C2;
        mem[3045] = 32'hE8E2F51D;
        mem[3046] = 32'h14EFF8F2;
        mem[3047] = 32'h010A061C;
        mem[3048] = 32'h130201ED;
        mem[3049] = 32'h19E002E3;
        mem[3050] = 32'hEFDD0E53;
        mem[3051] = 32'hDAF1F621;
        mem[3052] = 32'h0E0E1FB8;
        mem[3053] = 32'h0A2AFA0C;
        mem[3054] = 32'h072529DE;
        mem[3055] = 32'hEF15F803;
        mem[3056] = 32'h34EBD615;
        mem[3057] = 32'hE00201EB;
        mem[3058] = 32'h05F42246;
        mem[3059] = 32'h1EF0F839;
        mem[3060] = 32'h4EBF1DDF;
        mem[3061] = 32'hE9FCE3F6;
        mem[3062] = 32'h19271AA3;
        mem[3063] = 32'hFFDC39EE;
        mem[3064] = 32'hE1420AF6;
        mem[3065] = 32'h040F0DE0;
        mem[3066] = 32'hFBE91933;
        mem[3067] = 32'h0EBFF550;
        mem[3068] = 32'h11E812DD;
        mem[3069] = 32'h0520FB27;
        mem[3070] = 32'h1F331D9F;
        mem[3071] = 32'h15C92A07;
        mem[3072] = 32'hD43F0313;
        mem[3073] = 32'hEC10F6E2;
        mem[3074] = 32'hF9EC0C1F;
        mem[3075] = 32'hE7F3F235;
        mem[3076] = 32'hF903FDED;
        mem[3077] = 32'hFC02EC1F;
        mem[3078] = 32'h252C18B7;
        mem[3079] = 32'hFF041307;
        mem[3080] = 32'h0638FE11;
        mem[3081] = 32'hF2061AED;
        mem[3082] = 32'h010AE817;
        mem[3083] = 32'hF6F9DD28;
        mem[3084] = 32'h2AE501F4;
        mem[3085] = 32'h171CF820;
        mem[3086] = 32'h243F30C1;
        mem[3087] = 32'h110F01EC;
        mem[3088] = 32'hF30CF8EF;
        mem[3089] = 32'h1A25FE16;
        mem[3090] = 32'h1FE2E402;
        mem[3091] = 32'hFB06E7FA;
        mem[3092] = 32'h32E6FFE0;
        mem[3093] = 32'hEB03EB1B;
        mem[3094] = 32'h33F423F7;
        mem[3095] = 32'h2FD7FADB;
        mem[3096] = 32'h00FE2CFD;
        mem[3097] = 32'h08F6F00A;
        mem[3098] = 32'h2CE7FCE7;
        mem[3099] = 32'hF02FE7FB;
        mem[3100] = 32'h26FA0AE7;
        mem[3101] = 32'hF403F825;
        mem[3102] = 32'h25B618E2;
        mem[3103] = 32'h36CB10E7;
        mem[3104] = 32'hD9F123F8;
        mem[3105] = 32'hF11101F0;
        mem[3106] = 32'h1A0AFAEE;
        mem[3107] = 32'hD52CE8E9;
        mem[3108] = 32'hECFCF102;
        mem[3109] = 32'hF91EFA06;
        mem[3110] = 32'h32E01DC9;
        mem[3111] = 32'h27FF0EE4;
        mem[3112] = 32'hFCC21714;
        mem[3113] = 32'hF4DDE7E3;
        mem[3114] = 32'hF01DE4E2;
        mem[3115] = 32'hE3F3F5F7;
        mem[3116] = 32'hFA10F9F8;
        mem[3117] = 32'h0CFA0CFD;
        mem[3118] = 32'h160717DD;
        mem[3119] = 32'h171E0CE2;
        mem[3120] = 32'hFAF61308;
        mem[3121] = 32'hF920E80A;
        mem[3122] = 32'hE507E1E4;
        mem[3123] = 32'h1FE61705;
        mem[3124] = 32'h1FF119F5;
        mem[3125] = 32'hFA0A0516;
        mem[3126] = 32'hFFE80BE7;
        mem[3127] = 32'hFD270F01;
        mem[3128] = 32'h0DF12300;
        mem[3129] = 32'h02F5ED1C;
        mem[3130] = 32'hE924FFE7;
        mem[3131] = 32'h0EEDFEF0;
        mem[3132] = 32'hF0FDE0F6;
        mem[3133] = 32'h12EE1419;
        mem[3134] = 32'h091316FE;
        mem[3135] = 32'hDA15000C;
        mem[3136] = 32'h02E90DF2;
        mem[3137] = 32'hEAE21C06;
        mem[3138] = 32'hE5220B03;
        mem[3139] = 32'h0AE5F5E8;
        mem[3140] = 32'hFFF9FB0B;
        mem[3141] = 32'h03DD18FE;
        mem[3142] = 32'h131DEEE3;
        mem[3143] = 32'hF032FF19;
        mem[3144] = 32'h0A04FF08;
        mem[3145] = 32'hF9FAF31A;
        mem[3146] = 32'hE9251810;
        mem[3147] = 32'hFF000CFD;
        mem[3148] = 32'h10EE0500;
        mem[3149] = 32'hFCFDFA21;
        mem[3150] = 32'h1A0BF6F0;
        mem[3151] = 32'hF30EFEEB;
        mem[3152] = 32'hF723FE18;
        mem[3153] = 32'h0FFAF802;
        mem[3154] = 32'hF40FF8F3;
        mem[3155] = 32'hFA010904;
        mem[3156] = 32'hF4F8EFF0;
        mem[3157] = 32'h05F0F818;
        mem[3158] = 32'h10150EDB;
        mem[3159] = 32'h0AE4F005;
        mem[3160] = 32'hDD210001;
        mem[3161] = 32'h09F7F8DE;
        mem[3162] = 32'hF7100CED;
        mem[3163] = 32'hF0F9F8E9;
        mem[3164] = 32'hE5E7F623;
        mem[3165] = 32'h07C30715;
        mem[3166] = 32'h071916AF;
        mem[3167] = 32'hFAE111E6;
        mem[3168] = 32'h0234F8F1;
        mem[3169] = 32'hD7FFEA0A;
        mem[3170] = 32'hF8EDFFE6;
        mem[3171] = 32'hF7F4FFEA;
        mem[3172] = 32'h01EF0101;
        mem[3173] = 32'hFBD72018;
        mem[3174] = 32'h0E2107D8;
        mem[3175] = 32'hF80108FD;
        mem[3176] = 32'h0731FDF1;
        mem[3177] = 32'h0FEE1CE6;
        mem[3178] = 32'hFEF7FCEC;
        mem[3179] = 32'h03F206F5;
        mem[3180] = 32'h12F3ED0E;
        mem[3181] = 32'h05E50D1E;
        mem[3182] = 32'h090A08CC;
        mem[3183] = 32'h13EE15FC;
        mem[3184] = 32'hF82EF0E7;
        mem[3185] = 32'hDC1E2500;
        mem[3186] = 32'hFDF201E9;
        mem[3187] = 32'h270C1B11;
        mem[3188] = 32'h0F070000;
        mem[3189] = 32'hECC20230;
        mem[3190] = 32'hF708FEF9;
        mem[3191] = 32'h070A0114;
        mem[3192] = 32'h001405F4;
        mem[3193] = 32'hFC140119;
        mem[3194] = 32'h1200FDDD;
        mem[3195] = 32'hF8FCF1F7;
        mem[3196] = 32'hFBF9E5F7;
        mem[3197] = 32'hEAD60C2F;
        mem[3198] = 32'hE4FBE4F4;
        mem[3199] = 32'hE9F8E1F2;
        mem[3200] = 32'hE9E5F0FF;
        mem[3201] = 32'hE0F1FA27;
        mem[3202] = 32'hFFFAEE15;
        mem[3203] = 32'hDCE00E1C;
        mem[3204] = 32'hD61535BC;
        mem[3205] = 32'hEB21EE2F;
        mem[3206] = 32'hF2EF15E9;
        mem[3207] = 32'hF706EF14;
        mem[3208] = 32'h0DF90AF5;
        mem[3209] = 32'h1B00F9E8;
        mem[3210] = 32'hE9F50144;
        mem[3211] = 32'hC4F4F530;
        mem[3212] = 32'h060B1FE8;
        mem[3213] = 32'h000B051D;
        mem[3214] = 32'hFD181FE4;
        mem[3215] = 32'h04020D18;
        mem[3216] = 32'h46F5E111;
        mem[3217] = 32'hF904F400;
        mem[3218] = 32'hE9DBFF0C;
        mem[3219] = 32'h13FDF52B;
        mem[3220] = 32'h2DCC23F3;
        mem[3221] = 32'h0C320229;
        mem[3222] = 32'h1F1D1896;
        mem[3223] = 32'hF8C930E0;
        mem[3224] = 32'hD33BFC06;
        mem[3225] = 32'h0C12F0EE;
        mem[3226] = 32'h14D90D3E;
        mem[3227] = 32'h11AF0455;
        mem[3228] = 32'h05CF0DDC;
        mem[3229] = 32'hE50F0613;
        mem[3230] = 32'h27262998;
        mem[3231] = 32'h08DE1DDF;
        mem[3232] = 32'hC535F9F0;
        mem[3233] = 32'hEFE408FE;
        mem[3234] = 32'hDFDB0617;
        mem[3235] = 32'hDDD3E533;
        mem[3236] = 32'h042213E8;
        mem[3237] = 32'hF811FD09;
        mem[3238] = 32'h112E0DA3;
        mem[3239] = 32'h10FB2607;
        mem[3240] = 32'hF036EFEF;
        mem[3241] = 32'hE7FA090E;
        mem[3242] = 32'hFBFDDC1D;
        mem[3243] = 32'h0302F237;
        mem[3244] = 32'h3CEB05DD;
        mem[3245] = 32'hE70FDFFE;
        mem[3246] = 32'h14370CB5;
        mem[3247] = 32'h0C0BF600;
        mem[3248] = 32'hF414F3F7;
        mem[3249] = 32'hF61DD9E0;
        mem[3250] = 32'h1BDDF8EA;
        mem[3251] = 32'h0A1808FD;
        mem[3252] = 32'h23E0EFFD;
        mem[3253] = 32'hF210EB19;
        mem[3254] = 32'h2DE00FBC;
        mem[3255] = 32'h1ADFF9FD;
        mem[3256] = 32'h08143A15;
        mem[3257] = 32'hFFF903FE;
        mem[3258] = 32'h32F0FF01;
        mem[3259] = 32'hE719E0F3;
        mem[3260] = 32'h1AF7F7D5;
        mem[3261] = 32'h05FBF020;
        mem[3262] = 32'h2BC415BF;
        mem[3263] = 32'h34E512E3;
        mem[3264] = 32'hF1E74115;
        mem[3265] = 32'h0A110B0E;
        mem[3266] = 32'h0001F1F0;
        mem[3267] = 32'hE83104F6;
        mem[3268] = 32'h021A04F2;
        mem[3269] = 32'hDFF7E214;
        mem[3270] = 32'h2CD80ECC;
        mem[3271] = 32'h2AF10BF0;
        mem[3272] = 32'h03E92CF7;
        mem[3273] = 32'hE6F30304;
        mem[3274] = 32'hFC21EAF2;
        mem[3275] = 32'hEFF902FF;
        mem[3276] = 32'hFCFEFB0B;
        mem[3277] = 32'hE4E4E702;
        mem[3278] = 32'h03E908D2;
        mem[3279] = 32'h0102E9D8;
        mem[3280] = 32'h03D022FA;
        mem[3281] = 32'hEE06F3FC;
        mem[3282] = 32'hE914F2E5;
        mem[3283] = 32'h15D71C02;
        mem[3284] = 32'h05FCFA00;
        mem[3285] = 32'h03ECF3FB;
        mem[3286] = 32'h130611F0;
        mem[3287] = 32'h111004DC;
        mem[3288] = 32'h0EFC1F1E;
        mem[3289] = 32'hEEF0F510;
        mem[3290] = 32'hF51C0202;
        mem[3291] = 32'h22E70F01;
        mem[3292] = 32'h1BEC1A00;
        mem[3293] = 32'h0EE31F18;
        mem[3294] = 32'hFD0324E9;
        mem[3295] = 32'hF3210BDB;
        mem[3296] = 32'h0AE4061E;
        mem[3297] = 32'h02041FF6;
        mem[3298] = 32'hDD12F3FC;
        mem[3299] = 32'h20F00603;
        mem[3300] = 32'hEBF300EF;
        mem[3301] = 32'h06ED020A;
        mem[3302] = 32'hF816E800;
        mem[3303] = 32'hE236F616;
        mem[3304] = 32'h0602F400;
        mem[3305] = 32'h0EFDE80F;
        mem[3306] = 32'hDE1307F4;
        mem[3307] = 32'h0D112E16;
        mem[3308] = 32'hF9DFFBFA;
        mem[3309] = 32'h16EBF80B;
        mem[3310] = 32'h1C1910E2;
        mem[3311] = 32'h0C0709FA;
        mem[3312] = 32'hE010F0E0;
        mem[3313] = 32'hF00C0E07;
        mem[3314] = 32'hECF9FFFB;
        mem[3315] = 32'h0C08FE02;
        mem[3316] = 32'h0FF81C21;
        mem[3317] = 32'hF2F4140E;
        mem[3318] = 32'h271D17DD;
        mem[3319] = 32'h1DFD060B;
        mem[3320] = 32'hDE1DE2EA;
        mem[3321] = 32'hE616F1F0;
        mem[3322] = 32'hF0F4FAEB;
        mem[3323] = 32'hF90A01FB;
        mem[3324] = 32'hF0081119;
        mem[3325] = 32'h02EC1309;
        mem[3326] = 32'h0A0C12D4;
        mem[3327] = 32'h070929F2;
        mem[3328] = 32'h063DF1EF;
        mem[3329] = 32'hF9E00F0B;
        mem[3330] = 32'h0F0B1F00;
        mem[3331] = 32'hFAEEFAEB;
        mem[3332] = 32'hF010FD1A;
        mem[3333] = 32'hEED1FD2F;
        mem[3334] = 32'hF11E02EA;
        mem[3335] = 32'hF7150706;
        mem[3336] = 32'hFF430E03;
        mem[3337] = 32'h02EBFBF6;
        mem[3338] = 32'h0BFA0EF8;
        mem[3339] = 32'h0DF304FB;
        mem[3340] = 32'h1B0501FE;
        mem[3341] = 32'hEEC7011D;
        mem[3342] = 32'hF6F2EDEA;
        mem[3343] = 32'h05D9FEDD;
        mem[3344] = 32'hFF25DEED;
        mem[3345] = 32'h1C20FDFD;
        mem[3346] = 32'h17EE08FB;
        mem[3347] = 32'h04E9EFE7;
        mem[3348] = 32'h05FDF6FE;
        mem[3349] = 32'h17CE0A18;
        mem[3350] = 32'h0016FFF4;
        mem[3351] = 32'hFF0C0FFC;
        mem[3352] = 32'h0D27E70B;
        mem[3353] = 32'hF306F2F6;
        mem[3354] = 32'h230A0FFC;
        mem[3355] = 32'h1006020B;
        mem[3356] = 32'hFDF9EAFB;
        mem[3357] = 32'h05D61028;
        mem[3358] = 32'hFB0BF907;
        mem[3359] = 32'hEA05ECFF;
        mem[3360] = 32'h03E8FD07;
        mem[3361] = 32'h1002091E;
        mem[3362] = 32'h07E8EA03;
        mem[3363] = 32'hD7D21F21;
        mem[3364] = 32'hF71046CF;
        mem[3365] = 32'hFF01DD22;
        mem[3366] = 32'hF3F2E205;
        mem[3367] = 32'hF115F7E6;
        mem[3368] = 32'h170908EA;
        mem[3369] = 32'hED04F5E7;
        mem[3370] = 32'hD3D3F743;
        mem[3371] = 32'hCBE2E92E;
        mem[3372] = 32'h14FE33E7;
        mem[3373] = 32'h1CF0FB14;
        mem[3374] = 32'hF5322FFB;
        mem[3375] = 32'h031BF60A;
        mem[3376] = 32'h47D9B51E;
        mem[3377] = 32'hF6F51DFE;
        mem[3378] = 32'hF7EA152C;
        mem[3379] = 32'hF2CCEB24;
        mem[3380] = 32'h3ECB11D5;
        mem[3381] = 32'hF210F7FD;
        mem[3382] = 32'h221C2A9E;
        mem[3383] = 32'hF4F12ED1;
        mem[3384] = 32'hED3B08F2;
        mem[3385] = 32'hFC021D1C;
        mem[3386] = 32'hEED4F432;
        mem[3387] = 32'h0BBFFB51;
        mem[3388] = 32'hF4CA1501;
        mem[3389] = 32'hF1FEFAF3;
        mem[3390] = 32'h251222AC;
        mem[3391] = 32'h10DB34E1;
        mem[3392] = 32'hD03BFFF4;
        mem[3393] = 32'hF6F806E5;
        mem[3394] = 32'h00D5F61C;
        mem[3395] = 32'hEFE7FD37;
        mem[3396] = 32'h1013FAF1;
        mem[3397] = 32'hFC10F90F;
        mem[3398] = 32'h151A03A7;
        mem[3399] = 32'hE5F4F5DB;
        mem[3400] = 32'hDB38F400;
        mem[3401] = 32'hF309F4F6;
        mem[3402] = 32'hEA08D50F;
        mem[3403] = 32'h10EEEA18;
        mem[3404] = 32'h22F401E1;
        mem[3405] = 32'hF2F40810;
        mem[3406] = 32'h2B3C22C9;
        mem[3407] = 32'h11F7F1C5;
        mem[3408] = 32'hF915F2E8;
        mem[3409] = 32'h0A0406EB;
        mem[3410] = 32'hFCE4D1F2;
        mem[3411] = 32'hF5FAE5FD;
        mem[3412] = 32'h53F40CF6;
        mem[3413] = 32'h1604EF02;
        mem[3414] = 32'h25EE12C2;
        mem[3415] = 32'h43F403FF;
        mem[3416] = 32'hE0070800;
        mem[3417] = 32'h0EF80219;
        mem[3418] = 32'h13E9F703;
        mem[3419] = 32'hFC3B050F;
        mem[3420] = 32'h2DE21B02;
        mem[3421] = 32'hE21F0722;
        mem[3422] = 32'h55D539D4;
        mem[3423] = 32'h65ED34E7;
        mem[3424] = 32'hF4E62107;
        mem[3425] = 32'h08FDE20F;
        mem[3426] = 32'h0118E3E5;
        mem[3427] = 32'hDF490B1A;
        mem[3428] = 32'h0A210C09;
        mem[3429] = 32'h0006F60B;
        mem[3430] = 32'h49D829DC;
        mem[3431] = 32'h1CDEF7D2;
        mem[3432] = 32'hFEFA2400;
        mem[3433] = 32'hDFF00A05;
        mem[3434] = 32'hEF1BFCEE;
        mem[3435] = 32'hF2FEFFF8;
        mem[3436] = 32'hF9DE1ADC;
        mem[3437] = 32'hF608FD14;
        mem[3438] = 32'hFDF705D0;
        mem[3439] = 32'hFF14FF0A;
        mem[3440] = 32'hF3C7FF0A;
        mem[3441] = 32'h020F0EFA;
        mem[3442] = 32'hF61D0AEB;
        mem[3443] = 32'h14CF1A04;
        mem[3444] = 32'h0B0009F3;
        mem[3445] = 32'hE8EAFB06;
        mem[3446] = 32'h09FF15DE;
        mem[3447] = 32'hFC1B0405;
        mem[3448] = 32'hFCD503FB;
        mem[3449] = 32'hE208F7FD;
        mem[3450] = 32'hE50DFEE3;
        mem[3451] = 32'h11D900EC;
        mem[3452] = 32'h03F1FCFD;
        mem[3453] = 32'h09F4FB14;
        mem[3454] = 32'hFB1611D7;
        mem[3455] = 32'h0623FA11;
        mem[3456] = 32'h10D81D0E;
        mem[3457] = 32'h1A0C0EE6;
        mem[3458] = 32'hF3290606;
        mem[3459] = 32'h0DDCEDEC;
        mem[3460] = 32'hFAF1FCDE;
        mem[3461] = 32'h0AF22322;
        mem[3462] = 32'hD521D8D7;
        mem[3463] = 32'hF549F200;
        mem[3464] = 32'h1AFC0403;
        mem[3465] = 32'h11E2E5F5;
        mem[3466] = 32'hF2080FF5;
        mem[3467] = 32'hFC01160D;
        mem[3468] = 32'h1FF02901;
        mem[3469] = 32'hFEF8FE05;
        mem[3470] = 32'h0E17F5EA;
        mem[3471] = 32'hE4F9EC0B;
        mem[3472] = 32'hEF0FE216;
        mem[3473] = 32'hD7F50E04;
        mem[3474] = 32'hEEFAEBFF;
        mem[3475] = 32'h061A0913;
        mem[3476] = 32'h1EEF1DF3;
        mem[3477] = 32'h04EC1112;
        mem[3478] = 32'h120905D2;
        mem[3479] = 32'h28EB11DF;
        mem[3480] = 32'hF71AE40B;
        mem[3481] = 32'h0E0C29E4;
        mem[3482] = 32'h06171206;
        mem[3483] = 32'hF80902F6;
        mem[3484] = 32'hEE111208;
        mem[3485] = 32'hF0E9192D;
        mem[3486] = 32'h1A1A0ED3;
        mem[3487] = 32'h01F71AD6;
        mem[3488] = 32'hF729EEE7;
        mem[3489] = 32'hFDF9F90A;
        mem[3490] = 32'h03FD05EC;
        mem[3491] = 32'h110709FF;
        mem[3492] = 32'h1901F5FE;
        mem[3493] = 32'h10DDFD01;
        mem[3494] = 32'h040A05DF;
        mem[3495] = 32'hFBEC04F4;
        mem[3496] = 32'hD722E4DF;
        mem[3497] = 32'hFA15F11C;
        mem[3498] = 32'h160317FE;
        mem[3499] = 32'h06FD01F9;
        mem[3500] = 32'h07E2F2F7;
        mem[3501] = 32'h23D2FE13;
        mem[3502] = 32'hFA150BCA;
        mem[3503] = 32'h14ECF4FF;
        mem[3504] = 32'h114D0D03;
        mem[3505] = 32'hF1D70406;
        mem[3506] = 32'h12FC06E9;
        mem[3507] = 32'h10F6FEF7;
        mem[3508] = 32'h040BFF06;
        mem[3509] = 32'hE1CCEC08;
        mem[3510] = 32'hEE0EE9D7;
        mem[3511] = 32'hF70400F3;
        mem[3512] = 32'h2103FFED;
        mem[3513] = 32'h0EF70308;
        mem[3514] = 32'h0AFB03E3;
        mem[3515] = 32'h0AFBFDFD;
        mem[3516] = 32'hF80DF10C;
        mem[3517] = 32'h07EB1511;
        mem[3518] = 32'h0A19FC15;
        mem[3519] = 32'hEE07F3FB;
        mem[3520] = 32'h03F4FF15;
        mem[3521] = 32'h1FF4FE08;
        mem[3522] = 32'hFAE50928;
        mem[3523] = 32'hC4DEEE40;
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
