YTU-YODA-KYBER/2026_teknofest-mikrodenetleyici-tasarimi/FPGA/main_codes/testbench/uvm/agents/i2c_slave_pkg.sv

//=============================================================================
//  i2c_slave_pkg.sv  --  I2C slave agent'i (protokol seviyesinde)
//
//  YTU YODA KYBER  |  TEKNOFEST 2026
//
//  Gercek bir I2C slave gibi davranir: START/STOP/repeated-START kosullarini
//  hattan cozer, adresini eslestirir, ACK/NACK surer, yazma verisini yakalar
//  ve okuma verisini dondurur. Hicbir yerde DUT hiyerarsisine bakmaz ve
//  zamanlama sabiti icermez -- yalnizca SCL kenarlarina bakar:
//
//    * bit ornekleme  : SCL yukselen kenari
//    * bit surme      : SCL dusen kenari
//    * START          : SCL yuksekken SDA dusuyor
//    * STOP           : SCL yuksekken SDA yukseliyor
//
//  Hata enjeksiyonu: adres fazinda ya da istenen veri baytinda NACK.
//=============================================================================
`ifndef I2C_SLAVE_PKG_SV
`define I2C_SLAVE_PKG_SV
`timescale 1ns/1ps

package i2c_slave_pkg;

    import uvm_pkg::*;
    `include "uvm_macros.svh"

    //---- Slave'in gordugu tam bir transfer ---------------------------------
    class i2c_txn extends uvm_sequence_item;
        bit [6:0]  adres;
        bit        okuma;         // adres baytindaki R/W biti
        bit [7:0]  veri[$];       // yazilan (master->slave) ya da okunan baytlar
        bit        adres_nack;    // adres fazinda NACK verildi mi
        int        nack_index;    // kacinci veri baytinda NACK verildi (-1 = yok)
        bit        stop_gorundu;

        `uvm_object_utils_begin(i2c_txn)
            `uvm_field_int(adres,        UVM_ALL_ON | UVM_HEX)
            `uvm_field_int(okuma,        UVM_ALL_ON)
            `uvm_field_queue_int(veri,   UVM_ALL_ON | UVM_HEX)
            `uvm_field_int(adres_nack,   UVM_ALL_ON)
            `uvm_field_int(nack_index,   UVM_ALL_ON | UVM_DEC)
            `uvm_field_int(stop_gorundu, UVM_ALL_ON)
        `uvm_object_utils_end

        function new(string name = "i2c_txn");
            super.new(name);
            nack_index = -1;
        endfunction
    endclass


    //---- Slave yapilandirmasi ----------------------------------------------
    class i2c_slave_cfg extends uvm_object;
        `uvm_object_utils(i2c_slave_cfg)

        bit [6:0] adres = 7'h50;

        // Master okurken dondurulecek baytlar (bittiginde 0xFF doner)
        bit [7:0] okuma_verisi[$];

        // Hata enjeksiyonu
        bit       adres_nack   = 1'b0;   // adres baytina NACK ver
        int       veri_nack_at = -1;     // N. yazma veri baytina NACK ver (-1 = yok)

        function new(string name = "i2c_slave_cfg");
            super.new(name);
        endfunction
    endclass


    //---- Slave: kenar gudumlü durum makinesi -----------------------------
    //
    //  Uc paralel surec:
    //    * START/STOP dedektoru : SCL yuksekken SDA kenari
    //    * posedge SCL          : bit ornekleme (master'in surdugu veri)
    //    * negedge SCL          : bit surme    (slave'in surdugu veri/ACK)
    //
    //  Bu ayrim I2C'nin kendi kuralidir ve kritiktir: ic ice task'larla
    //  yazildiginda ACK penceresi ile ilk veri bitinin arasinda bir SCL
    //  kenari kolayca KAYAR ve okuma verisi bir bit kaymis gelir.
    typedef enum {
        P_BOSTA,      // transfer yok
        P_ADRES,      // adres bayti aliniyor
        P_ACK_SUR,    // ACK/NACK'i suracegimiz cevrimin low fazi
        P_ACK_TUT,    // ACK penceresi bitti; siradaki faza gecis
        P_WVERI,      // master veri gonderiyor (yazma)
        P_RVERI,      // slave veri gonderiyor (okuma)
        P_RACK,       // master'in ACK/NACK'ini okuyacagiz
        P_BEKLE       // NACK sonrasi: STOP bekleniyor
    } i2c_faz_e;

    class i2c_slave extends uvm_component;
        `uvm_component_utils(i2c_slave)

        virtual i2c_if               vif;
        i2c_slave_cfg                cfg;
        uvm_analysis_port #(i2c_txn) ap;

        int unsigned n_transfer = 0;
        int unsigned n_bayt     = 0;

        // Protokol durumu
        i2c_faz_e  faz     = P_BOSTA;
        bit [7:0]  sr      = 8'h0;
        int        bitc    = 0;
        bit        ack_val = 1'b0;
        bit        okuma   = 1'b0;
        int        widx    = 0;
        int        ridx    = 0;
        i2c_txn    t;

        function new(string name, uvm_component parent);
            super.new(name, parent);
            ap = new("ap", this);
        endfunction

        function void build_phase(uvm_phase phase);
            super.build_phase(phase);
            if (!uvm_config_db#(virtual i2c_if)::get(this, "", "vif", vif))
                `uvm_fatal("NOVIF", "i2c_if handle bulunamadi")
            if (!uvm_config_db#(i2c_slave_cfg)::get(this, "", "cfg", cfg))
                cfg = i2c_slave_cfg::type_id::create("cfg");
        endfunction

        // Okuma verisi bittiginde 0xFF doner
        function bit [7:0] okuma_bayti(int i);
            return (i < cfg.okuma_verisi.size()) ? cfg.okuma_verisi[i] : 8'hFF;
        endfunction

        function void yayinla(bit stop);
            if (t != null) begin
                t.stop_gorundu = stop;
                n_transfer++;
                ap.write(t);
                t = null;
            end
        endfunction

        function void yeni_transfer();
            yayinla(1'b0);                     // varsa oncekini kapat
            t     = i2c_txn::type_id::create("i2c_txn");
            faz   = P_ADRES;
            sr    = 8'h0;
            bitc  = 8;
            widx  = 0;
            ridx  = 0;
            vif.sda_low = 1'b0;
        endfunction

        task run_phase(uvm_phase phase);
            vif.sda_low = 1'b0;
            fork
                start_stop_dedektoru();
                ornekle();
                sur();
            join
        endtask
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
