YTU-YODA-KYBER/2026_teknofest-mikrodenetleyici-tasarimi/(commit log)

2026-03-28 Timer modülünün IP dosyaları eklendi. (#1)
2026-04-03 Timer modülü daha optimize hale getirildi ve testbench kodu güncellendi.
2026-08-19 Doğrulama klasörü eklendi, kodlar şartnameye göre güncellendi
    [results_board.csv]
2026-09-05 TEKNOFEST 2026 FPGA ve ASIC teslim paketini güncelle
    [macro_placement.cfg, macro_placement_4200x2600.cfg, macro_placement_4200x2800.cfg, macro_placement_4200x3000.cfg, macro_placement_data0_local.cfg, macro_ring_placement.cfg, metrics.csv, net-VGND.csv]
2026-09-06 I2C saatini 400 kHz'e düzelt ve FPGA çıktıları yenile
2026-09-07 Update ASIC deliverables for current I2C RTL
    [metrics.csv, net-VGND.csv, net-VPWR.csv, top_module__max_ff_n40C_1v95.sdf, top_module__max_ss_100C_1v60.sdf, top_module__max_tt_025C_1v80.sdf, top_module__min_ff_n40C_1v95.sdf, top_module__min_ss_100C_1v60.sdf]
2026-09-08 Demo arayüzünü iki fiziksel UART'a taşı, softmax ekle, akışı yeniden doğrula
    TEKNOFEST 2026 FPGA demo test aracı (demo_harness.py) stream ve core
    arayüzlerini iki ayrı seri port olarak aynı anda açıyor. Mevcut tasarım iki
    UART IP'sini tek pin çiftine bindiriyordu; demo bu hâliyle başlayamazdı.
    RTL
    - UART_mux kaldırıldı; UART_GU ve UART_YZ üst modüle kadar ayrı sinyaller.
    Nexys A7: core C4/D4 (kart üstü FT2232), stream Pmod JC F6/J2 (Pmod USBUART).
    - YZ girdi RAM'ine çerçeve senkronizasyon kurtarma: hat 2 ms sessiz kalırsa
    yarım kalmış kayıt atılır. Bu olmadan aracın truncated_frame (1896 bayt) ve
    oversized_frame (+32 bayt) senaryoları yazma sayac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
    [metrics.csv, net-VGND.csv, net-VPWR.csv, regression_results.csv, top_module__max_ff_n40C_1v95.sdf, top_module__max_ss_100C_1v60.sdf, top_module__max_tt_025C_1v80.sdf, top_module__min_ff_n40C_1v95.sdf]
2026-09-09 Instruction RAM veri okuma yolunu tamamla ve demo koşumunu ekle
    Interconnect 0x1000_0000..0x1000_FFFF read adreslerini M8'e decode ediyor,
    ancak M8'in AR/R portları üst modülde bağlı değildi; bu bölgeden yapılan CPU
    load'unda ARREADY hiç gelmiyor ve adres decoder tarafından kapsandığı için
    DECERR de üretilmiyordu. Uygulamanın linker script'i .rodata'yı ve .data yükleme
    imajını bu bölgeye koyduğu için yol gereklidir.
    Instruction fetch ile data read, iki-master AXI read arbitriyle tek Instruction
    RAM read denetleyicisine bağlandı. Arbiter FPGA ve ASIC akışlarının ortak
    kaynağıdır; ASIC'e özel yama olarak tutulan kopya ve ilgili patch_rtl
    dönüşümleri kald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
    [robustness.csv, samples.csv]
2026-09-09 Teslim paketinden şartnamede istenmeyen zamanlama çıktılarını çıkar
    Şartname Bölüm 5.5 Tablo 13 corner başına istenen rapor kümesini tanımlar;
    aşağıdakiler bu kümede yer almaz ve pakete ağırlık dışında bir şey katmıyordu:
    sta.log 667 MB OpenSTA ham konsol günlüğü
    top_module__<corner>.sdf 495 MB results/sdf/ altındakilerle bit-özdeş
    *.process_stats.json,
    _env_*.tcl, filter_unannotated* 1 MB araç telemetrisi
    Tablo 13'ün tamamı (max, min, checks, skew, ws, wns, tns, violator_list,
    clock, unpropagated) dokuz corner için yerinde kalır.
    Tablo 9 versions.txt'yi genel akış raporları arasında listeliyor; dosya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
    [top_module__max_ff_n40C_1v95.sdf, top_module__max_ss_100C_1v60.sdf, top_module__max_tt_025C_1v80.sdf, top_module__min_ff_n40C_1v95.sdf, top_module__min_ss_100C_1v60.sdf, top_module__min_tt_025C_1v80.sdf, top_module__nom_ff_n40C_1v95.sdf, top_module__nom_ss_100C_1v60.sdf]
2026-09-10 FPGA demo paketini, firmware güncellemesini ve demo çıktılarını ekle
    Demo:
    - FPGA/demo/demo_program_tr/ eklendi: demo_gui.py, demo_harness.py,
    OKUBENI.md, public_dataset (156 giriş vektörü) ve 10 Eylül tarihli
    beş koşumun sonuçları (config_used.json, report.md, robustness.csv,
    samples.csv, summary.json, transcript.log).
    - 2026 Demo.pdf eklendi.
    - Eski FPGA/demo/results/ altındaki 9 Eylül koşumu, demo yeni konuma
    taşındığı için kaldırıldı.
    - ytu_yoda_kyber_icd.json güncellendi.
    Firmware:
    - main_app.c ve soc.h güncellendi; makefile_outputs altındaki
    app/app_bootrom/sim_app .elf ve .hex çıktıları yeniden üretildi.
    .gitignore:
    - Demo giriş vektörle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
    [dataset_full.csv, manifest.csv, robustness.csv, samples.csv]
2026-09-10 config.yaml yorumlarını teslim edilen koşumla tutarlı hale getir
    Yapılandırma anahtarlarının HİÇBİRİ değişmedi; yalnızca yorum satırları
    düzeltildi. Düzeltilen üç yanlış ifade:
    1. Anten onarımı bloğu, `RUN_ANTENNA_REPAIR: false` değerini teslim
    edilen koşumu tarif ediyormuş gibi anlatıyordu. Bu TABAN değerdir;
    `make asic_run` üç fazlıdır ve üçüncü faz experiments/antenna_jumper.yaml
    overlay'iyle bu değeri `true` yapar. Gerçek değer
    results/config/resolved.json içinde `RUN_ANTENNA_REPAIR: true` olarak
    görülebilir.
    2. Aynı blok nihai sonucu "3.181 net / 4.874 pin ve 14 yollama DRC"
    olarak veriyordu. Bu TEK FAZLI koşumun sonucud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
2026-09-13 ASIC README'lerini teslim edilen koşumun ölçümleriyle tutarlı hale getir
    asic/README.md — "Zamanlama" bölümündeki 2026-09-03 tarihli güncelleme
    bloğu, teslim edilen 28 MHz koşumunun signoff raporuyla çelişiyor ve
    kendi içinde tutarsızdı:
    - "Frekans tavanını artık SRAM okuma yolları belirlemiyor" deniyordu.
    reports/timing/max_ss_100C_1v60/max.rpt'e göre en kötü setup yolu
    data_bram_ctrl_inst.data_ram.u_mem.g_2k[0].u_cell.u_sram/dout1[17]
    falling-edge çıkışından başlayan YARIM ÇEVRİMLİ bir yoldur (+1,996 ns);
    raporlanan 2.000 yolun en kötü 32'si bu bellekten başlar.
    - "Taze koşumda en kötü yol tam çevrimlidir: instr_rdata_i[18] → regfile
    mu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
